jmrothberg/JMR-JS-CSS-FPGA-COMPUTER/traces/README.md

# traces/

Session logs written by the GUI, one per run: `session_<time>_<machine>.log`.
`LATEST_<machine>.log` is the newest for each machine. Read from the end.
Safe to delete.
