jmrothberg/JMR-JS-CSS-FPGA-COMPUTER/releases/current/evidence/README.md

# Build-time record

`build_manifest.json` is the unchanged qualification record made when run73o was generated. The bit's SHA-256 is `cd53d807d1e4346f6ed59dae1a2a48dcc0df80ad64f5e18d02466648a60adecb`.
Its "not programmed" and "standard unchanged" fields refer to that earlier moment. The owner subsequently flashed it to QSPI and reported it running fine. The current selection and board report are in [../../standard.json](../../standard.json).
Original artifact locations remain available through compatibility links. The optional portable ZIP is now in [../../extras/](../../extras/README.md).
