jmrothberg/JMR-JS-CSS-FPGA-COMPUTER/clockInfo.txt

-------------------------------------
| Tool Version : Vivado v.2026.1
| Date         : Tue Nov  3 11:13:20 2026
| Host         : LittleBoy
| Design       : checkpoint_post_opt
| Device       : xc7a200t-sbg484-1--
-------------------------------------

For more information on clockInfo.txt clock routing debug file see https://support.xilinx.com/s/article/000035660?language=en_US
