jmrothberg/JMR-JS-CSS-FPGA-COMPUTER/docs/SESSION_HANDOFF.md

# Session handoff

This is the placeholder for the current session. Write the next status here.
Do not paste an old run log into this page.

Live numbers: [FPGA_FIT.md](FPGA_FIT.md).
Synth rules: [FPGA_FIT.md](FPGA_FIT.md) NEVER table.
Glass: newest file under `traces/` (`*_FPGA-SIM.log`), read from the end.

The November 4 diary that used to fill this page is
`to_delete/notes/SESSION_HANDOFF_2026-11-04.md`.
