jmrothberg/JMR-JS-CSS-FPGA-COMPUTER/docs/README.md

# docs/

Getting started, the main commands and the main limits are in the
[top-level README](../README.md).

| To do this | Read |
|---|---|
| Run the GUI | [GUI_RUNTIME.md](GUI_RUNTIME.md) |
| Plug in keyboard, mice, joystick | [USB_KEYBOARD_PMOD_MICE.md](USB_KEYBOARD_PMOD_MICE.md) |
| Bring up the board, load a bitstream | [FPGA_BRINGUP.md](FPGA_BRINGUP.md) |
| Know which bitstream is current, or build one | [FPGA_FIT.md](FPGA_FIT.md) |
| See what the next bitstream needs | [NEXT_BUILD.md](NEXT_BUILD.md) |
| See the main limits and the common JavaScript that does not work | [../README.md](../README.md#limits-build-99) |
| See every program-facing Toolbox call in one example | `storage/TBDEMO.HTML` (Toolbox Tour) |
| Write a program or game | [GAME_DESIGN.md](GAME_DESIGN.md) |
| Know what JavaScript is supported, and every limit | [JS_COMMANDS.md](JS_COMMANDS.md), [JMR_JS_COMPATIBILITY.md](JMR_JS_COMPATIBILITY.md) |
| Draw, and restore what you drew over | [TOOLBOX_USAGE.md](TOOLBOX_USAGE.md) |
| Use menus, windows, dialogs and files | [SYSTEM_APPLICATIONS.md](SYSTEM_APPLICATIONS.md) |
| Look up a Toolbox call | [TOOLBOX_API.md](TOOLBOX_API.md) |
| Rebuild the resident Toolbox | [RESIDENT_TOOLBOX.md](RESIDENT_TOOLBOX.md) |
| Change fonts and captions | [SYSTEM_RESOURCES.md](SYSTEM_RESOURCES.md) |
| Give a program an icon | [DESKTOP_ICONS.md](DESKTOP_ICONS.md) |
| Understand the machine and its memory map | [ARCHITECTURE.md](ARCHITECTURE.md), [diagrams/](diagrams/README.md) |
| Find a module in the RTL | [RTL_REORG.md](RTL_REORG.md) |
| Write RTL that builds | [RTL_DESIGN_PRINCIPLES.md](RTL_DESIGN_PRINCIPLES.md) |
| Watch the machine run | [ARCH_MONITOR.md](ARCH_MONITOR.md) |
| Look up a term | [WORDS.md](WORDS.md) |
