jmrothberg/JMR-JS-CSS-FPGA-COMPUTER/docs/BIGGER_PART.md

# Bigger FPGA — ruled out

> **RULED OUT 2026-08-23.** We fit the Nexys Video T200 (XC7A200T). A
> larger part would have postponed the ASIC diet. Live numbers:
> [FPGA_FIT.md](FPGA_FIT.md). ASIC hierarchy:
> [CONSTITUTION.md](../CONSTITUTION.md) § ASIC target.

Do not port this netlist to Kintex / UltraScale as a product path.
The old part table and pin checklist are in git
(`git log -- docs/BIGGER_PART.md`).
