jmrothberg/JMR-JS-CSS-FPGA-COMPUTER/archive/builtin-finder-2026-11-03/simulator_roms/README.md

# Previous simulator text ROMs

These match the saved pre-program-Finder executable. Copy these classic_*.hex
files alongside that binary for rollback; the new binary uses the current
vectors/classic_*.hex instead.
