jmrothberg/JMR-JS-CSS-FPGA-COMPUTER/assets/desktop/enterprise.webp

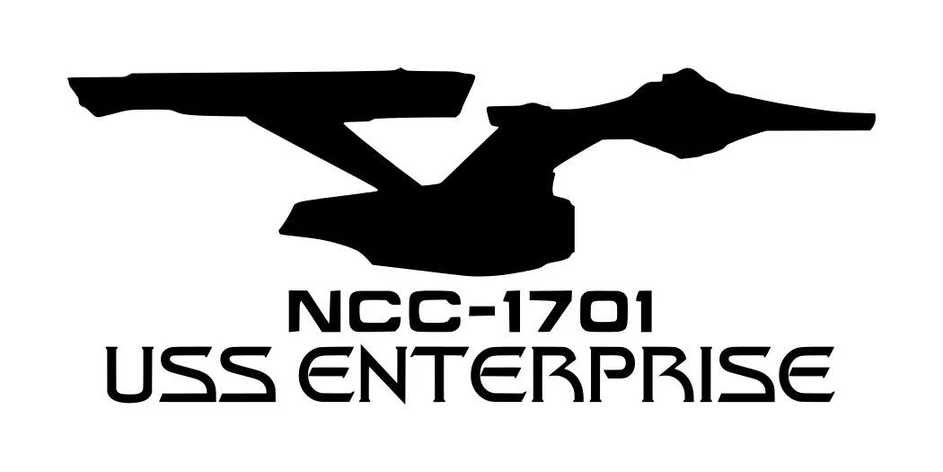
assets/desktop/enterprise.webp
