jmrothberg/JMR-JS-CSS-FPGA-COMPUTER/docs/diagrams/listener_table.png

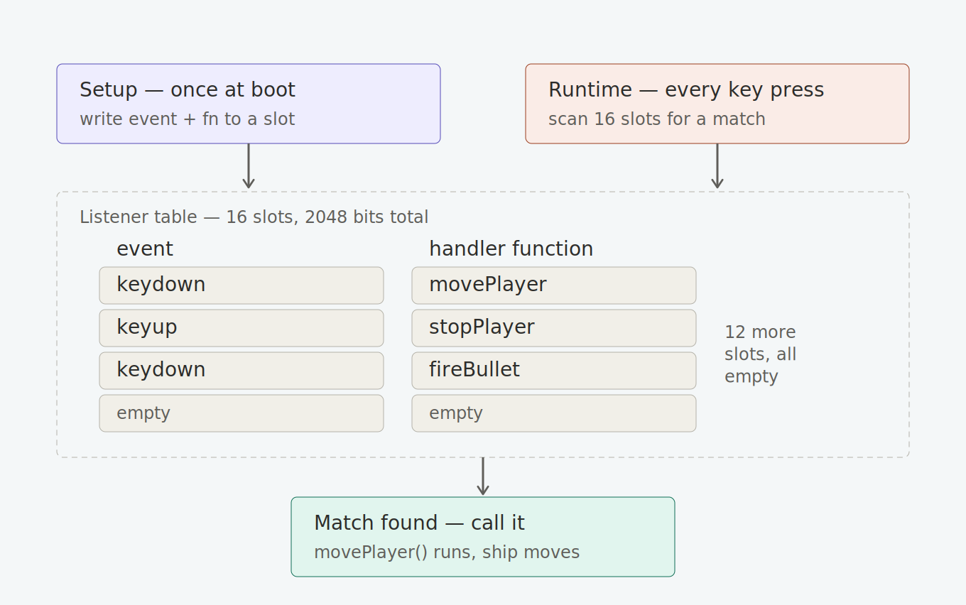
docs/diagrams/listener_table.png
