jmrothberg/JMR-JS-CSS-FPGA-COMPUTER/docs/diagrams/memory-map.png

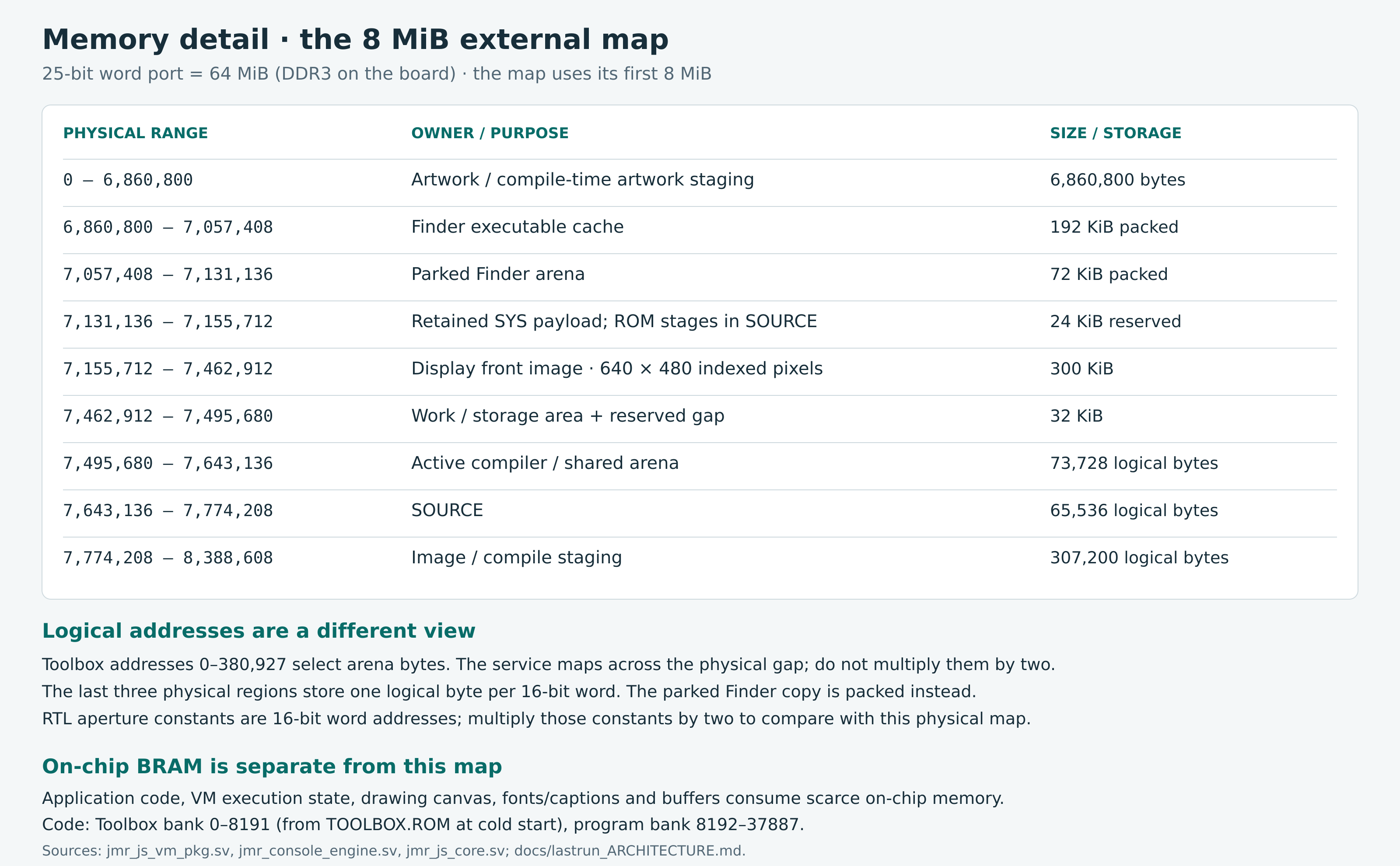
docs/diagrams/memory-map.png
