jmrothberg/JMR-JS-CSS-FPGA-COMPUTER/docs/diagrams/system-sys.png

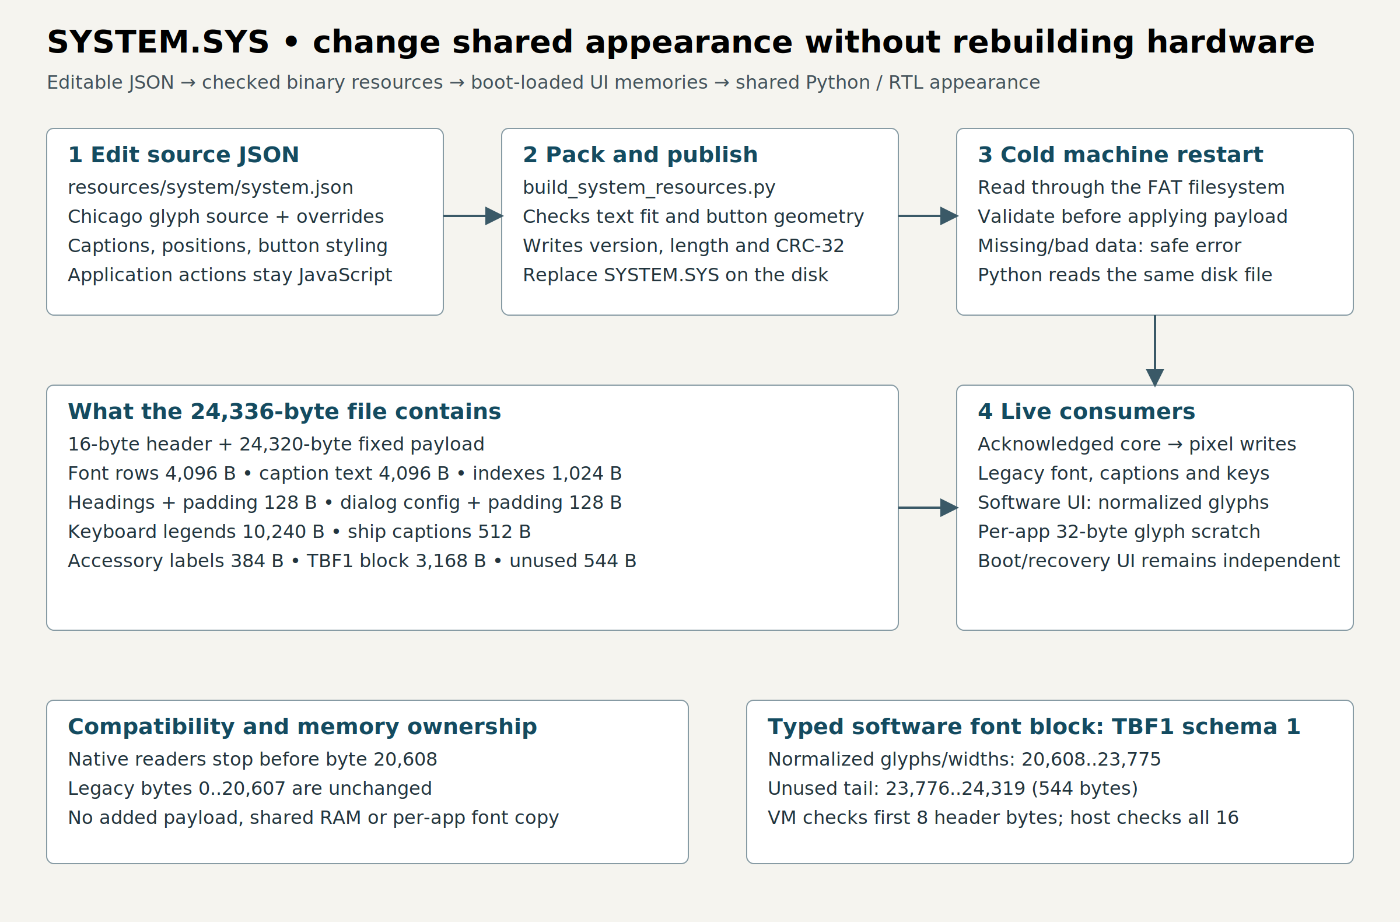
docs/diagrams/system-sys.png
