jmrothberg/JMR-JS-CSS-FPGA-COMPUTER/docs/jmr_js_architecture_v1.png

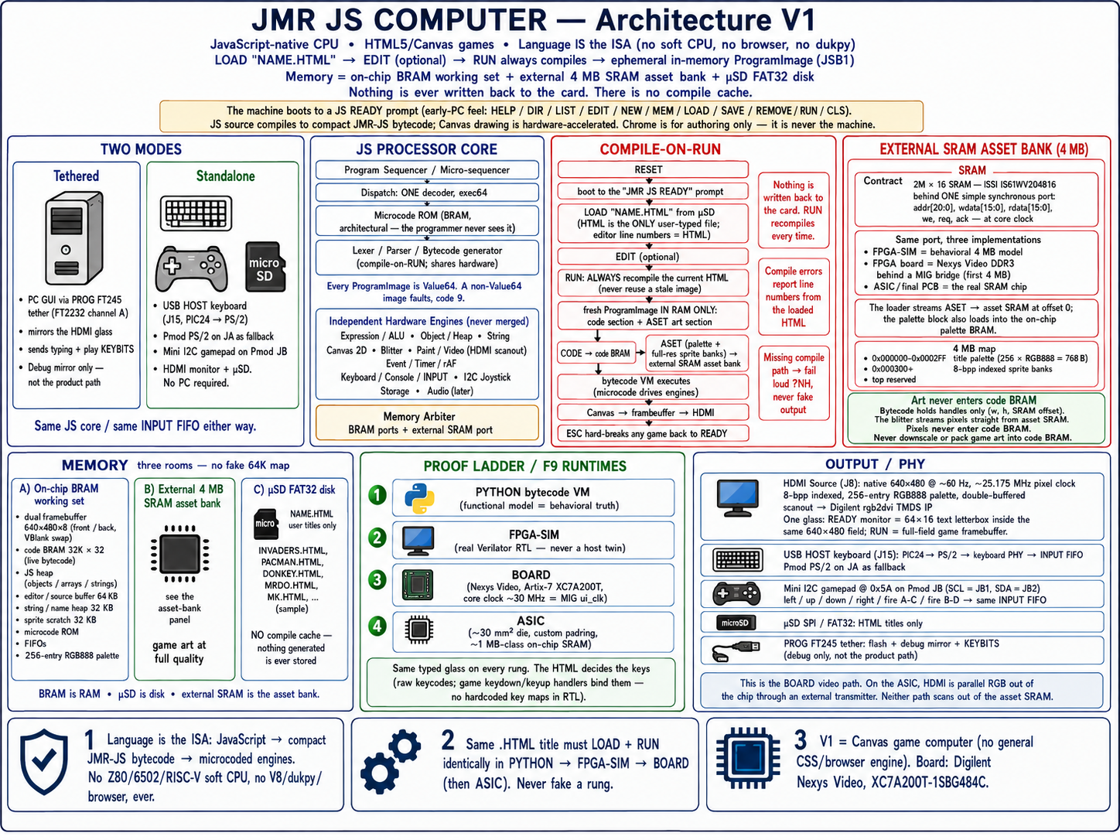
docs/jmr_js_architecture_v1.png
