jmrothberg/JMR-JS-CSS-FPGA-COMPUTER/docs/jmr_js_asic_board_rev_a.png

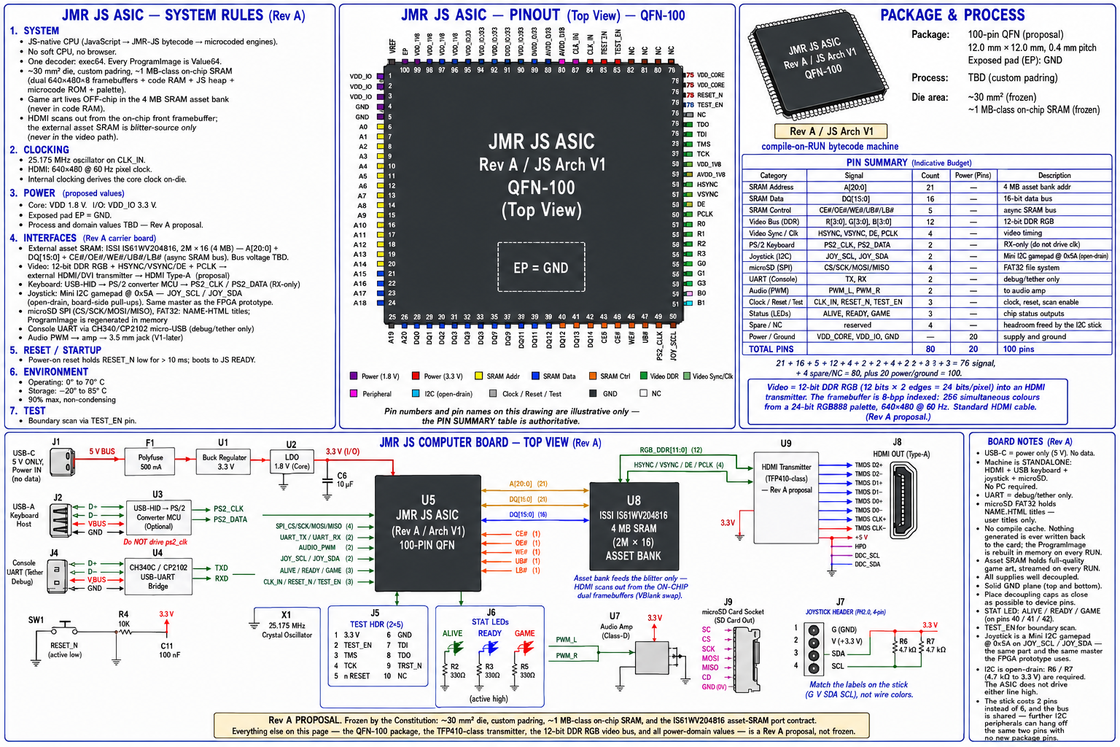
docs/jmr_js_asic_board_rev_a.png
