jmrothberg/JMR-JS-CSS-FPGA-COMPUTER/docs/jmr_js_core_zoom_in.png

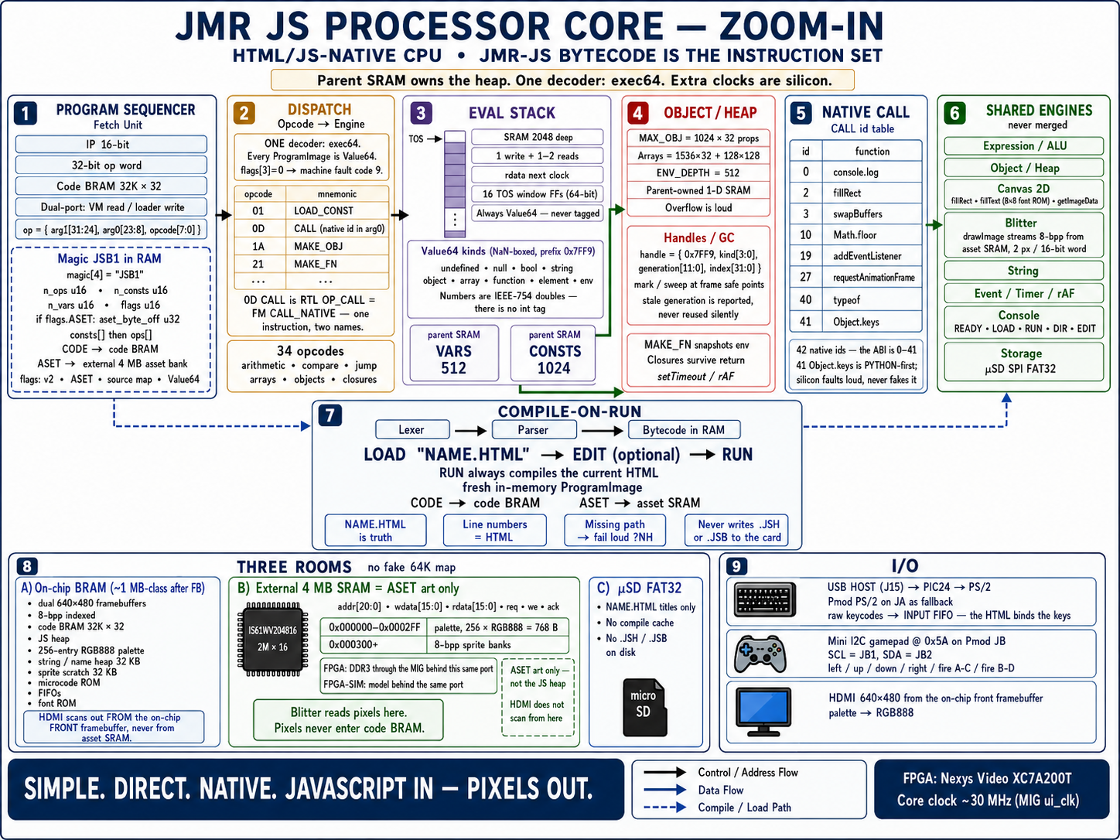
docs/jmr_js_core_zoom_in.png
