jmrothberg/JMR-JS-CSS-FPGA-COMPUTER/Prince/artwork/demo/LC/Persia demo(LC)/150 Torch/150 Torch sheet.png

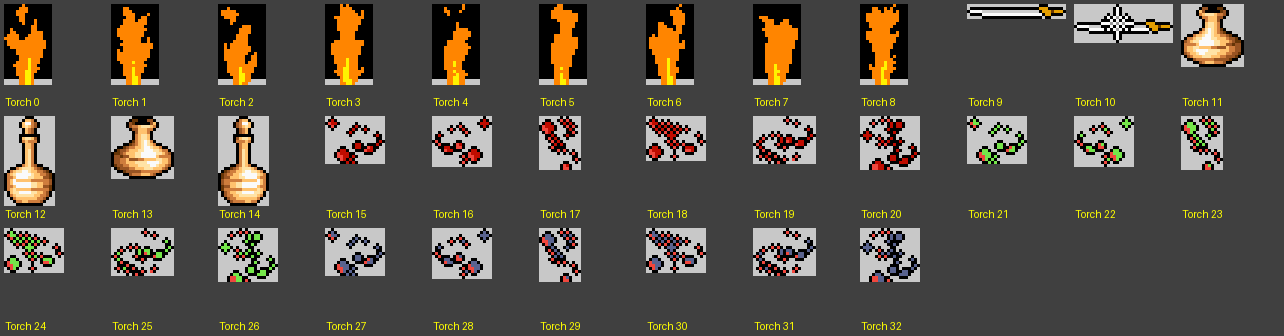
Prince/artwork/demo/LC/Persia demo(LC)/150 Torch/150 Torch sheet.png
