jmrothberg/JMR-JS-CSS-FPGA-COMPUTER/Prince/artwork/full-game/BW/Persia(BW)/40 Title 1/frames/002.png

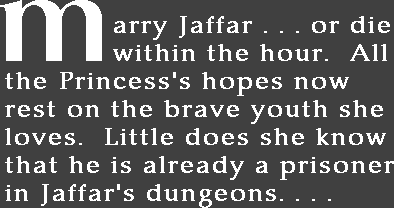
Prince/artwork/full-game/BW/Persia(BW)/40 Title 1/frames/002.png
