jmrothberg/JMR-JS-CSS-FPGA-COMPUTER/Prince/artwork/full-game/BW/Persia(BW)/700 Swords/700 Swords sheet.png

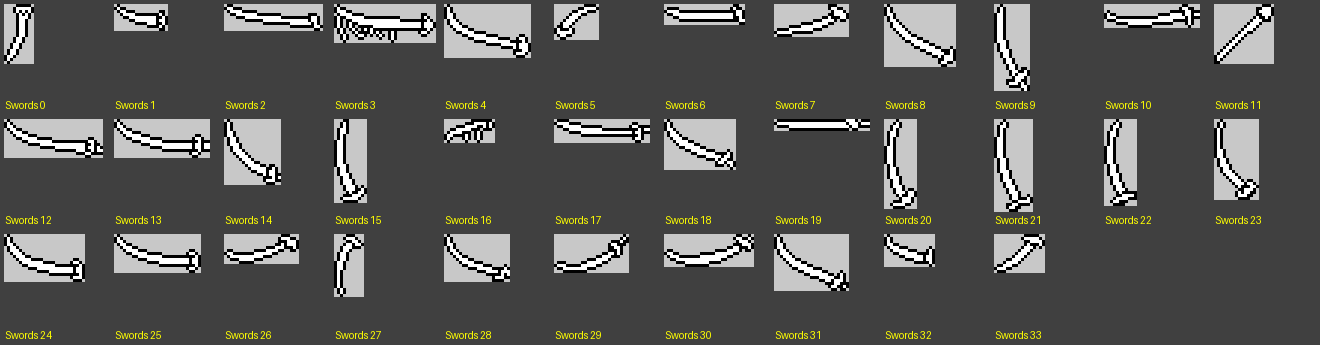
Prince/artwork/full-game/BW/Persia(BW)/700 Swords/700 Swords sheet.png
