jmrothberg/JMR-JS-CSS-FPGA-COMPUTER/Prince/artwork/full-game/BW/Persia(BW)/800 Princess/800 Princess sheet.png

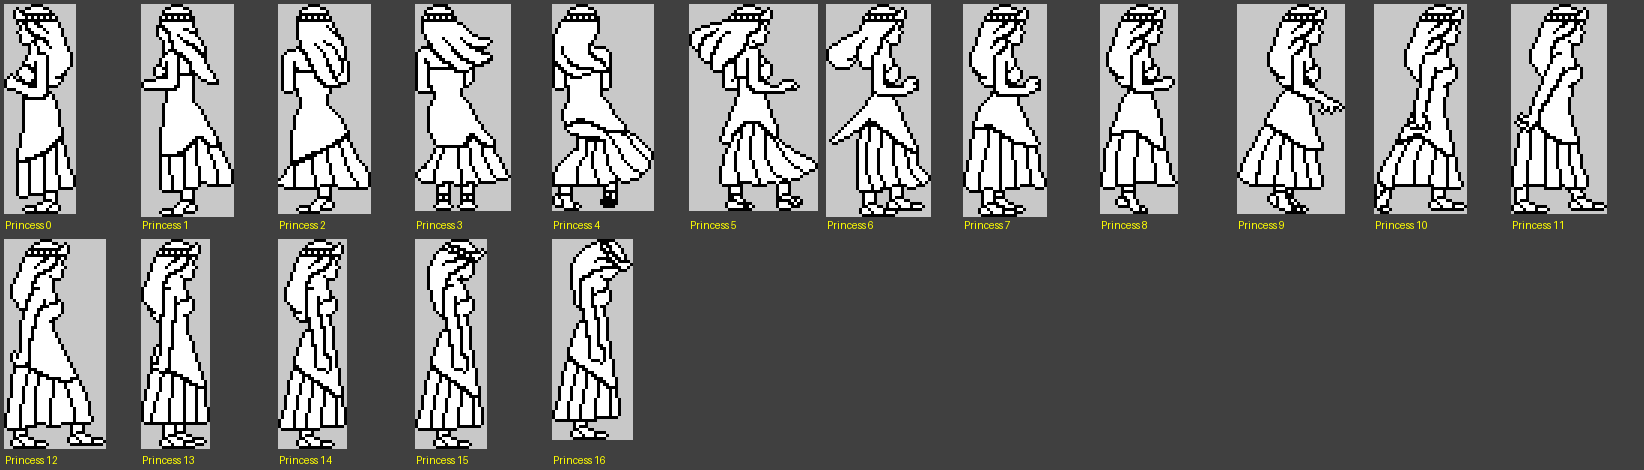
Prince/artwork/full-game/BW/Persia(BW)/800 Princess/800 Princess sheet.png
