jmrothberg/JMR-JS-CSS-FPGA-COMPUTER/Prince/artwork/full-game/BW/Persia(BW)/950 Chamber 1/frames/000.png

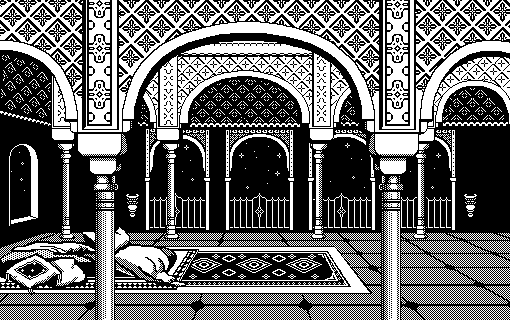
Prince/artwork/full-game/BW/Persia(BW)/950 Chamber 1/frames/000.png
