jmrothberg/JMR-JS-CSS-FPGA-COMPUTER/Prince/artwork/full-game/COLOR/Persia(COLOR)/40 Title 1/frames/001.png

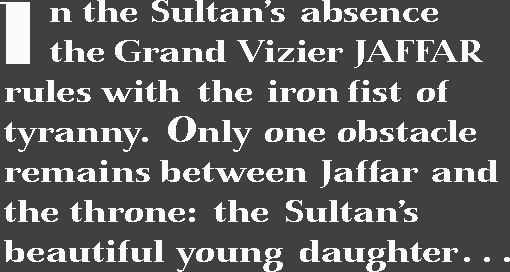
Prince/artwork/full-game/COLOR/Persia(COLOR)/40 Title 1/frames/001.png
