jmrothberg/JMR-JS-CSS-FPGA-COMPUTER/Prince/artwork/full-game/COLOR/Persia(COLOR)/50 Title 2/frames/000.png

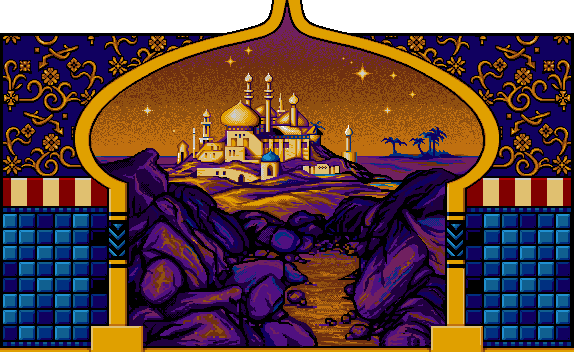
Prince/artwork/full-game/COLOR/Persia(COLOR)/50 Title 2/frames/000.png
