jmrothberg/JMR-JS-CSS-FPGA-COMPUTER/Prince/artwork/full-game/COLOR/Persia(COLOR)/900 Princess 2/900 Princess 2 sheet.png

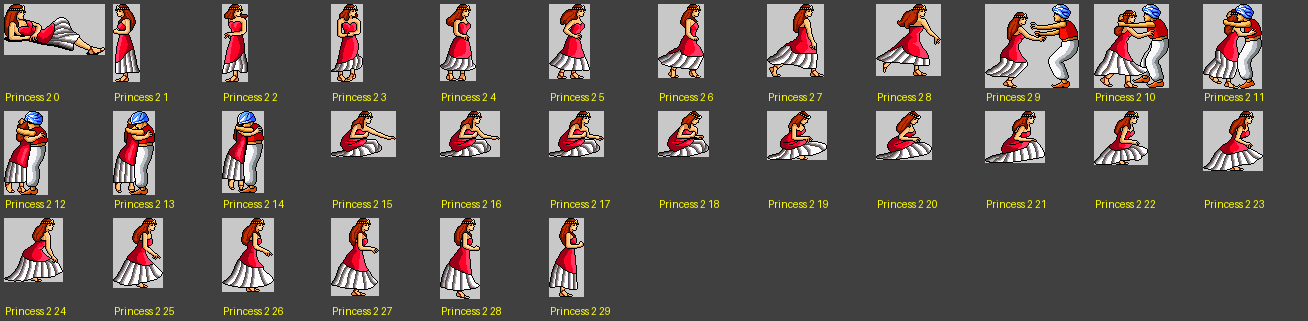
Prince/artwork/full-game/COLOR/Persia(COLOR)/900 Princess 2/900 Princess 2 sheet.png
