jmrothberg/JMR-JS-CSS-FPGA-COMPUTER/Prince/artwork/full-game/COLOR/Persia(COLOR)/2360 Palace blocks/2360 Palace blocks sheet.png

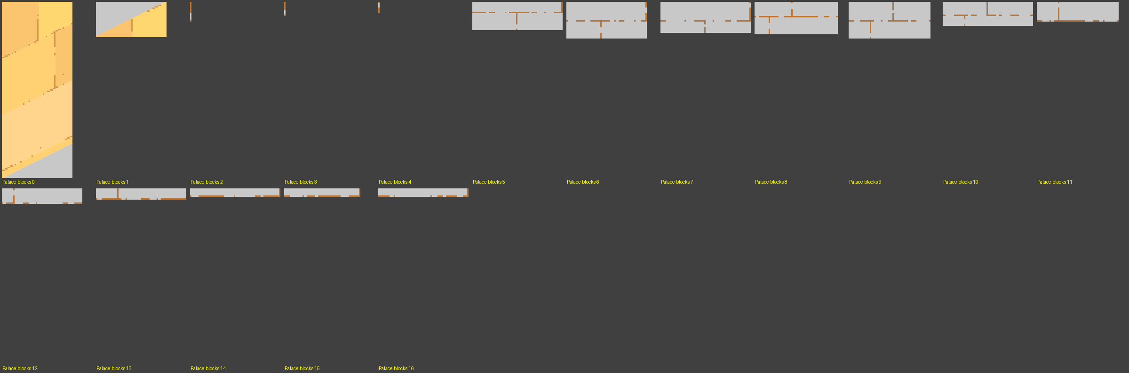
Prince/artwork/full-game/COLOR/Persia(COLOR)/2360 Palace blocks/2360 Palace blocks sheet.png
