jmrothberg/JMR-JS-CSS-FPGA-COMPUTER/Prince/artwork/full-game/LC/Persia(LC)/4750 Shadow/4750 Shadow sheet.png

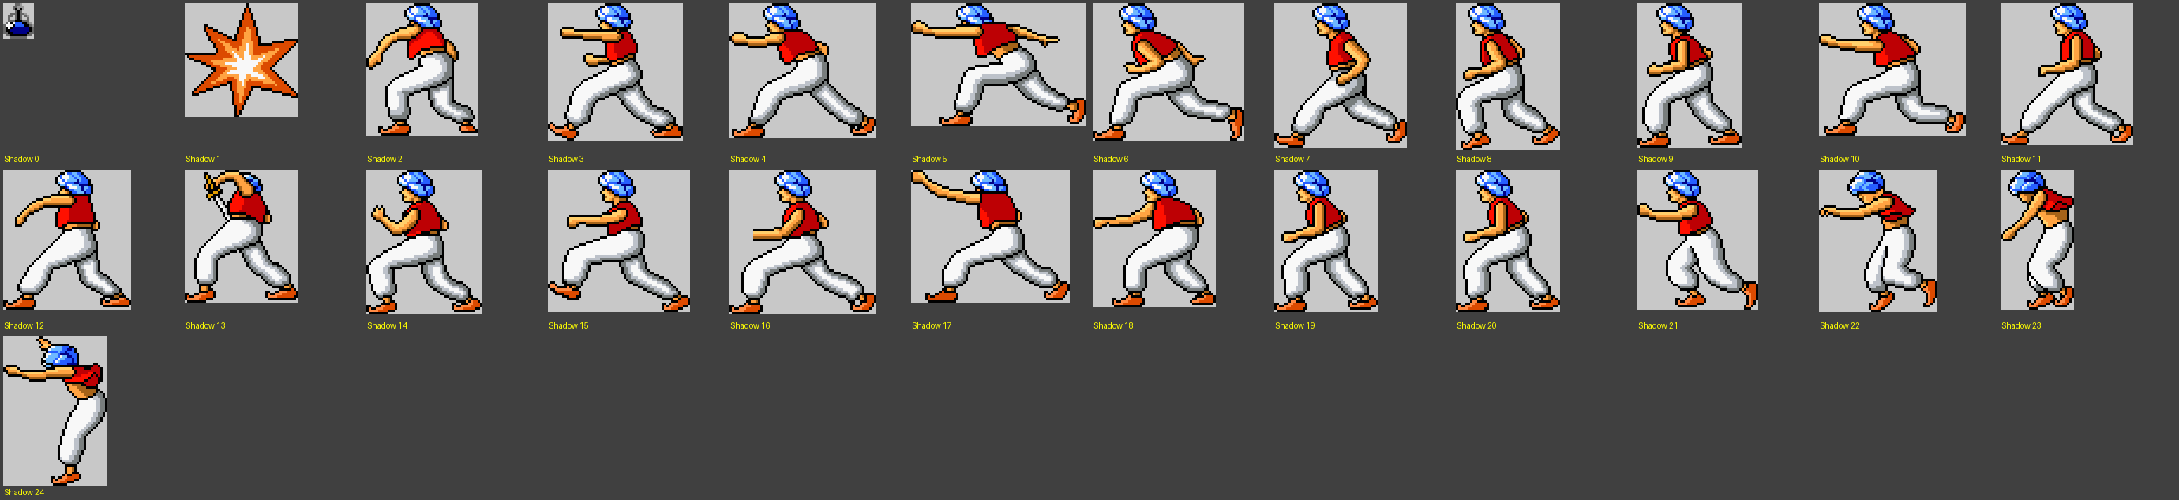
Prince/artwork/full-game/LC/Persia(LC)/4750 Shadow/4750 Shadow sheet.png
