jmrothberg/JMR-JS-CSS-FPGA-COMPUTER/storage/PRINCE-0.png

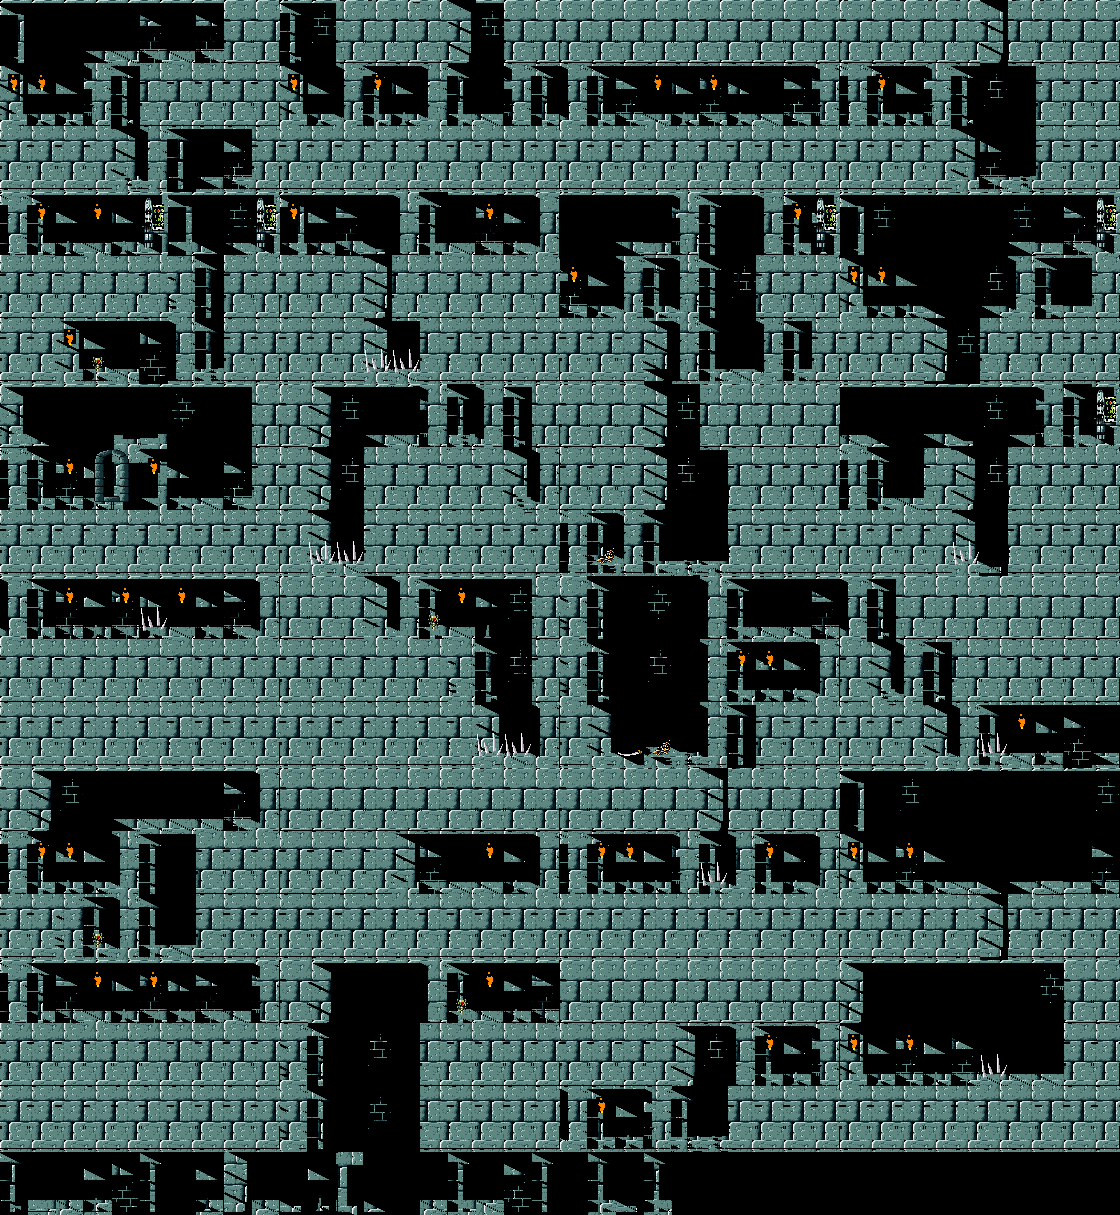
storage/PRINCE-0.png
