jmrothberg/JMR-JS-CSS-FPGA-COMPUTER/tight_setup_hold_pins.txt

+====================+===================+=======================================================================================================================================================================================================================================+
| Launch Setup Clock | Launch Hold Clock | Pin                                                                                                                                                                                                                                   |
+====================+===================+=======================================================================================================================================================================================================================================+
| clk_pll_i          | clk_pll_i         | u_core/u_classic/record_col_reg[2]/D                                                                                                                                                                                                  |
| clk_pll_i          | clk_pll_i         | u_core/u_classic/bar_x_reg[6]/D                                                                                                                                                                                                       |
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
| clk_pll_i          | clk_pll_i         | u_core/u_mouse_events/dy_reg[2]/D                                                                                                                                                                                                     |
| oserdes_clk_2      | oserdes_clk_2     | u_mig/u_mig_7series_0_mig/u_memc_ui_top_std/mem_intfc0/ddr_phy_top0/u_ddr_mc_phy_wrapper/u_ddr_mc_phy/ddr_phy_4lanes_0.u_ddr_phy_4lanes/ddr_byte_lane_C.ddr_byte_lane_C/ddr_byte_group_io/output_[9].oserdes_dq_.ddr.oserdes_dq_i/RST |
+--------------------+-------------------+---------------------------------------------------------------------------------------------------------------------------------------------------------------------------------------------------------------------------------------+
