jmrothberg/JMR-JS-CSS-FPGA-COMPUTER/runtime/vm_state_names.py

"""Generated from the selected jmr_js_vm.sv st_t declaration."""
RTL_SHA256 = 'a6dd29b7cb72a605179c41958641c8cdaa212bd709210a5e17e291a15350f078'
VM_STATE_NAMES = (
    'S_IDLE',
    'S_RD',
    'S_GOT_MAGIC',
    'S_GOT_HDR1',
    'S_GOT_HDR2',
    'S_LD_CONST',
    'S_TRAIL',
    'S_FETCH_WAIT',
    'S_CLEAR',
    'S_RECT',
    'S_CIRCLE',
    'S_LINE',
    'S_BLIT',
    'S_SPR',
    'S_WAIT_FRAME',
    'S_DONE',
    'S_XF_MUL',
    'S_XF_APPLY',
    'S_PWALK',
    'S_PDO',
    'S_QSEG',
    'S_QPX',
    'S_QPY',
    'S_JOIN',
    'S_JOIN_FIND',
    'S_CONCAT',
    'S_SQRT',
    'S_JSON_PARSE',
    'S_REPL',
    'S_IDXSTR',
    'S_FONTPX',
    'S_TXT_LD',
    'S_TXT_DRAW',
    'S_STR_WR',
    'S_IMGD_GET',
    'S_IMGD_PUT',
    'S_NAMCPY',
    'S_V64_CONST_HI',
    'S_V64_EXEC',
    'S_V64_DIV',
    'S_V64_DIV_FIN',
    'S_V64_MOD',
    'S_V64_ALLOC',
    'S_V64_GC_CLEAR',
    'S_V64_GC_ROOT',
    'S_V64_GC_POP',
    'S_V64_GC_OBJ',
    'S_V64_GC_ARR',
    'S_V64_GC_SWEEP_OBJ',
    'S_V64_GC_SWEEP_ARR',
    'S_V64_GC_FN',
    'S_V64_GC_ENV',
    'S_V64_GC_SWEEP_ENV',
    'S_V64_CLEAR',
    'S_V64_RECT',
    'S_V64_FRAME_RAF',
    'S_V64_FRAME_TIMER',
    'S_V64_FOREACH',
    'S_V64_FRAME_KEY',
    'S_V64_STRIDX',
    'S_V64_STRIDX_WR',
    'S_V64_JSON',
    'S_V64_JSON_PARSE',
    'S_V64_CTOR_PAD',
    'S_HEAP_WAIT',
    'S_HEAP_CMP',
    'S_HEAP_WR',
    'S_HEAP_AWR',
    'S_HEAP_FILL',
    'S_V64_METH',
    'S_V64_FE_ELEM',
    'S_V64_FE_FILTER',
    'S_V64_OGETI_NAT',
    'S_V64_IDXSCAN',
    'S_V64_CTOR_ENV',
    'S_V64_CTOR_VARS',
    'S_FREE_OBJ',
    'S_FREE_ARR',
    'S_V64_BIND',
    'S_V64_MINMAX',
    'S_V64_WIN_FILL',
    'S_ARR_PROMOTE',
    'S_V64_RECT_LD',
    'S_HEAP_CLR',
    'S_V64_SLICE',
    'S_V64_SORT',
    'S_FB_SYNC',
    'S_V64_DISPATCH',
    'S_CSRAM',
    'S_V64_MOUSE_PROP',
    'S_UI_PROP',
    'S_FS',
    'S_V64_KEYS',
    'S_V64_BYTESTRING',
    'S_V64_CALLREF',
)
