jmrothberg/JMR-JS-CSS-FPGA-COMPUTER/rtl/engines/jmr_js_vm_exec64.sv

// Hierarchical opcode/native decoder. Same clk as jmr_js_vm.
// Enable when state==S_V64_EXEC. Case text from the parent always_ff.
import jmr_js_vm_pkg::*;
import jmr_value_pkg::*;
module jmr_js_vm_exec64 (
    input  logic clk,
    input logic image_callref,
    input  logic rst_n,
    input  logic enable,
    output logic arg_stack_read,
    output logic [11:0] arg_stack_addr,
    input logic [63:0] arg_stack_data,
    output logic leave_hold,
    input  logic hs_m_ip,
    input  logic hs_m_code,
    input  logic p_pf_block, // parent ctor-scan/redirect machinery armed
    input  logic hs_m_state,
    input  logic hs_m_vsp,
    input  logic hs_m_hp_cmd,
    input  logic hs_m_hp_oid,
    input  logic hs_m_hp_aid,
    input  logic hs_m_hp_env,
    input  logic hs_m_hp_eid,
    input  logic hs_m_hp_slot,
    input  logic hs_m_hp_aslot,
    input  logic hs_m_hp_len,
    input  logic hs_m_hp_alen,
    input  logic hs_m_hp_lim,
    input  logic hs_m_hp_key,
    input  logic hs_m_hp_wval,
    input  logic hs_m_hp_rval,
    input  logic hs_m_hp_hit,
    input  logic hs_m_hp_ret,
    input  logic hs_m_hp_phase,
    input  logic hs_m_hp_qn,
    input  logic hs_m_hp_qi,
    input  logic hs_m_hp_si,
    input  logic hs_m_hp_ss,
    input  logic hs_m_hp_tn,
    input  logic hs_m_hp_from_stack,
    input  logic hs_m_hp_make_arr,
    input  logic hs_m_hp_vbase,
    input  logic hs_m_hp_spr_w,
    input  logic hs_m_hp_spr_h,
    input  logic hs_m_hp_nat,
    input  logic hs_m_hp_qk,
    input  logic hs_m_hp_qv,
    input  logic hs_m_hp_qt,
    input  logic hs_m_valloc_kind,
    input  logic hs_m_valloc_i,
    input  logic hs_m_valloc_arr_n,
    input  logic hs_m_valloc_retried,
    input  logic hs_m_vnat_dom,
    input  logic hs_m_vnat_base,
    input  logic hs_m_valloc_now_fn,
    input  logic hs_m_valloc_bind,
    input  logic hs_m_valloc_bind_src,
    input  logic hs_m_valloc_bind_this,
    input  logic hs_m_valloc_fn_entry,
    input  logic hs_m_valloc_fn_a1,
    input  logic hs_m_valloc_proto,
    input  logic hs_m_valloc_proto_fn,
    input  logic hs_m_valloc_metrics,
    input  logic hs_m_valloc_regex,
    input  logic hs_m_valloc_regex_pack,
    input  logic hs_m_vcall_value,
    input  logic hs_m_vcall_argc,
    input  logic hs_m_vcall_entry,
    input  logic hs_m_vcall_set_this,
    input  logic hs_m_vcall_this,
    input  logic hs_m_vcall_ctor_val,
    input  logic hs_m_vcsp,
    input  logic hs_m_vthis,
    input  logic hs_m_venv,
    input  logic hs_m_vraf_n,
    input  logic hs_m_vlistener_n,
    input  logic hs_m_vgc_halt_after,
    input  logic hs_m_vgc_wait_after,
    input  logic hs_m_vgc_clear_i,
    input  logic hs_m_vgc_qr,
    input  logic hs_m_vgc_qw,
    input  logic hs_m_vdraw_i,
    input  logic hs_m_vdraw_x,
    input  logic hs_m_vdraw_y,
    input  logic hs_m_vdraw_w,
    input  logic hs_m_vdraw_h,
    input  logic hs_m_vdraw_color,
    // Parent FOREACH walks vfe_i / pops nest; exec owns the FFs (CALL_METHOD
    // plants them). Without these pokes, parent vfe_* stay UNDEF and the
    // done path jumps to ip=0 until vfe_sp>=8 (INVADERS fault 3).
    input  logic hs_m_vfe_i,
    input  logic hs_m_vfe_pop,
    output logic [7:0] bind_argc_q,
    output logic [11:0] bind_base_q,
    output logic [15:0] bind_ip_q,
    output logic [7:0] bind_k_q,
    output logic [1:0] bind_mode_q,
    output logic [7:0] bind_n_q,
    output logic bind_rd_arm_q,
    output logic [6:0] bind_ret_q,
    output logic [11:0] bind_src_q,
    output logic [11:0] bind_vsp_next_q,
    output logic [15:0] blit_sh_q,
    output logic [7:0] blit_si_q,
    output logic flip_x_q, // neg-xform: mirror dest x (negative dWidth/scale)
    output logic flip_y_q, // neg-xform: mirror dest y (negative dHeight/scale)
    output logic [15:0] blit_sw_q,
    output logic [15:0] blit_sx_q,
    output logic [15:0] blit_sy_q,
    output logic [2:0] cc_at_q,
    output logic signed [31:0] cc_av_q,
    output logic cc_bok_q,
    output logic [2:0] cc_bt_q,
    output logic signed [31:0] cc_bv_q,
    output logic [3:0] cc_d_q,
    output logic [15:0] cc_h_q,
    output logic [7:0] cc_len_q,
    output logic cc_second_q,
    output logic [1:0] cc_st_q,
    output logic [15:0] code_raddr_q,
    output logic [31:0] opw_out, // op word as EXEC sees it (captured)
    output logic [7:0] color_q,
    output logic [1:0] ctx_align_q,
    output logic signed [31:0] ctx_sx_q,
    output logic signed [31:0] ctx_sy_q,
    output logic signed [31:0] ctx_tx_q,
    output logic signed [31:0] ctx_ty_q,
    output logic [15:0] dbg_di_hit_q,
    output logic [15:0] dbg_di_miss_q,
    output logic [7:0] fault_code_q,
    output logic [15:0] fault_site_q,
    output logic [31:0] fault_arg_q,   // G-line: the value that faulted (index/nid)
    output logic [18:0] fb_dump_addr_q,
    output logic fb_swap_q,
    output logic [11:0] hp_aid_q,
    output logic [7:0] hp_alen_q,
    output logic [6:0] hp_aslot_q,
    output logic [3:0] hp_cmd_q,
    output logic [9:0] hp_eid_q,
    output logic hp_env_q,
    output logic hp_from_stack_q,
    output logic hp_hit_q,
    output logic [15:0] hp_key_q,
    output logic [5:0] hp_len_q,
    output logic [7:0] hp_lim_q,
    output logic hp_make_arr_q,
    output logic [3:0] hp_nat_q,
    output logic [12:0] hp_oid_q,
    output logic [2:0] hp_phase_q,
    output logic [63:0] hp_proto_q,
    output logic [2:0] hp_qi_q,
    output logic [63:0] hp_qk_pack_q,
    output logic [2:0] hp_qn_q,
    output logic [11:0] hp_qt_pack_q,
    output logic [255:0] hp_qv_pack_q,
    output logic [6:0] hp_ret_q,
    output logic [63:0] hp_rval_q,
    output logic [12:0] hp_si_q,
    output logic [4:0] hp_slot_q,
    output logic [15:0] hp_spr_h_q,
    output logic [15:0] hp_spr_w_q,
    output logic [4:0] hp_ss_q,
    output logic [5:0] hp_tn_q,
    output logic [11:0] hp_vbase_q,
    output logic [63:0] hp_wval_q,
    output logic [9:0] imgd_h_q,
    output logic [18:0] imgd_i_q,
    output logic [18:0] imgd_n_q,
    output logic imgd_v64_q,
    output logic [9:0] imgd_w_q,
    output logic [9:0] imgd_x_q,
    output logic [9:0] imgd_x0_q,
    output logic [9:0] imgd_y_q,
    output logic [9:0] imgd_y0_q,
    output logic [15:0] ip_q,
    output logic [11:0] jn_arr_q,
    output logic [15:0] jn_h_q,
    output logic [15:0] jn_i_q,
    output logic [10:0] jn_res_q,
    output logic [5:0] js_sp_q,
    output logic [2:0] json_pph_q,
    output logic [13:0] json_rp_q,
    output logic [13:0] json_src_q,
    output logic [13:0] json_srclen_q,
    output logic [13:0] json_wp_q,
    output logic machine_fault_q,
    output logic [63:0] minmax_acc_q,
    // Bytes of HTML the console made available at SRC_SRAM_BASE. A wire,
    // not a state: exporting a console register is ~18 flops, where poking
    // the value through memory would cost two encodings we do not have.
    input  logic [17:0] src_len_i,
    // cdone() handshake — the compiler's only exit report.
    output logic        cmp_done_q,
    output logic [7:0]  cmp_status_q,
    output logic [20:0] cmp_len_q,
    output logic [6:0]  cmp_msglen_q,
    // V1.5 standalone compile: the scalars S_CSRAM needs. mode selects
    // 0 srcByte, 1 stgRead, 2 stgWrite, 3 artWrite2.
    output logic [2:0]  csr_mode_q,
    output logic [21:0] csr_addr_q,
    output logic [15:0] csr_wdata_q,
    // srcSetLen (nid 50): SOURCE length published to the console so an
    // edit made by a PROGRAM is visible to LIST / SAVE / COMPILE.
    output logic [17:0] src_setlen_q,
    output logic        src_setlen_stb_q,
    output logic        csr_oob_q,
    input logic [175:0] id_sys_window,
    input logic [1:0] fs_arg_index,
    output logic [63:0] fs_arg_value,
    output logic sysw_toggle_q,
    output logic [3:0] sysw_field_q,
    output logic [31:0] sysw_value_q,
    output logic [11:0] minmax_base_q,
    output logic minmax_is_min_q,
    output logic [7:0] minmax_k_q,
    output logic [7:0] minmax_n_q,
    output logic namcpy_repl_q,
    output logic namcpy_v64_q,
    output logic [15:0] name_rdaddr_q,
    // The parent owns the pc_* arrays that S_PWALK /
    // S_PDO / S_LINE / S_CIRCLE / S_QSEG raster from, but nothing ever wrote
    // them (pc_n stuck at 0 => S_PWALK aborted on its first beat and every
    // path primitive painted nothing). Mirror this exec's writes out.
    // JSON.stringify seeds vjs_val[0] via js_we into
    // exec's OWN copy; the parent S_V64_JSON arm walks the PARENT copy.
    // Mirror the write out (same shape as the #49 pc_we mirror).
    output logic js_we_q,
    output logic [4:0] js_waddr_q,
    output logic [7:0] js_i_wdata_q,
    output logic [2:0] js_ph_wdata_q,
    output logic [63:0] vjs_val_wdata_q,
    output logic pc_we_q,
    output logic [3:0] pc_waddr_q,
    output logic [1:0] pc_op_wdata_q,
    output logic signed [31:0] pc_a1_wdata_q,
    output logic signed [31:0] pc_a2_wdata_q,
    output logic signed [31:0] pc_a3_wdata_q,
    output logic signed [31:0] pc_a4_wdata_q,
    output logic signed [31:0] pc_a5_wdata_q,
    output logic pc_ccw_wdata_q,
    output logic path_stroke_q,
    output logic [4:0] pc_n_q,
    output logic repl_g_q,
    output logic [7:0] repl_pat0_q,
    output logic [7:0] repl_rch_q,
    output logic [9:0] rh_q,
    output logic [9:0] rw_q,
    output logic signed [11:0] rx_q,
    output logic signed [11:0] ry_q,
    output logic [4:0] sq_i_q,
    output logic [63:0] sq_rad_q,
    output logic [25:0] sq_rem_q,
    output logic [23:0] sq_root_q,
    output logic [6:0] state_q,
    output logic [6:0] txt_bn_q,
    output logic [3:0] txt_ph_q,
    output logic signed [15:0] txt_px_q,
    output logic signed [15:0] txt_py_q,
    output logic [31:0] txt_val_q,
    output logic [2:0] txt_vt_q,
    output logic v64_concat_q,
    output logic v64_join_q,
    output logic v64_sqrt_q,
    output logic [7:0] valloc_arr_n_q,
    output logic valloc_bind_q,
    output logic [12:0] valloc_bind_src_q,
    output logic [63:0] valloc_bind_this_q,
    output logic [7:0] valloc_fn_a1_q,
    output logic [15:0] valloc_fn_entry_q,
    output logic [13:0] valloc_i_q,
    output logic [1:0] valloc_kind_q,
    output logic valloc_metrics_q,
    output logic valloc_now_fn_q,
    output logic valloc_proto_q,
    output logic [12:0] valloc_proto_fn_q,
    output logic valloc_regex_q,
    output logic [31:0] valloc_regex_pack_q,
    output logic valloc_retried_q,
    output logic [11:0] vcall_argc_q,
    output logic [63:0] vcall_ctor_val_q,
    output logic [15:0] vcall_entry_q,
    output logic vcall_set_this_q,
    output logic [63:0] vcall_this_q,
    output logic vcall_value_q,
    output logic [7:0] vcsp_q,
    output logic [7:0] vdiv_count_q,
    output logic [52:0] vdiv_den_q,
    output logic signed [12:0] vdiv_exp_q,
    output logic [106:0] vdiv_num_q,
    output logic [106:0] vdiv_quot_q,
    output logic [53:0] vdiv_rem_q,
    output logic vdiv_sign_q,
    output logic [7:0] vdraw_color_q,
    output logic [9:0] vdraw_h_q,
    output logic [18:0] vdraw_i_q,
    output logic [9:0] vdraw_w_q,
    output logic [9:0] vdraw_x_q,
    output logic [9:0] vdraw_y_q,
    output logic [63:0] venv_q,
    output logic [63:0] vfe_arr_q,
    output logic [11:0] vfe_base_q,
    output logic [63:0] vfe_fn_q,
    output logic [7:0] vfe_i_q,
    output logic [7:0] vfe_len_q,
    output logic [63:0] vfe_map_q,
    output logic [1:0] vfe_mode_q,
    output logic [15:0] vfe_ret_q,
    output logic [3:0] vfe_sp_q,
    output logic [13:0] vgc_clear_i_q,
    output logic vgc_halt_after_q,
    output logic [13:0] vgc_qr_q,
    output logic [13:0] vgc_qw_q,
    output logic vgc_wait_after_q,
    output logic [4:0] vlistener_n_q,
    output logic [31:0] vmetrics_w_q,
    output logic [11:0] vmod_count_q,
    output logic [52:0] vmod_den_q,
    output logic signed [12:0] vmod_exp_q,
    output logic [52:0] vmod_rem_q,
    output logic vmod_sign_q,
    output logic [11:0] vnat_base_q,
    output logic [2:0] vnat_dom_q,
    output logic vprom_copy_q,
    output logic [6:0] vprom_ret_q,
    output logic [3:0] vraf_n_q,
    output logic [11:0] vsp_q,
    output logic vst_hold_win_q,
    output logic vst_refill_arm_q,
    output logic [3:0] vst_refill_i_q,
    output logic [6:0] vst_refill_ret_q,
    output logic [11:0] vst_waddr_q,
    output logic [63:0] vst_wdata_q,
    output logic vst_we_q,
    output logic [63:0] vthis_q,
    output logic [9:0] x_q,
    output logic [9:0] y_q,
    output logic p_clr_busy_q,
    input  logic [15:0] p_code_raddr,
    input  logic [31:0] code_rdata,
    input  logic [11:0] p_hp_aid,
    input  logic [7:0] p_hp_alen,
    input  logic [6:0] p_hp_aslot,
    input  logic [3:0] p_hp_cmd,
    input  logic [9:0] p_hp_eid,
    input  logic p_hp_env,
    input  logic p_hp_from_stack,
    input  logic p_hp_hit,
    input  logic [15:0] p_hp_key,
    input  logic [5:0] p_hp_len,
    input  logic [7:0] p_hp_lim,
    input  logic p_hp_make_arr,
    input  logic [3:0] p_hp_nat,
    input  logic [12:0] p_hp_oid,
    input  logic [2:0] p_hp_phase,
    input  logic [2:0] p_hp_qi,
    input  logic [63:0] p_hp_qk_pack,
    input  logic [2:0] p_hp_qn,
    input  logic [11:0] p_hp_qt_pack,
    input  logic [255:0] p_hp_qv_pack,
    input  logic [6:0] p_hp_ret,
    input  logic [63:0] p_hp_rval,
    input  logic [12:0] p_hp_si,
    input  logic [4:0] p_hp_slot,
    input  logic [15:0] p_hp_spr_h,
    input  logic [15:0] p_hp_spr_w,
    input  logic [4:0] p_hp_ss,
    input  logic [5:0] p_hp_tn,
    input  logic [11:0] p_hp_vbase,
    input  logic [63:0] p_hp_wval,
    input  logic [15:0] id_ael,
    input  logic [15:0] id_arc,
    input  logic [15:0] id_assign,
    input  logic [15:0] id_beginpath,
    input  logic [15:0] id_bind,
    input  logic [15:0] id_black,
    input  logic [15:0] id_center,
    input  logic [15:0] id_clearrect,
    input  logic [15:0] id_closepath,
    input  logic [15:0] id_drawimage,
    input  logic [15:0] id_fill,
    input  logic [15:0] id_fillrect,
    input  logic [15:0] id_fillstyle,
    input  logic [15:0] id_font,
    input  logic [15:0] id_disp,
    input  logic [15:0] id_filltext,
    input  logic [15:0] id_filter,
    input  logic [15:0] id_slice, // #40 Array.slice
    input  logic [15:0] id_sort, // #41 Array.sort
    input  logic [15:0] id_reduce, // Array.reduce
    output logic vfe_reduce_q,
    output logic vfe_findidx_q,
    input  logic [15:0] id_find,
    input  logic [15:0] id_findindex,
    input  logic [15:0] id_foreach,
    input  logic [15:0] id_getctx,
    input  logic [15:0] id_getimgdata,
    input  logic [15:0] id_gettime,
    input  logic [15:0] id_height,
    input  logic [15:0] id_hex_000,
    input  logic [15:0] id_hex_fff,
    input  logic [15:0] id_imgsmooth,
    input  logic [15:0] id_indexof,
    input  logic [15:0] id_join,
    input  logic [15:0] id_length,
    input  logic [15:0] id_lineto,
    input  logic [15:0] id_quadcurve,   // #38, needs #49 to be visible
    input  logic [15:0] id_map,
    input  logic [15:0] id_measuretext,
    input  logic [15:0] id_moveto,
    input  logic [15:0] id_now,
    input  logic [15:0] id_onload,
    input  logic [15:0] id_pop,
    input  logic [15:0] id_proto,
    input  logic [15:0] id_push,
    input  logic [15:0] id_putimgdata,
    input  logic [15:0] id_replace,
    input  logic [15:0] id_restore,
    input  logic [15:0] id_right,
    input  logic [15:0] id_save,
    input  logic [15:0] id_settransform,
    input  logic [15:0] id_splice,
    input  logic [15:0] id_src,
    input  logic [15:0] id_str_function,
    input  logic [15:0] id_str_boolean,
    input  logic [15:0] id_str_number,
    input  logic [15:0] id_str_object,
    input  logic [15:0] id_str_string,
    input  logic [15:0] id_str_undef,
    input  logic [15:0] id_stroke,
    input  logic [15:0] id_strokestyle,
    input  logic [15:0] id_textalign,
    input  logic [15:0] id_textbaseline, // #37
    input  logic [15:0] id_top,
    input  logic [15:0] id_middle,
    input  logic [15:0] id_bottom,
    output logic [1:0] ctx_baseline_q,
    input  logic [15:0] id_translate,
    input  logic [15:0] id_unshift,
    input  logic [15:0] id_white,
    input  logic [15:0] id_width,
    input  logic [15:0] p_ip,
    input  logic [5:0] joy_in,
    input  logic [7:0] analog_x,
    input  logic [7:0] analog_y,
    input  logic [4:0] joy_btn,
    output logic cm_req_q,
    output logic [15:0] cm_key_q,
    output logic [15:0] cm_cls_q,
    input  logic cm_res_we,
    input  logic [15:0] cm_res_mip,
    output logic lsv_req_q,
    output logic [1:0] lsv_op_q,
    output logic [63:0] lsv_ev_q,
    output logic [63:0] lsv_fn_q,
    input  logic lsv_res_we,
    input  logic [2:0] lsv_res,
    input  logic [4:0] lsv_res_n, // new listener count (mask-apply cannot land while held)
    input  logic [15:0] n_consts,
    input  logic [15:0] n_ops,
    input  logic [4:0] n_spr,
    input  logic [15:0] name_blen_rdata,
    input  logic [15:0] name_hash_rdata,
    // Parent-owned JS heap: rdata next clock. Do not combo-index mem[i].
    input  logic [15:0] name_off_rdata,
    input  logic [63:0] vvars_rdata,
    input  logic vvar_valid_rdata,
    input  logic [4:0] venv_len_rdata,
    // Build 99: current env's hinted slot {key[73:64], value}, read on
    // exec's fetch beat for a local LOAD_VAR (parent venv_raddr).
    input  logic [73:0] venv_slot_rdata,
    input  logic [11:0] venv_gen_rdata,
    input  logic venv_valid_rdata,
    input  logic [7:0] varr_len_rdata,
    input  logic varr_valid_rdata,
    input  logic [11:0] varr_gen_rdata,
    input  logic varr_long_rdata,
    input  logic [1:0] vobj_alloc_rdata,
    input  logic [11:0] vobj_gen_rdata,
    input  logic [63:0] vobj_proto_rdata,
    input  logic [15:0] vobj_cls_rdata,
    input  logic [5:0] vobj_len_rdata,
    input  logic [3:0] vobj_builtin_rdata,
    input  logic vfn_valid_rdata,
    input  logic [11:0] vfn_gen_rdata,
    input  logic [63:0] vfn_proto_rdata,
    input  logic [63:0] vfn_env_rdata,
    input  logic [5:0] vfn_nparam_rdata,
    input  logic [15:0] vfn_entry_rdata,
    input  logic [2:0] vfn_flags_rdata,
    input  logic [63:0] vconsts_rdata,
    input  logic [15:0] vframe_rip_rdata,
    input  logic [11:0] vframe_bsp_rdata,
    input  logic vframe_esc_rdata,
    input  logic [63:0] vframe_this_rdata,
    input  logic [63:0] vframe_env_rdata,
    input  logic [63:0] vframe_fn_rdata,
    input  logic [63:0] vframe_ctor_rdata,
    input  logic vframe_setter_rdata,
    input  logic [7:0] fill_lut_rdata,
    input  logic vtimer_valid_rdata,
    input  logic signed [31:0] vtimer_id_rdata,
    input logic names_ready,
    input  logic [15:0] names_n,
    input  logic [15:0] ops_base,
    input  logic [255:0] spr_hh_pack,
    input  logic [255:0] spr_nid_pack,
    input  logic [255:0] spr_ww_pack,
    input  logic [6:0] p_state,
    input  logic this_ok,
    input  logic [7:0] p_valloc_arr_n,
    input  logic p_valloc_bind,
    input  logic [12:0] p_valloc_bind_src,
    input  logic [63:0] p_valloc_bind_this,
    input  logic [7:0] p_valloc_fn_a1,
    input  logic [15:0] p_valloc_fn_entry,
    input  logic [13:0] p_valloc_i,
    input  logic [1:0] p_valloc_kind,
    input  logic p_valloc_metrics,
    input  logic p_valloc_now_fn,
    input  logic p_valloc_proto,
    input  logic [12:0] p_valloc_proto_fn,
    input  logic p_valloc_regex,
    input  logic [31:0] p_valloc_regex_pack,
    input  logic p_valloc_retried,
    input  logic [9:0] var_this,
    input  logic [11:0] p_vcall_argc,
    input  logic [63:0] p_vcall_ctor_val,
    input  logic [15:0] p_vcall_entry,
    input  logic p_vcall_set_this,
    input  logic [63:0] p_vcall_this,
    input  logic p_vcall_value,
    input  logic [7:0] p_vcsp,
    input  logic [7:0] p_vdraw_color,
    input  logic [9:0] p_vdraw_h,
    input  logic [18:0] p_vdraw_i,
    input  logic [9:0] p_vdraw_w,
    input  logic [9:0] p_vdraw_x,
    input  logic [9:0] p_vdraw_y,
    input  logic [63:0] p_venv,
    input  logic [7:0] p_vfe_i,
    input  logic [13:0] vfn_next,
    input  logic [31:0] vframe_no,
    input  logic vfree_ok,
    input  logic [13:0] p_vgc_clear_i,
    input  logic p_vgc_halt_after,
    input  logic [13:0] p_vgc_qr,
    input  logic [13:0] p_vgc_qw,
    input  logic p_vgc_wait_after,
    input  logic [4:0] p_vlistener_n,
    input  logic [63:0] vmetrics,
    input  logic [3:0] text_font_scale,
    input  logic [11:0] p_vnat_base,
    input  logic [2:0] p_vnat_dom,
    input  logic [13:0] vobj_next,
    input  logic p_vprom_done,
    input  logic [3:0] p_vraf_n,
    input  logic [11:0] p_vsp,
    input  logic [1023:0] vst_win_pack,
    input  logic [63:0] p_vthis,
    input  logic [6:0] p_vtimer_n,
    input  logic [31:0] p_vtimer_seq,
    output logic json_mem_we_q,
    output logic [12:0] json_mem_waddr_q,
    output logic [7:0] json_mem_wdata_q,
    // Parent-owned name SRAM: local raddr, registered *_q (never combo raddr ports).
    output logic [9:0] vvars_raddr_q,
    output logic [11:0] varr_raddr_q,
    output logic [12:0] vobj_raddr_q,
    output logic [12:0] vfn_raddr_q,
    output logic [9:0] name_off_raddr_q,
    output logic [9:0] fill_lut_raddr_q,
    output logic [6:0] vframe_raddr_q,
    output logic [5:0] vtimer_raddr_q,
    output logic [9:0] vconsts_raddr_q,
    output logic [9:0] name_blen_raddr_q,
    output logic name_blen_we_q,
    output logic [9:0] name_blen_waddr_q,
    output logic [15:0] name_blen_wdata_q,
    output logic [9:0] name_hash_raddr_q,
    output logic name_hash_we_q,
    output logic [9:0] name_hash_waddr_q,
    output logic [15:0] name_hash_wdata_q,
    output logic name_has_we_q,
    output logic [9:0] name_has_waddr_q,
    output logic name_has_wdata_q,
    output logic varr_len_we_q,
    output logic [11:0] varr_len_waddr_q,
    output logic [7:0] varr_len_wdata_q,
    output logic varr_lidx_we_q,
    output logic [11:0] varr_lidx_waddr_q,
    output logic [7:0] varr_lidx_wdata_q,
    output logic varr_long_we_q,
    output logic [11:0] varr_long_waddr_q,
    output logic [31:0] varr_long_wdata_q,
    output logic varr_valid_we_q,
    output logic [11:0] varr_valid_waddr_q,
    output logic [31:0] varr_valid_wdata_q,
    output logic venv_gen_we_q,
    output logic [11:0] venv_gen_waddr_q,
    output logic [11:0] venv_gen_wdata_q,
    output logic venv_len_we_q,
    output logic [11:0] venv_len_waddr_q,
    output logic [4:0] venv_len_wdata_q,
    output logic venv_valid_we_q,
    output logic [11:0] venv_valid_waddr_q,
    output logic [31:0] venv_valid_wdata_q,
    output logic vobj_cls_we_q,
    output logic [11:0] vobj_cls_waddr_q,
    output logic [15:0] vobj_cls_wdata_q,
    output logic vvar_valid_we_q,
    output logic [11:0] vvar_valid_waddr_q,
    output logic [31:0] vvar_valid_wdata_q,
    output logic vvars_we_q,
    // Build 99: a local STORE_VAR/LET_VAR that hit its hinted env slot
    // writes the slot from exec (parent applies it on the leave beat).
    output logic venvs_we_q,
    output logic [12:0] venvs_waddr_q,
    output logic [79:0] venvs_wdata_q,
    // sound(ch,freq,vol,frames,slide) nid 42 — registered poke to the PSG
    // snd_tgl flips only when the previous packet has been acknowledged;
    // all payload fields stay stable through destination capture.
    input  logic        snd_ack, // destination captured the held sound packet
    output logic        snd_tgl,
    output logic [1:0]  snd_ch,
    output logic [15:0] snd_freq,
    output logic [3:0]  snd_vol,
    output logic [7:0]  snd_frames,
    output logic [7:0]  snd_slide,
    output logic [11:0] vvars_waddr_q,
    output logic [63:0] vvars_wdata_q,
    output logic vframe_we_q,
    output logic [6:0] vframe_waddr_q,
    output logic [15:0] vframe_rip_wdata_q,
    output logic [11:0] vframe_bsp_wdata_q,
    output logic vframe_esc_wdata_q,
    output logic [63:0] vframe_this_wdata_q,
    output logic [63:0] vframe_env_wdata_q,
    output logic [63:0] vframe_fn_wdata_q,
    output logic [63:0] vframe_ctor_wdata_q,
    // Scalar we into parent 1-D banks (no unpacked *_n mux).
    output logic vraf_we_q,
    output logic [2:0] vraf_waddr_q,
    output logic [63:0] vraf_wdata_q,
    output logic vtimer_we_q,
    output logic [5:0] vtimer_waddr_q,
    output logic vtimer_valid_wdata_q,
    output logic signed [31:0] vtimer_due_wdata_q,
    output logic [63:0] vtimer_fn_wdata_q,
    output logic signed [31:0] vtimer_id_wdata_q,
    output logic signed [63:0] vtimer_period_wdata_q,
    // Compact-remove rewrites all 16 FF slots via *_n. Add uses scalar we.
    output logic vst_win0_we_q,
    output logic [63:0] vst_win0_wdata_q,
    input  logic p_clr,
    input  logic p_we,
    input  logic [5:0] p_sel,
    input  logic p_frame_we,
    input  logic [6:0] p_frame_idx,
    input  logic [63:0] p_frame_ctor
);

    /* opw_q: EXEC and every non-fetch state read the op
       word from a register captured during S_FETCH_WAIT, not the live code
       BRAM output. Bit-identical today (nothing refetches mid-op); it
       frees the code port so piece 1 can prefetch op N+1 during EXEC
       without the immediates under op N shifting. */
    logic [31:0] opw_q /*verilator public_flat_rd*/;
    logic        opw_cap_n; // piece 1: central-skip capture pulse (comb)
    logic [31:0] dbg_pf_n /*verilator public_flat_rd*/; // skips taken
    logic [15:0] dbg_pf_last_ip /*verilator public_flat_rd*/; // ip of last skip (the op skipped INTO)
`ifdef JMR_PF_SKIP
    logic        dbg_pfa_c, dbg_pfb_c, dbg_pfc_c; // cascade probes (comb)
    logic [15:0] pf_addr_s; // probe copy
    logic [31:0] dbg_pfa /*verilator public_flat_rd*/;
    logic [31:0] dbg_pfb /*verilator public_flat_rd*/;
    logic [31:0] dbg_pfc /*verilator public_flat_rd*/;
    logic [15:0] dbg_pf_addr /*verilator public_flat_rd*/;
    logic [15:0] dbg_pf_want /*verilator public_flat_rd*/;
    logic [15:0] dbg_pf_mask /*verilator public_flat_rd*/;
`endif
    logic        pf_ok; // port-streams-ip+1 provenance (see mirror + skip)
    logic        post_parent_q; // one-shot: first op after a PARENT-flow
                                // return must take the real fetch-wait (its
                                // beat carries ctor/heap return bookkeeping
                                // — pflip=10 forensics: the skip right after
                                // NEW_OBJ's return underflowed the stack 2
                                // ops later).
    // Hold one coherent command until the audio clock acknowledges capture.
    // Native42 waits only when the preceding command is still outstanding.
    (* ASYNC_REG = "TRUE" *) logic [1:0] snd_ack_sync;
    always_ff @(posedge clk)
        if (!rst_n) snd_ack_sync <= 2'b00;
        else snd_ack_sync <= {snd_ack_sync[0], snd_ack};
    always_ff @(posedge clk) begin
        if (!rst_n) begin
            snd_tgl <= 1'b0; snd_ch <= '0; snd_freq <= '0;
            snd_vol <= '0; snd_frames <= '0; snd_slide <= '0;
        end else if (enable && snd_stb_c) begin
            snd_tgl    <= ~snd_tgl;
            snd_ch     <= snd_ch_c;
            snd_freq   <= snd_freq_c;
            snd_vol    <= snd_vol_c;
            snd_frames <= snd_frames_c;
            snd_slide  <= snd_slide_c;
        end
    end
    always_ff @(posedge clk) begin
        if (enable && opw_cap_n) begin
            dbg_pf_n <= dbg_pf_n + 32'd1;
            dbg_pf_last_ip <= ip_n;
        end
`ifdef JMR_PF_SKIP
        if (enable && dbg_pfa_c) dbg_pfa <= dbg_pfa + 32'd1;
        if (enable && dbg_pfb_c) dbg_pfb <= dbg_pfb + 32'd1;
        if (enable && dbg_pfb_c && dbg_pf_want == 16'd0) begin
            dbg_pf_addr <= pf_addr_s;
            dbg_pf_want <= 16'(ops_base + ip_n);
            dbg_pf_mask <= {15'd0, hs_m_code};
        end
        if (enable && dbg_pfc_c) dbg_pfc <= dbg_pfc + 32'd1;
`endif
    end
    always_ff @(posedge clk)
        // BEAT-gated (caught by the PF checker on first run: ungated, the
        // capture fired on every CORE clk and overwrote the current op's
        // word mid-beat). All beat registers gate on enable; so does this.
        // fetch-wait: ungated (code_rdata stable all beat; exec64's enable
        // is not asserted under parent-owned states — gating it starved the
        // FIRST op's capture entirely). Skip-capture: beat-edge only.
        if ((state == S_FETCH_WAIT) || (enable && opw_cap_n))
            opw_q <= code_rdata;
    wire [31:0] opw_raw = (state == S_FETCH_WAIT) ? code_rdata : opw_q;
    // JSB2 prepared method retains its original name and argument width.
    wire [31:0] opw = (opw_raw[7:0] == OP_CALL_METH) ?
        (opw_raw & 32'hff7fffff) : opw_raw;
    logic callref_done;
    always_ff @(posedge clk) begin
        if (!rst_n || p_clr || state == S_FETCH_WAIT || (enable && opw_cap_n) || opw_raw[7:0]!=OP_CALL_METH || !opw_raw[23]) callref_done <= 0;
        else if (enable && state_n == S_V64_CALLREF) callref_done <= 1;
    end
    assign opw_out = opw;
    // piece 1 fast-path class: the prefetched op's operand pre-latch needs
    // only code bits (or nothing) — no vsp-relative addressing, no heap or
    // parent flow at ENTRY. Everything else falls through to the real
    // S_FETCH_WAIT via the central override's address equality.
    // Ops whose execute arm reads only vst_s (the stack window), the op word
    // and exec registers - no parent memory rdata - so they need no settle
    // beat between beat 1 and execute (OP_ADD's string path enters S_CONCAT,
    // which reads its own memories in later beats).
    function automatic logic beat2_free(input logic [7:0] op);
        beat2_free = (op == OP_ADD) || (op == OP_SUB) || (op == OP_MUL) ||
                     (op == OP_DIV) || (op == OP_MOD) ||
                     (op == OP_LT)  || (op == OP_GT)  || (op == OP_EQ)  ||
                     (op == OP_NEG) || (op == OP_NOT) ||
                     (op == OP_BIT_OR) || (op == OP_BIT_AND) ||
                     (op == OP_POP) || (op == OP_DUP) ||
                     (op == OP_JUMP) || (op == OP_JIF);
    endfunction
    function automatic logic pf_safe(input logic [7:0] op);
        pf_safe = (op == OP_LOAD_CONST) || (op == OP_LOAD_VAR) ||
                  (op == OP_STORE_VAR)  || (op == OP_LET_VAR)  ||
                  (op == OP_ADD) || (op == OP_SUB) || (op == OP_MUL) ||
                  (op == OP_DIV) || (op == OP_LT)  || (op == OP_GT)  ||
                  (op == OP_EQ)  || (op == OP_MOD) || (op == OP_NEG) ||
                  (op == OP_NOT) || (op == OP_BIT_OR) || (op == OP_BIT_AND) ||
                  (op == OP_POP) || (op == OP_DUP) ||
                  (op == OP_JUMP) || (op == OP_JIF);
    endfunction



    // Combo D-pins are local. Parent sees *_q only (never-fake-fpga-sim).
    // SRAM we/waddr/wdata are local; parent sees *_q (opcode comb assigns no ports).
    // Dedicated raddr comb writes these locals; always_ff *_q to parent.
    logic [9:0] vvars_raddr;
    logic [11:0] varr_raddr;
    logic [12:0] vobj_raddr;
    logic [12:0] vfn_raddr;
    logic [9:0] name_off_raddr;
    logic [9:0] fill_lut_raddr;
    logic [6:0] vframe_raddr;
    logic [5:0] vtimer_raddr;
    logic [9:0] vconsts_raddr;
    logic [9:0] name_blen_raddr;
    logic [9:0] name_hash_raddr;
    logic json_mem_we;
    logic [12:0] json_mem_waddr;
    logic [7:0] json_mem_wdata;
    logic name_blen_we;
    logic [9:0] name_blen_waddr;
    logic [15:0] name_blen_wdata;
    logic name_hash_we;
    logic [9:0] name_hash_waddr;
    logic [15:0] name_hash_wdata;
    logic name_has_we;
    logic [9:0] name_has_waddr;
    logic name_has_wdata;
    logic varr_len_we;
    logic [11:0] varr_len_waddr;
    logic [7:0] varr_len_wdata;
    logic varr_lidx_we;
    logic [11:0] varr_lidx_waddr;
    logic [7:0] varr_lidx_wdata;
    logic varr_long_we;
    logic [11:0] varr_long_waddr;
    logic [31:0] varr_long_wdata;
    logic varr_valid_we;
    logic [11:0] varr_valid_waddr;
    logic [31:0] varr_valid_wdata;
    logic venv_gen_we;
    logic [11:0] venv_gen_waddr;
    logic [11:0] venv_gen_wdata;
    logic venv_len_we;
    logic [11:0] venv_len_waddr;
    logic [4:0] venv_len_wdata;
    logic venv_valid_we;
    logic [11:0] venv_valid_waddr;
    logic [31:0] venv_valid_wdata;
    logic vobj_cls_we;
    logic [11:0] vobj_cls_waddr;
    logic [15:0] vobj_cls_wdata;
    logic vvar_valid_we;
    logic [11:0] vvar_valid_waddr;
    logic [31:0] vvar_valid_wdata;
    logic vvars_we;
    logic venvs_we;
    logic [12:0] venvs_waddr;
    logic [79:0] venvs_wdata;
    logic snd_stb_c; // comb: nid-42 executes this beat (registered below)
    logic [1:0]  snd_ch_c;
    logic [15:0] snd_freq_c;
    logic [3:0]  snd_vol_c;
    logic [7:0]  snd_frames_c;
    logic [7:0]  snd_slide_c;
    logic [11:0] vvars_waddr;
    logic [63:0] vvars_wdata;
    logic vframe_we;
    logic [6:0] vframe_waddr;
    logic [15:0] vframe_rip_wdata;
    logic [11:0] vframe_bsp_wdata;
    logic vframe_esc_wdata;
    logic [63:0] vframe_this_wdata;
    logic [63:0] vframe_env_wdata;
    logic [63:0] vframe_fn_wdata;
    logic [63:0] vframe_ctor_wdata;
    logic vraf_we;
    logic [2:0] vraf_waddr;
    logic [63:0] vraf_wdata;
    logic vtimer_we;
    logic [5:0] vtimer_waddr;
    logic vtimer_valid_wdata;
    logic signed [31:0] vtimer_due_wdata;
    logic [63:0] vtimer_fn_wdata;
    logic signed [31:0] vtimer_id_wdata;
    logic signed [63:0] vtimer_period_wdata;
    logic vst_win0_we;
    logic [63:0] vst_win0_wdata;
    logic cm_win_n;
    logic aset_win_retried_n;
    logic [7:0] bind_argc_n;
    logic [11:0] bind_base_n;
    logic [15:0] bind_ip_n;
    logic [7:0] bind_k_n;
    logic [1:0] bind_mode_n;
    logic [7:0] bind_n_n;
    logic bind_rd_arm_n;
    logic [6:0] bind_ret_n;
    logic [11:0] bind_src_n;
    logic [11:0] bind_vsp_next_n;
    logic [15:0] blit_sh_n;
    logic [7:0] blit_si_n;
    logic flip_x_n;
    logic flip_y_n;
    logic [15:0] blit_sw_n;
    logic [15:0] blit_sx_n;
    logic [15:0] blit_sy_n;
    logic [2:0] cc_at_n;
    logic signed [31:0] cc_av_n;
    logic cc_bok_n;
    logic [2:0] cc_bt_n;
    logic signed [31:0] cc_bv_n;
    logic [3:0] cc_d_n;
    logic [15:0] cc_h_n;
    logic [7:0] cc_len_n;
    logic cc_second_n;
    logic [1:0] cc_st_n;
    logic [15:0] code_raddr_n;
    logic [7:0] color_n;
    logic [1:0] ctx_align_n;
    logic ctx_smooth_n;
    logic signed [31:0] ctx_sx_n;
    logic signed [31:0] ctx_sy_n;
    logic signed [31:0] ctx_tx_n;
    logic signed [31:0] ctx_ty_n;
    logic [15:0] dbg_di_hit_n;
    logic [15:0] dbg_di_miss_n;
    logic [15:0] dbg_div_n_n;
    logic [15:0] dbg_json_ovf_n;
    logic [15:0] dbg_path_ovf_n;
    logic [7:0] fault_code_n;
    logic [18:0] fb_dump_addr_n;
    logic fb_dump_sel_n;
    logic fb_swap_n;
    logic [7:0] fill_style_i_n;
    logic [7:0] stroke_style_i_n;
    logic [11:0] hp_aid_n;
    logic [7:0] hp_alen_n;
    logic [6:0] hp_aslot_n;
    logic [3:0] hp_cmd_n;
    logic [9:0] hp_eid_n;
    logic hp_env_n;
    logic hp_from_stack_n;
    logic hp_hit_n;
    logic [15:0] hp_key_n;
    logic [5:0] hp_len_n;
    logic [7:0] hp_lim_n;
    logic hp_make_arr_n;
    logic [3:0] hp_nat_n;
    logic [12:0] hp_oid_n;
    logic [2:0] hp_phase_n;
    logic [63:0] hp_proto_n;
    logic [2:0] hp_qi_n;
    logic [2:0] hp_qn_n;
    logic [6:0] hp_ret_n;
    logic [63:0] hp_rval_n;
    logic [12:0] hp_si_n;
    logic [4:0] hp_slot_n;
    logic [15:0] hp_spr_h_n;
    logic [15:0] hp_spr_w_n;
    logic [4:0] hp_ss_n;
    logic [5:0] hp_tn_n;
    logic [11:0] hp_vbase_n;
    logic [63:0] hp_wval_n;
    logic imgd_armed_n;
    logic [9:0] imgd_h_n;
    logic [18:0] imgd_i_n;
    logic [18:0] imgd_n_n;
    logic imgd_v64_n;
    logic [9:0] imgd_w_n;
    logic [9:0] imgd_x_n;
    logic [9:0] imgd_x0_n;
    logic [9:0] imgd_y_n;
    logic [9:0] imgd_y0_n;
    logic [15:0] ip_n;
    logic [11:0] jn_arr_n;
    logic [15:0] jn_h_n;
    logic [15:0] jn_i_n;
    logic [10:0] jn_res_n;
    logic [5:0] js_sp_n;
    logic [2:0] json_pph_n;
    logic [13:0] json_rp_n;
    logic [13:0] json_src_n;
    logic [13:0] json_srclen_n;
    logic [13:0] json_wp_n;
    logic looping_n;
    logic machine_fault_n;
    logic [63:0] minmax_acc_n;
    logic        cmp_done_n;
    logic [7:0]  cmp_status_n;
    logic [20:0] cmp_len_n;
    logic [6:0]  cmp_msglen_n;
    logic [2:0]  csr_mode_n;
    logic [21:0] csr_addr_n;
    logic [15:0] csr_wdata_n;
    logic [17:0] src_setlen_n;
    logic src_setlen_stb_n;
    logic        csr_oob_n;
    logic [11:0] minmax_base_n;
    logic minmax_is_min_n;
    logic [7:0] minmax_k_n;
    logic [7:0] minmax_n_n;
    logic namcpy_armed_n;
    logic namcpy_repl_n;
    logic namcpy_v64_n;
    logic [15:0] name_rdaddr_n;
    logic path_active_n;
    logic [1:0] path_kind_n;
    logic path_stroke_n;
    logic [4:0] pc_n_n;
    logic [4:0] pi_n;
    logic repl_did_n;
    logic repl_g_n;
    logic [7:0] repl_nlen_n;
    logic [7:0] repl_pat0_n;
    logic [7:0] repl_pat1_n;
    logic [7:0] repl_rch_n;
    logic [9:0] rh_n;
    logic running_n;
    logic [9:0] rw_n;
    logic signed [11:0] rx_n;
    logic signed [11:0] ry_n;
    logic signed [31:0] saved_sx_n;
    logic signed [31:0] saved_sy_n;
    logic signed [31:0] saved_tx_n;
    logic signed [31:0] saved_ty_n;
    logic [4:0] sq_i_n;
    logic [63:0] sq_rad_n;
    logic [25:0] sq_rem_n;
    logic [23:0] sq_root_n;
    logic [6:0] state_n;
    logic [6:0] txt_bn_n;
    logic [3:0] txt_ph_n;
    logic signed [15:0] txt_px_n;
    logic signed [15:0] txt_py_n;
    logic [31:0] txt_val_n;
    logic [2:0] txt_vt_n;
    logic v64_concat_n;
    logic v64_join_n;
    logic v64_sqrt_n;
    logic [7:0] valloc_arr_n_n;
    logic valloc_bind_n;
    logic [12:0] valloc_bind_src_n;
    logic [63:0] valloc_bind_this_n;
    logic [7:0] valloc_fn_a1_n;
    logic [15:0] valloc_fn_entry_n;
    logic [13:0] valloc_i_n;
    logic [1:0] valloc_kind_n;
    logic valloc_metrics_n;
    logic valloc_now_fn_n;
    logic valloc_proto_n;
    logic [12:0] valloc_proto_fn_n;
    logic valloc_regex_n;
    logic [31:0] valloc_regex_pack_n;
    logic valloc_retried_n;
    logic [13:0] varr_next_n;
    logic [11:0] vcall_argc_n;
    logic [63:0] vcall_ctor_val_n;
    // ALLOC p_frame_we plants the instance here (SRAM rdata lags RET combo).
    logic [63:0] ctor_cur_n;
    logic [7:0] ctor_csp_n;
    logic [15:0] vcall_entry_n;
    logic vcall_set_this_n;
    logic [63:0] vcall_this_n;
    logic vcall_value_n;
    logic [8:0] vconsole_n_n;
    logic [7:0] vcsp_n;
    logic [7:0] vdiv_count_n;
    logic [52:0] vdiv_den_n;
    logic signed [12:0] vdiv_exp_n;
    logic [106:0] vdiv_num_n;
    logic [106:0] vdiv_quot_n;
    logic [53:0] vdiv_rem_n;
    logic vdiv_sign_n;
    logic [7:0] vdraw_color_n;
    logic [9:0] vdraw_h_n;
    logic [18:0] vdraw_i_n;
    logic [9:0] vdraw_w_n;
    logic [9:0] vdraw_x_n;
    logic [9:0] vdraw_y_n;
    logic [63:0] venv_n;
    logic [9:0] venv_next_n;
    logic [63:0] vfe_arr_n;
    logic [11:0] vfe_base_n;
    logic [63:0] vfe_fn_n;
    logic [7:0] vfe_i_n;
    logic [7:0] vfe_len_n;
    logic [63:0] vfe_map_n;
    logic [1:0] vfe_mode_n;
    logic [15:0] vfe_ret_n;
    logic [3:0] vfe_sp_n;
    logic vfree_armed_n;
    logic vfree_arr_long_n;
    logic [13:0] vgc_clear_i_n;
    logic vgc_halt_after_n;
    logic [13:0] vgc_qr_n;
    logic [13:0] vgc_qw_n;
    logic [1:0] vgc_resume_n;
    logic vgc_wait_after_n;
    logic vjs_rd_arm_n;
    logic [4:0] vlistener_n_n;
    logic [31:0] vmetrics_w_n;
    logic [11:0] vmod_count_n;
    logic [52:0] vmod_den_n;
    logic signed [12:0] vmod_exp_n;
    logic [52:0] vmod_rem_n;
    logic vmod_sign_n;
    logic [11:0] vnat_base_n;
    logic [2:0] vnat_dom_n;
    logic vprom_copy_n;
    logic vprom_done_n;
    logic [6:0] vprom_ret_n;
    logic [3:0] vraf_n_n;
    logic [31:0] vrng_n;
    logic [11:0] vsp_n;
    logic vst_hold_win_n;
    logic vst_refill_arm_n;
    logic [3:0] vst_refill_i_n;
    logic [6:0] vst_refill_ret_n;
    logic vst_we_n;
    logic [63:0] vthis_n;
    logic [6:0] vtimer_n_n;
    logic [31:0] vtimer_seq_n;
    logic [9:0] x_n;
    logic [9:0] y_n;

    // The class tables left this exec. Method lookup is a
    // request to the parent's sequential scanner: cm_scan/cm_key/cm_cls
    // are exported as a level request; the parent walks its own tables
    // and answers on cm_res_we/cm_res_mip (comb inputs — a poke would be
    // overwritten by the *_n register updates in the same beat).
    // json_mem lives in parent (we_q). Combo next-state stays inside exec.
    logic hp_q_we;
    logic [1:0] hp_q_waddr;
    logic [15:0] hp_qk_wdata;
    logic [2:0] hp_qt_wdata;
    logic [63:0] hp_qv_wdata;
    logic js_we;
    logic [4:0] js_waddr;
    logic [7:0] js_i_wdata;
    logic [2:0] js_ph_wdata;
    logic [63:0] vjs_val_wdata;
    logic pc_we;
    logic [3:0] pc_waddr;
    // #49 mirror taps (combinational, same values the local arrays take).
    assign js_we_q        = js_we;
    assign js_waddr_q     = js_waddr;
    assign js_i_wdata_q   = js_i_wdata;
    assign js_ph_wdata_q  = js_ph_wdata;
    assign vjs_val_wdata_q = vjs_val_wdata;
    assign pc_we_q        = pc_we;
    assign pc_waddr_q     = pc_waddr;
    assign pc_op_wdata_q  = pc_op_wdata;
    assign pc_a1_wdata_q  = pc_a1_wdata;
    assign pc_a2_wdata_q  = pc_a2_wdata;
    assign pc_a3_wdata_q  = pc_a3_wdata;
    assign pc_a4_wdata_q  = pc_a4_wdata;
    assign pc_a5_wdata_q  = pc_a5_wdata;
    assign pc_ccw_wdata_q = pc_ccw_wdata;
    logic signed [31:0] pc_a1_wdata, pc_a2_wdata, pc_a3_wdata, pc_a4_wdata, pc_a5_wdata;
    logic pc_ccw_wdata;
    logic [1:0] pc_op_wdata;
    logic vfe_s_we;
    logic [2:0] vfe_s_waddr;
    logic [63:0] vfe_arr_s_wdata, vfe_fn_s_wdata, vfe_map_s_wdata;
    logic [11:0] vfe_base_s_wdata;
    logic [7:0] vfe_i_s_wdata;
    logic [7:0] vfe_len_s_wdata;
    logic [1:0] vfe_mode_s_wdata;
    logic [15:0] vfe_ret_s_wdata;
    // Parent SRAM raddr/rdata are module ports. Operand arm (opnd_q) waits
    // the registered rdata beat. Do not declare a second copy here.
    // leftover 3 clocks raddr_q on EXEC; parent rdata is the next clock after
    // that. One opnd beat presented the new raddr but LOAD_CONST still saw
    // the previous const (fillRect 8x8 → 10x8, n=f() not 7). Second beat
    // lets rdata settle. Extra clocks are silicon (never-fake-fpga-sim).
    logic opnd_q /*verilator public_flat_rd*/, opnd_n;
    logic opnd2_q /*verilator public_flat_rd*/, opnd2_n;
    // ALLOC (getElementById / FRAME_RAF env) freezes raddr_q. Parent
    // vfn_valid_rdata is the clock after raddr_q, and exec samples that
    // rdata one more clock after that (rAF fault 4 / 45 with vf0=1).
    logic opnd3_q /*verilator public_flat_rd*/, opnd3_n;
    // Build 99: this execute beat follows a beat 1 that was exec's own
    // fetch beat of a local LOAD_VAR, so venv_slot_rdata is its hinted slot.
    logic lvfast_q, lvfast_n;
    // Class method lookup: one (c,m) per clock. Opcode comb must not
    // index cls_mip[][] (exec32 cm_scan twin).
    logic cm_scan /*verilator public_flat_rd*/, cm_scan_n, cm_armed, cm_armed_n, cm_done, cm_done_n;
    assign cm_req_q = cm_scan;
    assign cm_key_q = cm_key;
    assign cm_cls_q = cm_cls;
    // Listener ops (add/remove) are served by the PARENT's sequential
    // walk over its single table — the four exec-side table copies and
    // their one-beat 16-way scans are gone (census: ~26.9k LUTs).
    logic lsv_scan /*verilator public_flat_rd*/, lsv_scan_n;
    logic [1:0] lsv_op, lsv_op_n;
    logic [63:0] lsv_ev, lsv_ev_n, lsv_fn, lsv_fn_n, lsv_push, lsv_push_n;
    logic [11:0] lsv_base, lsv_base_n;
    assign lsv_req_q = lsv_scan;
    assign lsv_op_q = lsv_op;
    assign lsv_ev_q = lsv_ev;
    assign lsv_fn_q = lsv_fn;
    // Exact shift/add Number multiply. Fixed 32/16/4-bit zero skips preserve
    // acc + mcand*mplier while consuming sparse mantissas in fewer beats.
    // Fixed wiring avoids variable 106-bit and 53-bit barrel shifters. The
    // complete 106-bit product and existing rounding remain unchanged.
    // Date.now (nwm_*) retains its independent, background 53-beat engine.
    logic         fpm_busy, fpm_req, fpm_req_n;
    logic [5:0]   fpm_cnt;
    logic [105:0] fpm_acc, fpm_mcand;
    logic [52:0]  fpm_mplier;
    wire [1:0] fpm_zstep = (fpm_mplier[31:0] == 32'd0) ? 2'd3 :
                           (fpm_mplier[15:0] == 16'd0) ? 2'd2 :
                           (fpm_mplier[3:0] == 4'd0) ? 2'd1 : 2'd0;
    logic         fpm_sign, fpm_sign_n;
    logic [10:0]  fpm_ea, fpm_eb, fpm_ea_n, fpm_eb_n;
    logic         fpm_start_n;
    logic fadd_req, fadd_req_n, fadd_start_n, fadd_busy;
    logic [63:0] fadd_a_n, fadd_b_n, fadd_a, fadd_b, fadd_result;
    logic [2:0] fadd_phase;
    logic [55:0] fadd_xa, fadd_xb, fadd_sig;
    logic [11:0] fadd_er;
    logic fadd_same_sign, fadd_sign, fadd_special;
    logic [63:0] fadd_special_value;
    // Native arguments are pipeline operands, not a second VM stack. The
    // original stack remains authoritative for calls, returns and GC.
    logic [63:0] call_arg_q [0:9];
    logic arg_spill_busy;
    logic arg_native_uses_capture;
    always_comb begin
        arg_native_uses_capture = 1'b1;
        // These services consume no captured argument (min/max already
        // walk the stack). Preserve their existing wide-call cycles too.
        case(opw_q[15:8])
          8'd0,8'd3,8'd4,8'd5,8'd6,8'd7,8'd8,8'd9,
          8'd12,8'd13,8'd14,8'd21,8'd22,8'd25,8'd26,
          8'd32,8'd33,8'd35,8'd43,8'd51,8'd52,8'd53,8'd70:
            arg_native_uses_capture = 1'b0;
          default: ;
        endcase
    end
    logic [3:0] arg_spill_k;
    logic [1:0] arg_spill_phase;
    assign arg_stack_read = arg_spill_busy && enable && !leave_hold;
    assign arg_stack_addr = vsp_hs - {4'd0,opw_q[31:24]}
        - (opw_q[7:0] == OP_CALL_METH ? 12'd1 : 12'd0)
        + {8'd0,arg_spill_k};
    assign fs_arg_value=call_arg_q[fs_arg_index];
    always_ff @(posedge clk) begin
        if (!rst_n || p_clr || !enable || leave_hold) begin
            arg_spill_busy <= 1'b0; arg_spill_k <= 4'd0; arg_spill_phase <= 2'd0;
        end else if (arg_spill_busy) begin
            if (arg_spill_phase != 2'd2) arg_spill_phase <= arg_spill_phase + 2'd1;
            else begin
                logic signed [12:0] rel;
                rel = $signed({5'd0,opw_q[31:24]}) - 13'(arg_spill_k)
                    - (opw_q[7:0] == OP_CALL ? 13'd1 : 13'd0);
                call_arg_q[arg_spill_k] <= rel >= 0 && rel < 16
                    ? vst_s[rel[3:0]] : arg_stack_data;
                arg_spill_phase <= 2'd0;
                if (arg_spill_k == 4'd9) arg_spill_busy <= 1'b0;
                else arg_spill_k <= arg_spill_k + 4'd1;
            end
        end else if (opnd_q && !opnd2_q &&
            (opw_q[7:0] == OP_CALL || opw_q[7:0] == OP_CALL_METH)) begin
            arg_spill_busy <= (opw_q[7:0] == OP_CALL_METH || arg_native_uses_capture) &&
                opw_q[31:24] > (opw_q[7:0] == OP_CALL ? 8'd16 : 8'd15);
            arg_spill_k <= 4'd0; arg_spill_phase <= 2'd0;
            for (int k = 0; k < 10; k++) begin : capture_call_arg
                logic signed [12:0] rel;
                rel = $signed({5'd0, opw_q[31:24]}) - 13'(k)
                    - ((opw_q[7:0] == OP_CALL) ? 13'd1 : 13'd0);
                call_arg_q[k] <= (rel >= 0 && rel < 16)
                    ? vst_s[rel[3:0]] : vst_s[0];
            end
        end
    end

    always_ff @(posedge clk) begin
        if (!rst_n || p_clr) fadd_req <= 1'b0;
        else if (enable && !leave_hold) fadd_req <= fadd_req_n;
    end

    // Registered IEEE addition/subtraction. Sorting/alignment, significand
    // arithmetic, cancellation normalization and rounding occupy separate
    // cycles rather than one path from the stack mux back to its write port.
    always_ff @(posedge clk) begin
        if (!rst_n || p_clr) begin
            fadd_busy <= 1'b0;
            fadd_phase <= 3'd0;
        end else if (enable && !leave_hold && fadd_start_n) begin
            fadd_a <= fadd_a_n;
            fadd_b <= fadd_b_n;
            fadd_busy <= 1'b1;
            fadd_phase <= 3'd0;
        end else if (fadd_busy) begin
            case (fadd_phase)
                3'd0: begin : add_align
                    logic [11:0] ea, eb, er, diff;
                    logic [55:0] xa, xb;
                    logic swap_ab;
                    ea = fadd_a[62:52] == 0 ? 12'd1 : {1'b0, fadd_a[62:52]};
                    eb = fadd_b[62:52] == 0 ? 12'd1 : {1'b0, fadd_b[62:52]};
                    xa = {fadd_a[62:52] != 0, fadd_a[51:0], 3'd0};
                    xb = {fadd_b[62:52] != 0, fadd_b[51:0], 3'd0};
                    swap_ab = ea < eb || (ea == eb && xa < xb);
                    er = swap_ab ? eb : ea;
                    diff = swap_ab ? eb - ea : ea - eb;
                    fadd_xa <= swap_ab ? xb : xa;
                    fadd_xb <= v64_shr_sticky(swap_ab ? xa : xb, int'(diff));
                    fadd_er <= er;
                    fadd_sign <= swap_ab ? fadd_b[63] : fadd_a[63];
                    fadd_same_sign <= fadd_a[63] == fadd_b[63];
                    fadd_special <= 1'b1;
                    if ((fadd_a[62:52] == 11'h7ff && fadd_a[51:0] != 0) ||
                        (fadd_b[62:52] == 11'h7ff && fadd_b[51:0] != 0) ||
                        (fadd_a[62:52] == 11'h7ff && fadd_b[62:52] == 11'h7ff &&
                         fadd_a[63] != fadd_b[63]))
                        fadd_special_value <= V64_CANON_NAN;
                    else if (fadd_a[62:52] == 11'h7ff)
                        fadd_special_value <= {fadd_a[63], 11'h7ff, 52'd0};
                    else if (fadd_b[62:52] == 11'h7ff)
                        fadd_special_value <= {fadd_b[63], 11'h7ff, 52'd0};
                    else if (fadd_a[62:0] == 0 && fadd_b[62:0] == 0)
                        fadd_special_value <= {fadd_a[63] & fadd_b[63], 63'd0};
                    else if (fadd_a[62:0] == 0) fadd_special_value <= fadd_b;
                    else if (fadd_b[62:0] == 0) fadd_special_value <= fadd_a;
                    else fadd_special <= 1'b0;
                    fadd_phase <= 3'd1;
                end
                3'd1: begin : add_significands
                    logic [56:0] sum;
                    if (fadd_same_sign) begin
                        sum = {1'b0, fadd_xa} + {1'b0, fadd_xb};
                        if (sum[56]) begin
                            fadd_sig <= {sum[56:2], sum[1] | sum[0]};
                            fadd_er <= fadd_er + 12'd1;
                        end else fadd_sig <= sum[55:0];
                    end else begin
                        fadd_sig <= fadd_xa - fadd_xb;
                        if (fadd_xa == fadd_xb) fadd_sign <= 1'b0;
                    end
                    // Build 99: only a cancelling subtraction needs the
                    // normalize beat (it is a no-op for equal signs).
                    fadd_phase <= fadd_same_sign ? 3'd3 : 3'd2;
                end
                3'd2: begin : add_normalize
                    logic [5:0] lz, shn;
                    lz = 6'd0;
                    for (int k = 0; k <= 55; k++)
                        if (fadd_sig[k]) lz = 6'(55 - k);
                    shn = (fadd_er - 12'd1 < {6'd0, lz})
                        ? 6'(fadd_er - 12'd1) : lz;
                    if (!fadd_same_sign && fadd_sig != 0) begin
                        fadd_sig <= fadd_sig << shn;
                        fadd_er <= fadd_er - {6'd0, shn};
                    end
                    fadd_phase <= 3'd3;
                end
                default: begin : add_round
                    logic [53:0] rounded;
                    logic [52:0] mant;
                    logic [11:0] er;
                    rounded = {1'b0, fadd_sig[55:3]} +
                        54'(fadd_sig[2] && (fadd_sig[1] || fadd_sig[0] || fadd_sig[3]));
                    er = fadd_er;
                    if (rounded[53]) begin
                        mant = rounded[53:1];
                        er = er + 12'd1;
                    end else mant = rounded[52:0];
                    if (fadd_special) fadd_result <= fadd_special_value;
                    else if (er >= 12'd2047) fadd_result <= {fadd_sign, 11'h7ff, 52'd0};
                    else if (mant == 0) fadd_result <= {fadd_sign, 63'd0};
                    else fadd_result <= {fadd_sign,
                        (er == 12'd1 && !mant[52]) ? 11'd0 : er[10:0], mant[51:0]};
                    fadd_busy <= 1'b0;
                end
            endcase
        end
    end
    logic [52:0]  fpm_ma_n, fpm_mb_n;
    logic         nwm_busy, nwm_pack;
    logic [5:0]   nwm_cnt;
    logic [105:0] nwm_acc, nwm_mcand;
    logic [52:0]  nwm_mplier;
    logic [10:0]  nwm_ea, nwm_eb;
    logic         nwm_sign;
    logic [63:0]  now_v64_q;
    logic [31:0]  nwm_vf_q;
    // Method-lookup cache: 8 entries of (cls,key)->mip, misses (FFFF)
    // included — builtin calls (ctx.fillRect, arr.push) repeat the same
    // miss every frame. Hit answers in the same beat the CALL op runs, so
    // repeated calls cost exactly what the one-clock CAM did. Insert on
    // parent result; invalidate on p_clr and on class-table pokes.
    logic [15:0] cmc_cls [0:7];
    logic [15:0] cmc_key [0:7];
    logic [15:0] cmc_mip [0:7];
    logic [7:0]  cmc_valid;
    logic [2:0]  cmc_wp;
    logic        cmc_hit;
    logic [15:0] cmc_hit_mip;
    always_comb begin
        cmc_hit = 1'b0;
        cmc_hit_mip = 16'hFFFF;
        for (int k = 0; k < 8; k++)
            if (cmc_valid[k] && cmc_cls[k] == vobj_cls_rdata &&
                cmc_key[k] == opw[23:8]) begin
                cmc_hit = 1'b1;
                cmc_hit_mip = cmc_mip[k];
            end
    end
    logic [3:0] cm_c, cm_c_n, cm_m, cm_m_n;
    logic [15:0] cm_mip, cm_mip_n, cm_key, cm_key_n, cm_cls, cm_cls_n;
    // String.replace needs two name_hash_tbl keys; one SRAM port → extra beat.
    logic hash2_q /*verilator public_flat_rd*/, hash2_n;
    // venv_valid_rdata settle counter (parent Port A lag after a ctor
    // return pokes venv). Counts beats, then trusts the bit.
    logic [2:0] venvw_q /*verilator public_flat_rd*/, venvw_n;
    // Bring-up: which fault arm fired (source line of the assignment).
    logic [15:0] fault_site /*verilator public_flat_rd*/, fault_site_n;
    logic [31:0] fault_arg, fault_arg_n;
    logic [6:0] tmr_i_q, tmr_i_n;
    logic [1:0] tmr_arm_q, tmr_arm_n; // #66b: 2-beat settle per slot
    logic tmr_found_q, tmr_found_n;
    logic [6:0] tmr_slot_q, tmr_slot_n;
    // The existing timer-slot walk gives the millisecond conversion many
    // beats to settle. Register it there, before the due-frame addition.
    logic signed [31:0] timer_ms_q, timer_ms_n, timer_frames_q, timer_frames_n;
    always_ff @(posedge clk)begin
        if(!rst_n)begin timer_ms_q<=0;timer_frames_q<=32'sd1;end
        else if(enable && !leave_hold)begin timer_ms_q<=timer_ms_n;timer_frames_q<=timer_frames_n;end
    end
    logic [11:0] clr_i;
    logic clr_busy;
    localparam int CLR_LIM = MAX_ARR;

    // Parent clr/poke + exec we into local copies. No opcode rewrite.
    // p_clr walks one index per clock (SRAM has no parallel clear).
    logic p_clr_busy;
    assign p_clr_busy = clr_busy | p_clr;

    // Working regs clock here. Parent sees *_q / leave_hold, not combo *_n.
    logic aset_win_retried;
    // CALL_METH fillRect: one SRAM window refill when obj_ok is false.
    logic cm_win /*verilator public_flat_rd*/;
    logic [7:0] bind_argc;
    assign bind_argc_q = bind_argc;
    logic [11:0] bind_base;
    assign bind_base_q = bind_base;
    logic [15:0] bind_ip;
    assign bind_ip_q = bind_ip;
    logic [7:0] bind_k;
    assign bind_k_q = bind_k;
    logic [1:0] bind_mode;
    assign bind_mode_q = bind_mode;
    logic [7:0] bind_n;
    assign bind_n_q = bind_n;
    logic bind_rd_arm;
    assign bind_rd_arm_q = bind_rd_arm;
    logic [6:0] bind_ret;
    assign bind_ret_q = bind_ret;
    logic [11:0] bind_src;
    assign bind_src_q = bind_src;
    logic [11:0] bind_vsp_next;
    assign bind_vsp_next_q = bind_vsp_next;
    logic [15:0] blit_sh;
    assign blit_sh_q = blit_sh;
    logic [7:0] blit_si;
    assign blit_si_q = blit_si;
    logic flip_x;
    assign flip_x_q = flip_x;
    logic flip_y;
    assign flip_y_q = flip_y;
    logic [15:0] blit_sw;
    assign blit_sw_q = blit_sw;
    logic [15:0] blit_sx;
    assign blit_sx_q = blit_sx;
    logic [15:0] blit_sy;
    assign blit_sy_q = blit_sy;
    logic [2:0] cc_at;
    assign cc_at_q = cc_at;
    logic signed [31:0] cc_av;
    assign cc_av_q = cc_av;
    logic cc_bok;
    assign cc_bok_q = cc_bok;
    logic [2:0] cc_bt;
    assign cc_bt_q = cc_bt;
    logic signed [31:0] cc_bv;
    assign cc_bv_q = cc_bv;
    logic [3:0] cc_d;
    assign cc_d_q = cc_d;
    logic [15:0] cc_h;
    assign cc_h_q = cc_h;
    logic [7:0] cc_len;
    assign cc_len_q = cc_len;
    logic cc_second;
    assign cc_second_q = cc_second;
    logic [1:0] cc_st;
    assign cc_st_q = cc_st;
    logic [15:0] code_raddr /*verilator public_flat_rd*/;
    assign code_raddr_q = code_raddr;
    logic [7:0] color;
    assign color_q = color;
    logic [1:0] ctx_align;
    assign ctx_align_q = ctx_align;
    // #37 textBaseline: 0=alphabetic 1=top 2=middle 3=bottom
    logic [1:0] ctx_baseline, ctx_baseline_n;
    assign ctx_baseline_q = ctx_baseline;
    logic ctx_smooth;
    logic signed [31:0] ctx_sx;
    assign ctx_sx_q = ctx_sx;
    logic signed [31:0] ctx_sy;
    assign ctx_sy_q = ctx_sy;
    logic signed [31:0] ctx_tx;
    assign ctx_tx_q = ctx_tx;
    logic signed [31:0] ctx_ty;
    assign ctx_ty_q = ctx_ty;
    logic [15:0] dbg_di_hit;
    assign dbg_di_hit_q = dbg_di_hit;
    logic [15:0] dbg_di_miss;
    assign dbg_di_miss_q = dbg_di_miss;
    logic [15:0] dbg_div_n;
    logic [15:0] dbg_json_ovf;
    logic [15:0] dbg_path_ovf;
    logic [7:0] fault_code /*verilator public_flat_rd*/;
    assign fault_code_q = fault_code;
    assign fault_site_q = fault_site;
    assign fault_arg_q  = fault_arg;
    logic [18:0] fb_dump_addr;
    assign fb_dump_addr_q = fb_dump_addr;
    logic fb_dump_sel;
    logic fb_swap;
    assign fb_swap_q = fb_swap;
    logic [7:0] fill_style_i;
    logic [7:0] stroke_style_i;
    logic [11:0] hp_aid;
    assign hp_aid_q = hp_aid;
    logic [7:0] hp_alen;
    assign hp_alen_q = hp_alen;
    logic [6:0] hp_aslot;
    assign hp_aslot_q = hp_aslot;
    logic [3:0] hp_cmd;
    assign hp_cmd_q = hp_cmd;
    logic [9:0] hp_eid /*verilator public_flat_rd*/;
    assign hp_eid_q = hp_eid;
    logic hp_env;
    assign hp_env_q = hp_env;
    logic hp_from_stack;
    assign hp_from_stack_q = hp_from_stack;
    logic hp_hit;
    assign hp_hit_q = hp_hit;
    logic [15:0] hp_key /*verilator public_flat_rd*/;
    assign hp_key_q = hp_key;
    logic [5:0] hp_len;
    assign hp_len_q = hp_len;
    logic [7:0] hp_lim;
    assign hp_lim_q = hp_lim;
    logic hp_make_arr;
    assign hp_make_arr_q = hp_make_arr;
    logic [3:0] hp_nat;
    assign hp_nat_q = hp_nat;
    logic [12:0] hp_oid;
    assign hp_oid_q = hp_oid;
    logic [2:0] hp_phase;
    assign hp_phase_q = hp_phase;
    logic [63:0] hp_proto;
    assign hp_proto_q = hp_proto;
    logic [2:0] hp_qi;
    assign hp_qi_q = hp_qi;
    logic [15:0] hp_qk [0:3];
    logic [2:0] hp_qn;
    assign hp_qn_q = hp_qn;
    logic [2:0] hp_qt [0:3];
    logic [63:0] hp_qv [0:3];
    genvar gi_hpq;
    generate
        for (gi_hpq = 0; gi_hpq < 4; gi_hpq++) begin : g_hp_pack
            assign hp_qk_pack_q[16*gi_hpq +: 16] = hp_qk[gi_hpq];
            assign hp_qt_pack_q[3*gi_hpq +: 3] = hp_qt[gi_hpq];
            assign hp_qv_pack_q[64*gi_hpq +: 64] = hp_qv[gi_hpq];
        end
    endgenerate
    logic [6:0] hp_ret;
    assign hp_ret_q = hp_ret;
    logic [63:0] hp_rval;
    assign hp_rval_q = hp_rval;
    logic [12:0] hp_si;
    assign hp_si_q = hp_si;
    logic [4:0] hp_slot;
    assign hp_slot_q = hp_slot;
    logic [15:0] hp_spr_h;
    assign hp_spr_h_q = hp_spr_h;
    logic [15:0] hp_spr_w;
    assign hp_spr_w_q = hp_spr_w;
    logic [4:0] hp_ss;
    assign hp_ss_q = hp_ss;
    logic [5:0] hp_tn;
    assign hp_tn_q = hp_tn;
    logic [11:0] hp_vbase;
    assign hp_vbase_q = hp_vbase;
    logic [63:0] hp_wval;
    assign hp_wval_q = hp_wval;
    logic imgd_armed;
    logic [9:0] imgd_h;
    assign imgd_h_q = imgd_h;
    logic [18:0] imgd_i;
    assign imgd_i_q = imgd_i;
    logic [18:0] imgd_n;
    assign imgd_n_q = imgd_n;
    logic imgd_v64;
    assign imgd_v64_q = imgd_v64;
    logic [9:0] imgd_w;
    assign imgd_w_q = imgd_w;
    logic [9:0] imgd_x;
    assign imgd_x_q = imgd_x;
    logic [9:0] imgd_x0;
    assign imgd_x0_q = imgd_x0;
    logic [9:0] imgd_y;
    assign imgd_y_q = imgd_y;
    logic [9:0] imgd_y0;
    assign imgd_y0_q = imgd_y0;
    logic [15:0] ip /*verilator public_flat_rd*/;
    assign ip_q = ip;
    logic [11:0] jn_arr;
    assign jn_arr_q = jn_arr;
    logic [15:0] jn_h;
    assign jn_h_q = jn_h;
    logic [15:0] jn_i;
    assign jn_i_q = jn_i;
    logic [10:0] jn_res;
    assign jn_res_q = jn_res;
    logic [7:0] js_i [0:JSON_STK-1];
    logic [2:0] js_ph [0:JSON_STK-1];
    logic [5:0] js_sp;
    assign js_sp_q = js_sp;
    logic [2:0] json_pph;
    assign json_pph_q = json_pph;
    logic [13:0] json_rp;
    assign json_rp_q = json_rp;
    logic [13:0] json_src;
    assign json_src_q = json_src;
    logic [13:0] json_srclen;
    assign json_srclen_q = json_srclen;
    logic [13:0] json_wp;
    assign json_wp_q = json_wp;
    logic looping;
    logic machine_fault /*verilator public_flat_rd*/;
    assign machine_fault_q = machine_fault;
    logic [63:0] minmax_acc;
    assign minmax_acc_q = minmax_acc;
    logic        cmp_done;
    logic [7:0]  cmp_status;
    logic [20:0] cmp_len;
    logic [6:0]  cmp_msglen;
    assign cmp_done_q   = cmp_done;
    assign cmp_status_q = cmp_status;
    assign cmp_len_q    = cmp_len;
    assign cmp_msglen_q = cmp_msglen;
    logic [2:0]  csr_mode;
    logic [21:0] csr_addr;
    logic [15:0] csr_wdata;
    logic        csr_oob;
    assign csr_mode_q  = csr_mode;
    assign csr_addr_q  = csr_addr;
    assign csr_wdata_q = csr_wdata;
    logic [17:0] src_setlen; logic src_setlen_stb;
    logic sysw_we;
    logic [3:0] sysw_field;
    logic [31:0] sysw_value;
    function automatic logic [3:0] system_field(input logic [15:0] key);
        begin
            system_field=15;
            for(integer f=0;f<11;f=f+1)
                if(key==id_sys_window[f*16+:16])system_field=4'(f);
        end
    endfunction
    // Scalars only. Toggle transfers an accepted context-property write to
    // the fast system/display domain without holding a multi-cycle pulse.
    always_ff @(posedge clk)begin
        if(!rst_n || p_clr)begin sysw_toggle_q<=0;sysw_field_q<=0;sysw_value_q<=0;end
        else if(enable && sysw_we)begin
            sysw_toggle_q<=!sysw_toggle_q;sysw_field_q<=sysw_field;sysw_value_q<=sysw_value;
        end
    end
    assign src_setlen_q = src_setlen;
    assign src_setlen_stb_q = src_setlen_stb;
    assign csr_oob_q   = csr_oob;
    logic [11:0] minmax_base;
    assign minmax_base_q = minmax_base;
    logic minmax_is_min;
    assign minmax_is_min_q = minmax_is_min;
    logic [7:0] minmax_k;
    assign minmax_k_q = minmax_k;
    logic [7:0] minmax_n;
    assign minmax_n_q = minmax_n;
    logic namcpy_armed;
    logic namcpy_repl;
    assign namcpy_repl_q = namcpy_repl;
    logic namcpy_v64;
    assign namcpy_v64_q = namcpy_v64;
    logic [15:0] name_rdaddr;
    assign name_rdaddr_q = name_rdaddr;
    logic path_active;
    logic [1:0] path_kind;
    logic path_stroke;
    assign path_stroke_q = path_stroke;
    logic signed [31:0] pc_a1 [0:PATH_MAX-1];
    logic signed [31:0] pc_a2 [0:PATH_MAX-1];
    logic signed [31:0] pc_a3 [0:PATH_MAX-1];
    logic signed [31:0] pc_a4 [0:PATH_MAX-1];
    logic signed [31:0] pc_a5 [0:PATH_MAX-1];
    logic pc_ccw [0:PATH_MAX-1];
    logic [4:0] pc_n;
    assign pc_n_q = pc_n;
    logic [1:0] pc_op [0:PATH_MAX-1];
    logic [4:0] pi;
    logic repl_did;
    logic repl_g;
    assign repl_g_q = repl_g;
    logic [7:0] repl_nlen;
    logic [7:0] repl_pat0;
    assign repl_pat0_q = repl_pat0;
    logic [7:0] repl_pat1;
    logic [7:0] repl_rch;
    assign repl_rch_q = repl_rch;
    logic [9:0] rh;
    assign rh_q = rh;
    logic running;
    logic [9:0] rw;
    assign rw_q = rw;
    logic signed [11:0] rx;
    assign rx_q = rx;
    logic signed [11:0] ry;
    assign ry_q = ry;
    logic signed [31:0] saved_sx;
    logic signed [31:0] saved_sy;
    logic signed [31:0] saved_tx;
    logic signed [31:0] saved_ty;
    logic [4:0] sq_i;
    assign sq_i_q = sq_i;
    logic [63:0] sq_rad;
    assign sq_rad_q = sq_rad;
    logic [25:0] sq_rem;
    assign sq_rem_q = sq_rem;
    logic [23:0] sq_root;
    assign sq_root_q = sq_root;
    logic [6:0] state;
    assign state_q = state;
    logic [6:0] txt_bn;
    assign txt_bn_q = txt_bn;
    logic [3:0] txt_ph;
    assign txt_ph_q = txt_ph;
    logic signed [15:0] txt_px;
    assign txt_px_q = txt_px;
    logic signed [15:0] txt_py;
    assign txt_py_q = txt_py;
    logic [31:0] txt_val;
    assign txt_val_q = txt_val;
    logic [2:0] txt_vt;
    assign txt_vt_q = txt_vt;
    logic v64_concat;
    assign v64_concat_q = v64_concat;
    logic v64_join;
    assign v64_join_q = v64_join;
    logic v64_sqrt;
    assign v64_sqrt_q = v64_sqrt;
    logic [7:0] valloc_arr_n;
    assign valloc_arr_n_q = valloc_arr_n;
    logic valloc_bind;
    assign valloc_bind_q = valloc_bind;
    logic [12:0] valloc_bind_src;
    assign valloc_bind_src_q = valloc_bind_src;
    logic [63:0] valloc_bind_this;
    assign valloc_bind_this_q = valloc_bind_this;
    logic [7:0] valloc_fn_a1;
    assign valloc_fn_a1_q = valloc_fn_a1;
    logic [15:0] valloc_fn_entry;
    assign valloc_fn_entry_q = valloc_fn_entry;
    logic [13:0] valloc_i;
    assign valloc_i_q = valloc_i;
    logic [1:0] valloc_kind;
    assign valloc_kind_q = valloc_kind;
    logic valloc_metrics;
    assign valloc_metrics_q = valloc_metrics;
    logic valloc_now_fn;
    assign valloc_now_fn_q = valloc_now_fn;
    logic valloc_proto;
    assign valloc_proto_q = valloc_proto;
    logic [12:0] valloc_proto_fn;
    assign valloc_proto_fn_q = valloc_proto_fn;
    logic valloc_regex;
    assign valloc_regex_q = valloc_regex;
    logic [31:0] valloc_regex_pack;
    assign valloc_regex_pack_q = valloc_regex_pack;
    logic valloc_retried;
    assign valloc_retried_q = valloc_retried;
    logic [13:0] varr_next;
    logic [11:0] vcall_argc;
    assign vcall_argc_q = vcall_argc;
    logic [63:0] vcall_ctor_val;
    assign vcall_ctor_val_q = vcall_ctor_val;
    logic [63:0] ctor_cur;
    logic [7:0] ctor_csp;
    logic [15:0] vcall_entry;
    assign vcall_entry_q = vcall_entry;
    logic vcall_set_this;
    assign vcall_set_this_q = vcall_set_this;
    logic [63:0] vcall_this;
    assign vcall_this_q = vcall_this;
    logic vcall_value;
    assign vcall_value_q = vcall_value;
    logic [8:0] vconsole_n;
    logic [7:0] vcsp /*verilator public_flat_rd*/;
    assign vcsp_q = vcsp;
    logic [7:0] vdiv_count;
    assign vdiv_count_q = vdiv_count;
    logic [52:0] vdiv_den;
    assign vdiv_den_q = vdiv_den;
    logic signed [12:0] vdiv_exp;
    assign vdiv_exp_q = vdiv_exp;
    logic [106:0] vdiv_num;
    assign vdiv_num_q = vdiv_num;
    logic [106:0] vdiv_quot;
    assign vdiv_quot_q = vdiv_quot;
    logic [53:0] vdiv_rem;
    assign vdiv_rem_q = vdiv_rem;
    logic vdiv_sign;
    assign vdiv_sign_q = vdiv_sign;
    logic [7:0] vdraw_color;
    assign vdraw_color_q = vdraw_color;
    logic [9:0] vdraw_h;
    assign vdraw_h_q = vdraw_h;
    logic [18:0] vdraw_i;
    assign vdraw_i_q = vdraw_i;
    logic [9:0] vdraw_w;
    assign vdraw_w_q = vdraw_w;
    logic [9:0] vdraw_x;
    assign vdraw_x_q = vdraw_x;
    logic [9:0] vdraw_y;
    assign vdraw_y_q = vdraw_y;
    logic [63:0] venv;
    assign venv_q = venv;
    logic [9:0] venv_next;
    logic [63:0] vfe_arr;
    assign vfe_arr_q = vfe_arr;
    logic [63:0] vfe_arr_s [0:7];
    logic [11:0] vfe_base;
    assign vfe_base_q = vfe_base;
    logic [11:0] vfe_base_s [0:7];
    logic [63:0] vfe_fn;
    assign vfe_fn_q = vfe_fn;
    logic [63:0] vfe_fn_s [0:7];
    logic [7:0] vfe_i;
    assign vfe_i_q = vfe_i;
    logic [7:0] vfe_i_s [0:7];
    logic [7:0] vfe_len;
    assign vfe_len_q = vfe_len;
    logic [7:0] vfe_len_s [0:7];
    logic [63:0] vfe_map;
    assign vfe_map_q = vfe_map;
    logic [63:0] vfe_map_s [0:7];
    logic [1:0] vfe_mode;
    assign vfe_mode_q = vfe_mode;
    logic [1:0] vfe_mode_s [0:7];
    // #39 Array.reduce: 1-bit walk flavor; the accumulator rides vfe_map.
    logic vfe_reduce, vfe_reduce_n;
    assign vfe_reduce_q = vfe_reduce;
    logic vfe_reduce_s [0:7];
    logic vfe_reduce_s_wdata;
    // findIndex: find-mode walk whose result is the INDEX (or -1), not the
    // element. Same save/restore discipline as vfe_reduce.
    logic vfe_findidx, vfe_findidx_n;
    assign vfe_findidx_q = vfe_findidx;
    logic vfe_findidx_s [0:7];
    logic vfe_findidx_s_wdata;
    // #41 Array.sort: comparator walk; cmp result rides vfe_map.
    logic vfe_sort, vfe_sort_n;
    logic vfe_sort_s [0:7];
    logic vfe_sort_s_wdata;
    logic [15:0] vfe_ret;
    assign vfe_ret_q = vfe_ret;
    logic [15:0] vfe_ret_s [0:7];
    logic [3:0] vfe_sp;
    assign vfe_sp_q = vfe_sp;
    logic vfree_armed;
    logic vfree_arr_long;
    logic [13:0] vgc_clear_i;
    assign vgc_clear_i_q = vgc_clear_i;
    logic vgc_halt_after;
    assign vgc_halt_after_q = vgc_halt_after;
    logic [13:0] vgc_qr;
    assign vgc_qr_q = vgc_qr;
    logic [13:0] vgc_qw;
    assign vgc_qw_q = vgc_qw;
    logic [1:0] vgc_resume;
    logic vgc_wait_after;
    assign vgc_wait_after_q = vgc_wait_after;
    logic vjs_rd_arm;
    logic [63:0] vjs_val [0:JSON_STK-1];
    logic [4:0] vlistener_n;
    assign vlistener_n_q = vlistener_n;
    logic [31:0] vmetrics_w;
    assign vmetrics_w_q = vmetrics_w;
    logic [11:0] vmod_count;
    assign vmod_count_q = vmod_count;
    logic [52:0] vmod_den;
    assign vmod_den_q = vmod_den;
    logic signed [12:0] vmod_exp;
    assign vmod_exp_q = vmod_exp;
    logic [52:0] vmod_rem;
    assign vmod_rem_q = vmod_rem;
    logic vmod_sign;
    assign vmod_sign_q = vmod_sign;
    logic [11:0] vnat_base;
    assign vnat_base_q = vnat_base;
    logic [2:0] vnat_dom;
    assign vnat_dom_q = vnat_dom;
    logic vprom_copy;
    assign vprom_copy_q = vprom_copy;
    logic vprom_done;
    logic [6:0] vprom_ret;
    assign vprom_ret_q = vprom_ret;
    logic [3:0] vraf_n /*verilator public_flat_rd*/;
    assign vraf_n_q = vraf_n;
    logic [31:0] vrng;
    // One owner: every reset/program clear restarts the documented sequence.
    always_ff @(posedge clk)
        if (!rst_n || p_clr) vrng <= 32'h6d2b79f5;
        else if (enable && !leave_hold) vrng <= vrng_n;
    logic [11:0] vsp;
    assign vsp_q = vsp;
    logic vst_hold_win;
    assign vst_hold_win_q = vst_hold_win;
    logic vst_refill_arm;
    assign vst_refill_arm_q = vst_refill_arm;
    logic [3:0] vst_refill_i;
    assign vst_refill_i_q = vst_refill_i;
    logic [6:0] vst_refill_ret;
    assign vst_refill_ret_q = vst_refill_ret;
    logic [11:0] vst_waddr;
    assign vst_waddr_q = vst_waddr;
    logic [63:0] vst_wdata;
    assign vst_wdata_q = vst_wdata;
    logic vst_we;
    assign vst_we_q = vst_we;
    logic [63:0] vthis;
    assign vthis_q = vthis;
    logic [6:0] vtimer_n;
    logic [31:0] vtimer_seq;
    logic [9:0] x;
    assign x_q = x;
    logic [9:0] y;
    assign y_q = y;


    // One writer for the method cache. Duplicate reset writers previously
    // made synthesis tie its valid bits to zero while simulation used it.
    always_ff @(posedge clk) begin
        if (!rst_n || p_clr) begin
            cmc_valid <= 8'd0;
            cmc_wp <= 3'd0;
        end else if (p_we && (p_sel == 6'd31 || p_sel == 6'd37 ||
                             p_sel == 6'd38 || p_sel == 6'd39)) begin
            cmc_valid <= 8'd0;
        end else if (cm_res_we && cm_scan) begin
            cmc_cls[cmc_wp] <= cm_cls;
            cmc_key[cmc_wp] <= cm_key;
            cmc_mip[cmc_wp] <= cm_res_mip;
            cmc_valid[cmc_wp] <= 1'b1;
            cmc_wp <= cmc_wp + 3'd1;
        end
    end

    always_ff @(posedge clk) begin
        if (!rst_n) begin
            opnd_q <= 1'b0;
            opnd2_q <= 1'b0;
            opnd3_q <= 1'b0;
            lvfast_q <= 1'b0;
            hash2_q <= 1'b0;
            venvw_q <= 3'd0;
            tmr_i_q <= 7'd0;
            tmr_arm_q <= 2'd0;
            tmr_found_q <= 1'b0;
            tmr_slot_q <= 7'd0;
            clr_busy <= 1'b0;
            clr_i <= 12'd0;
            p_clr_busy_q <= 1'b0;
        end else if (p_clr) begin
            clr_busy <= 1'b1;
            clr_i <= 12'd0;
        end else if (clr_busy) begin
            // Parent HEAP_CLR owns the JS banks. This walk is only the
            // handshake delay (p_clr_busy) plus leftover class-table FFs.
            // class tables live in the parent now (no clr here)
            if (clr_i + 12'd1 >= 12'(CLR_LIM))
                clr_busy <= 1'b0;
            else
                clr_i <= clr_i + 12'd1;
        end
        if (enable && !leave_hold) begin
            opnd_q <= opnd_n;
            opnd2_q <= opnd2_n;
            opnd3_q <= opnd3_n;
            lvfast_q <= lvfast_n;
            hash2_q <= hash2_n;
            venvw_q <= venvw_n;
            tmr_i_q <= tmr_i_n;
            tmr_arm_q <= tmr_arm_n;
            tmr_found_q <= tmr_found_n;
            tmr_slot_q <= tmr_slot_n;
        end else begin
            opnd_q <= 1'b0;
            opnd2_q <= 1'b0;
            opnd3_q <= 1'b0;
            lvfast_q <= 1'b0;
            hash2_q <= 1'b0;
            venvw_q <= 3'd0;
            tmr_i_q <= 7'd0;
            tmr_arm_q <= 2'd0;
            tmr_found_q <= 1'b0;
            tmr_slot_q <= 7'd0;
        end
        p_clr_busy_q <= p_clr_busy;
        // Bring-up: sticky until the next fault (read by VMSTAT).
        if (!rst_n) fault_site <= 16'd0;
        else fault_site <= fault_site_n;
    end

    // Sequential cell so Vivado keep_hierarchy is not dissolved as combo-only.
    logic hier_keep;
    always_ff @(posedge clk) if (enable) hier_keep <= ~hier_keep;

    // EXEC working FFs. Combo *_n is the D pin. Parent must not mux *_n.
    always_ff @(posedge clk) begin
        if (!rst_n) begin
            leave_hold <= 1'b0;
            vtimer_seq <= 32'd1;
            // cdone() is sticky within one program; the console clears its
            // own copy before each chained launch.
            cmp_done <= 1'b0;
            cmp_status <= 8'd0;
            cmp_len <= 21'd0;
            cmp_msglen <= 7'd0;
            fault_arg <= 32'd0;
            ctor_cur <= V64_UNDEFINED;
            ctor_csp <= 8'd0;
            cm_scan <= 1'b0;
            cm_armed <= 1'b0;
            cm_done <= 1'b0;
            cm_c <= 4'd0;
            cm_m <= 4'd0;
            cm_mip <= 16'hFFFF;
            cm_key <= 16'd0;
            lsv_scan <= 1'b0; lsv_op <= 2'd0;
            fpm_busy <= 1'b0; fpm_req <= 1'b0; nwm_busy <= 1'b0; nwm_pack <= 1'b0;
            now_v64_q <= 64'd0; nwm_vf_q <= 32'hFFFFFFFF;
            lsv_ev <= 64'd0; lsv_fn <= 64'd0; lsv_push <= 64'd0; lsv_base <= 12'd0;
            cm_cls <= 16'd0;
            cm_win <= 1'b0;
            // Parent GOT_HDR sets identity scale; exec fillRect uses these
            // FFs (ctx_sx=0 after rst made every ctx.fillRect clip to 0 —
            // INVADERS splash 1893 swaps, FBRAW nz=0).
            ctx_sx <= FX_ONE;
            ctx_sy <= FX_ONE;
            saved_sx <= FX_ONE;
            saved_sy <= FX_ONE;
            ctx_tx <= 32'sd0;
            ctx_ty <= 32'sd0;
        // leave_hold beat: parent unique case (ALLOC/HEAP/BIND) pokes *_ff.
        // enable is still 1 (parent state=EXEC). Apply hs_m here or venv/hp_*
        // stay stale and STORE_VAR walks a self-parent env forever.
        end else if (enable && !leave_hold) begin
                aset_win_retried <= aset_win_retried_n;
                cm_win <= cm_win_n;
                bind_argc <= bind_argc_n;
                bind_base <= bind_base_n;
                bind_ip <= bind_ip_n;
                bind_k <= bind_k_n;
                bind_mode <= bind_mode_n;
                bind_n <= bind_n_n;
                bind_rd_arm <= bind_rd_arm_n;
                bind_ret <= bind_ret_n;
                bind_src <= bind_src_n;
                bind_vsp_next <= bind_vsp_next_n;
                cm_scan <= cm_scan_n;
                // FP mul engines: 106-bit accumulate, one add per beat (safe depth)
                if (fpm_start_n) begin
                    fpm_busy <= 1'b1;
                    fpm_cnt <= 6'd0;
                    fpm_acc <= 106'd0;
                    fpm_mcand <= 106'(fpm_ma_n);
                    fpm_mplier <= fpm_mb_n;
                    fpm_sign <= fpm_sign_n;
                    fpm_ea <= fpm_ea_n;
                    fpm_eb <= fpm_eb_n;
                end else if (fpm_busy) begin
                    // Preserve acc + mcand*mplier with fixed zero skips.
                    // Four fixed wiring choices avoid wide variable shifts.
                    if (fpm_mplier[0]) fpm_acc <= fpm_acc + fpm_mcand;
                    if (fpm_mplier[52:1] == 52'd0) begin
                        fpm_busy <= 1'b0;
                        fpm_cnt <= fpm_cnt + 6'd1;
                    end else begin
                        case (fpm_zstep)
                            2'd3: begin
                                fpm_mcand <= fpm_mcand << 32;
                                fpm_mplier <= fpm_mplier >> 32;
                                fpm_cnt <= fpm_cnt + 6'd32;
                            end
                            2'd2: begin
                                fpm_mcand <= fpm_mcand << 16;
                                fpm_mplier <= fpm_mplier >> 16;
                                fpm_cnt <= fpm_cnt + 6'd16;
                            end
                            2'd1: begin
                                fpm_mcand <= fpm_mcand << 4;
                                fpm_mplier <= fpm_mplier >> 4;
                                fpm_cnt <= fpm_cnt + 6'd4;
                            end
                            default: begin
                                fpm_mcand <= fpm_mcand << 1;
                                fpm_mplier <= fpm_mplier >> 1;
                                fpm_cnt <= fpm_cnt + 6'd1;
                            end
                        endcase
                    end
                end
                fpm_req <= fpm_req_n;
                if (nwm_busy) begin
                    if (nwm_pack) begin
                        // The final 106-bit addition is already in nwm_acc.
                        // Round/pack on the next beat; consumers still hold busy.
                        now_v64_q <= v64_mul_pack(nwm_sign, nwm_ea, nwm_eb, nwm_acc);
                        nwm_busy <= 1'b0;
                        nwm_pack <= 1'b0;
                    end else begin
                        if (nwm_mplier[0]) nwm_acc <= nwm_acc + nwm_mcand;
                        nwm_mcand <= nwm_mcand << 1;
                        nwm_mplier <= nwm_mplier >> 1;
                        nwm_cnt <= nwm_cnt + 6'd1;
                        if (nwm_cnt == 6'd52) nwm_pack <= 1'b1;
                    end
                end else if (vframe_no != nwm_vf_q) begin
                    // frame clock product: v64_int32_number(vframe_no) x 16.666...
                    logic [63:0] nva;
                    nva = v64_int32_number(vframe_no);
                    nwm_vf_q <= vframe_no;
                    if (nva[62:0] == 63'd0) begin
                        now_v64_q <= {nva[63] ^ 1'b0, 63'd0};
                    end else begin
                        nwm_busy <= 1'b1;
                        nwm_cnt <= 6'd0;
                        nwm_pack <= 1'b0;
                        nwm_acc <= 106'd0;
                        nwm_mcand <= 106'({(nva[62:52] != 0), nva[51:0]});
                        nwm_mplier <= {1'b1, 52'h0aaaaaaaaaab};
                        nwm_sign <= nva[63];
                        nwm_ea <= nva[62:52];
                        nwm_eb <= 11'h403;
                    end
                end
                lsv_scan <= lsv_scan_n;
                lsv_op <= lsv_op_n;
                lsv_ev <= lsv_ev_n;
                lsv_fn <= lsv_fn_n;
                lsv_push <= lsv_push_n;
                lsv_base <= lsv_base_n;
                cm_armed <= cm_armed_n;
                cm_done <= cm_done_n;
                cm_c <= cm_c_n;
                cm_m <= cm_m_n;
                cm_key <= cm_key_n;
                cm_cls <= cm_cls_n;
                cm_mip <= cm_mip_n;
                blit_sh <= blit_sh_n;
                blit_si <= blit_si_n;
                flip_x <= flip_x_n;
                flip_y <= flip_y_n;
                blit_sw <= blit_sw_n;
                blit_sx <= blit_sx_n;
                blit_sy <= blit_sy_n;
                cc_at <= cc_at_n;
                cc_av <= cc_av_n;
                cc_bok <= cc_bok_n;
                cc_bt <= cc_bt_n;
                cc_bv <= cc_bv_n;
                cc_d <= cc_d_n;
                cc_h <= cc_h_n;
                cc_len <= cc_len_n;
                cc_second <= cc_second_n;
                cc_st <= cc_st_n;
                code_raddr <= code_raddr_n;
                color <= color_n;
                ctx_align <= ctx_align_n;
                ctx_baseline <= ctx_baseline_n;
                ctx_smooth <= ctx_smooth_n;
                ctx_sx <= ctx_sx_n;
                ctx_sy <= ctx_sy_n;
                ctx_tx <= ctx_tx_n;
                ctx_ty <= ctx_ty_n;
                dbg_di_hit <= dbg_di_hit_n;
                dbg_di_miss <= dbg_di_miss_n;
                dbg_div_n <= dbg_div_n_n;
                dbg_json_ovf <= dbg_json_ovf_n;
                dbg_path_ovf <= dbg_path_ovf_n;
                fault_code <= fault_code_n;
                fb_dump_addr <= fb_dump_addr_n;
                fb_dump_sel <= fb_dump_sel_n;
                fb_swap <= fb_swap_n;
                fill_style_i <= fill_style_i_n;
                stroke_style_i <= stroke_style_i_n;
                hp_aid <= hp_aid_n;
                hp_alen <= hp_alen_n;
                hp_aslot <= hp_aslot_n;
                hp_cmd <= hp_cmd_n;
                hp_eid <= hp_eid_n;
                hp_env <= hp_env_n;
                hp_from_stack <= hp_from_stack_n;
                hp_hit <= hp_hit_n;
                hp_key <= hp_key_n;
                hp_len <= hp_len_n;
                hp_lim <= hp_lim_n;
                hp_make_arr <= hp_make_arr_n;
                hp_nat <= hp_nat_n;
                hp_oid <= hp_oid_n;
                hp_phase <= hp_phase_n;
                hp_proto <= hp_proto_n;
                hp_qi <= hp_qi_n;
                if (hp_q_we) begin
                    hp_qk[hp_q_waddr] <= hp_qk_wdata;
                    hp_qt[hp_q_waddr] <= hp_qt_wdata;
                    hp_qv[hp_q_waddr] <= hp_qv_wdata;
                end
                hp_qn <= hp_qn_n;
                hp_ret <= hp_ret_n;
                hp_rval <= hp_rval_n;
                hp_si <= hp_si_n;
                hp_slot <= hp_slot_n;
                hp_spr_h <= hp_spr_h_n;
                hp_spr_w <= hp_spr_w_n;
                hp_ss <= hp_ss_n;
                hp_tn <= hp_tn_n;
                hp_vbase <= hp_vbase_n;
                hp_wval <= hp_wval_n;
                imgd_armed <= imgd_armed_n;
                imgd_h <= imgd_h_n;
                imgd_i <= imgd_i_n;
                imgd_n <= imgd_n_n;
                imgd_v64 <= imgd_v64_n;
                imgd_w <= imgd_w_n;
                imgd_x <= imgd_x_n;
                imgd_x0 <= imgd_x0_n;
                imgd_y <= imgd_y_n;
                imgd_y0 <= imgd_y0_n;
                ip <= ip_n;
                jn_arr <= jn_arr_n;
                jn_h <= jn_h_n;
                jn_i <= jn_i_n;
                jn_res <= jn_res_n;
                if (js_we) begin
                    js_i[js_waddr] <= js_i_wdata;
                    js_ph[js_waddr] <= js_ph_wdata;
                    vjs_val[js_waddr] <= vjs_val_wdata;
                end
                js_sp <= js_sp_n;
                json_pph <= json_pph_n;
                json_rp <= json_rp_n;
                json_src <= json_src_n;
                json_srclen <= json_srclen_n;
                json_wp <= json_wp_n;
                looping <= looping_n;
                machine_fault <= machine_fault_n;
                fault_arg <= fault_arg_n;
                minmax_acc <= minmax_acc_n;
                cmp_done <= cmp_done_n;
                cmp_status <= cmp_status_n;
                cmp_len <= cmp_len_n;
                cmp_msglen <= cmp_msglen_n;
                csr_mode <= csr_mode_n;
                csr_addr <= csr_addr_n;
                csr_wdata <= csr_wdata_n;
                src_setlen <= src_setlen_n;
                src_setlen_stb <= src_setlen_stb_n;
                csr_oob <= csr_oob_n;
                minmax_base <= minmax_base_n;
                minmax_is_min <= minmax_is_min_n;
                minmax_k <= minmax_k_n;
                minmax_n <= minmax_n_n;
                namcpy_armed <= namcpy_armed_n;
                namcpy_repl <= namcpy_repl_n;
                namcpy_v64 <= namcpy_v64_n;
                name_rdaddr <= name_rdaddr_n;
                path_active <= path_active_n;
                path_kind <= path_kind_n;
                path_stroke <= path_stroke_n;
                if (pc_we) begin
                    pc_a1[pc_waddr] <= pc_a1_wdata;
                    pc_a2[pc_waddr] <= pc_a2_wdata;
                    pc_a3[pc_waddr] <= pc_a3_wdata;
                    pc_a4[pc_waddr] <= pc_a4_wdata;
                    pc_a5[pc_waddr] <= pc_a5_wdata;
                    pc_ccw[pc_waddr] <= pc_ccw_wdata;
                    pc_op[pc_waddr] <= pc_op_wdata;
                end
                pc_n <= pc_n_n;
                pi <= pi_n;
                repl_did <= repl_did_n;
                repl_g <= repl_g_n;
                repl_nlen <= repl_nlen_n;
                repl_pat0 <= repl_pat0_n;
                repl_pat1 <= repl_pat1_n;
                repl_rch <= repl_rch_n;
                rh <= rh_n;
                running <= running_n;
                rw <= rw_n;
                rx <= rx_n;
                ry <= ry_n;
                saved_sx <= saved_sx_n;
                saved_sy <= saved_sy_n;
                saved_tx <= saved_tx_n;
                saved_ty <= saved_ty_n;
                sq_i <= sq_i_n;
                sq_rad <= sq_rad_n;
                sq_rem <= sq_rem_n;
                sq_root <= sq_root_n;
                state <= state_n;
                txt_bn <= txt_bn_n;
                txt_ph <= txt_ph_n;
                txt_px <= txt_px_n;
                txt_py <= txt_py_n;
                txt_val <= txt_val_n;
                txt_vt <= txt_vt_n;
                v64_concat <= v64_concat_n;
                v64_join <= v64_join_n;
                v64_sqrt <= v64_sqrt_n;
                valloc_arr_n <= valloc_arr_n_n;
                valloc_bind <= valloc_bind_n;
                valloc_bind_src <= valloc_bind_src_n;
                valloc_bind_this <= valloc_bind_this_n;
                valloc_fn_a1 <= valloc_fn_a1_n;
                valloc_fn_entry <= valloc_fn_entry_n;
                valloc_i <= valloc_i_n;
                valloc_kind <= valloc_kind_n;
                valloc_metrics <= valloc_metrics_n;
                valloc_now_fn <= valloc_now_fn_n;
                valloc_proto <= valloc_proto_n;
                valloc_proto_fn <= valloc_proto_fn_n;
                valloc_regex <= valloc_regex_n;
                valloc_regex_pack <= valloc_regex_pack_n;
                valloc_retried <= valloc_retried_n;
                varr_next <= varr_next_n;
                vcall_argc <= vcall_argc_n;
                vcall_ctor_val <= vcall_ctor_val_n;
                ctor_cur <= ctor_cur_n;
                ctor_csp <= ctor_csp_n;
                vcall_entry <= vcall_entry_n;
                vcall_set_this <= vcall_set_this_n;
                vcall_this <= vcall_this_n;
                vcall_value <= vcall_value_n;
                vconsole_n <= vconsole_n_n;
                // Parent ALLOC hs_vcsp/hs_vsp must win on the opnd beat:
                // vsp_n/vcsp_n would re-clock the pre-ALLOC value and drop
                // the MAKE_FN push (DONKEY CALL_VAL TOS=undef) / CALL_USER
                // frame (RET_VAL fault 2).
                // Sticky hs_m_vcsp (outer BIND p=1) must not win over
                // NEW_OBJ vcsp_n=+1 or RET_VAL vcsp_n=-1 — that kept exec
                // at 1, nested `new` wrote frame[0], Game RET fault 2.
                // vcsp already 0 + overlay p=1 + vcsp_n==0 re-raised the
                // popped forEach frame on RET (one_fe idle vret=fffc).
                // Raise-only when depth is already live; 0→1 is enable=0
                // FOREACH/ALLOC, not this EXEC beat.
                if (hs_m_vcsp && (p_vcsp != 8'd0) &&
                    (vcsp_n == vcsp) && (p_vcsp > vcsp) &&
                    (vcsp != 8'd0))
                    vcsp <= p_vcsp;
                else vcsp <= vcsp_n;
                vdiv_count <= vdiv_count_n;
                vdiv_den <= vdiv_den_n;
                vdiv_exp <= vdiv_exp_n;
                vdiv_num <= vdiv_num_n;
                vdiv_quot <= vdiv_quot_n;
                vdiv_rem <= vdiv_rem_n;
                vdiv_sign <= vdiv_sign_n;
                if (hs_m_venv) venv <= p_venv;
                else venv <= venv_n;
                vdraw_color <= vdraw_color_n;
                vdraw_h <= vdraw_h_n;
                vdraw_i <= vdraw_i_n;
                vdraw_w <= vdraw_w_n;
                vdraw_x <= vdraw_x_n;
                vdraw_y <= vdraw_y_n;
                venv_next <= venv_next_n;
                vfe_arr <= vfe_arr_n;
                if (vfe_s_we) begin
                    vfe_arr_s[vfe_s_waddr] <= vfe_arr_s_wdata;
                    vfe_base_s[vfe_s_waddr] <= vfe_base_s_wdata;
                    vfe_fn_s[vfe_s_waddr] <= vfe_fn_s_wdata;
                    vfe_i_s[vfe_s_waddr] <= vfe_i_s_wdata;
                    vfe_len_s[vfe_s_waddr] <= vfe_len_s_wdata;
                    vfe_map_s[vfe_s_waddr] <= vfe_map_s_wdata;
                    vfe_mode_s[vfe_s_waddr] <= vfe_mode_s_wdata;
                    vfe_reduce_s[vfe_s_waddr] <= vfe_reduce_s_wdata;
                    vfe_findidx_s[vfe_s_waddr] <= vfe_findidx_s_wdata;
                    vfe_sort_s[vfe_s_waddr] <= vfe_sort_s_wdata;
                    vfe_ret_s[vfe_s_waddr] <= vfe_ret_s_wdata;
                end
                vfe_base <= vfe_base_n;
                vfe_fn <= vfe_fn_n;
                vfe_i <= vfe_i_n;
                vfe_len <= vfe_len_n;
                vfe_map <= vfe_map_n;
                vfe_mode <= vfe_mode_n;
                vfe_reduce <= vfe_reduce_n;
                vfe_findidx <= vfe_findidx_n;
                vfe_sort <= vfe_sort_n;
                vfe_ret <= vfe_ret_n;
                vfe_sp <= vfe_sp_n;
                vfree_armed <= vfree_armed_n;
                vfree_arr_long <= vfree_arr_long_n;
                vgc_clear_i <= vgc_clear_i_n;
                vgc_halt_after <= vgc_halt_after_n;
                vgc_qr <= vgc_qr_n;
                vgc_qw <= vgc_qw_n;
                vgc_resume <= vgc_resume_n;
                vgc_wait_after <= vgc_wait_after_n;
                vjs_rd_arm <= vjs_rd_arm_n;
                // listener tables live only in the parent now (lsv service)
                vlistener_n <= vlistener_n_n;
                vmetrics_w <= vmetrics_w_n;
                vmod_count <= vmod_count_n;
                vmod_den <= vmod_den_n;
                vmod_exp <= vmod_exp_n;
                vmod_rem <= vmod_rem_n;
                vmod_sign <= vmod_sign_n;
                vnat_base <= vnat_base_n;
                vnat_dom <= vnat_dom_n;
                vprom_copy <= vprom_copy_n;
                vprom_done <= vprom_done_n;
                vprom_ret <= vprom_ret_n;
                vraf_n <= vraf_n_n;
                if (hs_m_vsp) vsp <= p_vsp;
                else vsp <= vsp_n;
                vst_hold_win <= vst_hold_win_n;
                vst_refill_arm <= vst_refill_arm_n;
                vst_refill_i <= vst_refill_i_n;
                vst_refill_ret <= vst_refill_ret_n;
                if (|vst_result_valid) begin
                    vst_waddr <= vst_result_addr[0] | vst_result_addr[1] | vst_result_addr[2];
                    vst_wdata <= vst_result_data[0] | vst_result_data[1] | vst_result_data[2];
                end
                vst_we <= vst_we_n;
                if (hs_m_vthis) vthis <= p_vthis;
                else vthis <= vthis_n;
                vtimer_n <= vtimer_n_n;
                vtimer_seq <= vtimer_seq_n;
                x <= x_n;
                y <= y_n;
                // Registered SRAM we: parent applies *_q on the leave_hold EXEC beat.
                json_mem_we_q <= json_mem_we;
                json_mem_waddr_q <= json_mem_waddr;
                json_mem_wdata_q <= json_mem_wdata;
                name_blen_we_q <= name_blen_we;
                name_blen_waddr_q <= name_blen_waddr;
                name_blen_wdata_q <= name_blen_wdata;
                name_hash_we_q <= name_hash_we;
                name_hash_waddr_q <= name_hash_waddr;
                name_hash_wdata_q <= name_hash_wdata;
                name_has_we_q <= name_has_we;
                name_has_waddr_q <= name_has_waddr;
                name_has_wdata_q <= name_has_wdata;
                varr_len_we_q <= varr_len_we;
                varr_len_waddr_q <= varr_len_waddr;
                varr_len_wdata_q <= varr_len_wdata;
                varr_lidx_we_q <= varr_lidx_we;
                varr_lidx_waddr_q <= varr_lidx_waddr;
                varr_lidx_wdata_q <= varr_lidx_wdata;
                varr_long_we_q <= varr_long_we;
                varr_long_waddr_q <= varr_long_waddr;
                varr_long_wdata_q <= varr_long_wdata;
                varr_valid_we_q <= varr_valid_we;
                varr_valid_waddr_q <= varr_valid_waddr;
                varr_valid_wdata_q <= varr_valid_wdata;
                venv_gen_we_q <= venv_gen_we;
                venv_gen_waddr_q <= venv_gen_waddr;
                venv_gen_wdata_q <= venv_gen_wdata;
                venv_len_we_q <= venv_len_we;
                venv_len_waddr_q <= venv_len_waddr;
                venv_len_wdata_q <= venv_len_wdata;
                venv_valid_we_q <= venv_valid_we;
                venv_valid_waddr_q <= venv_valid_waddr;
                venv_valid_wdata_q <= venv_valid_wdata;
                vobj_cls_we_q <= vobj_cls_we;
                vobj_cls_waddr_q <= vobj_cls_waddr;
                vobj_cls_wdata_q <= vobj_cls_wdata;
                vvar_valid_we_q <= vvar_valid_we;
                vvar_valid_waddr_q <= vvar_valid_waddr;
                vvar_valid_wdata_q <= vvar_valid_wdata;
                vvars_we_q <= vvars_we;
                venvs_we_q <= venvs_we;
                venvs_waddr_q <= venvs_waddr;
                venvs_wdata_q <= venvs_wdata;
                vvars_waddr_q <= vvars_waddr;
                vvars_wdata_q <= vvars_wdata;
                vframe_we_q <= vframe_we;
                vframe_waddr_q <= vframe_waddr;
                vframe_rip_wdata_q <= vframe_rip_wdata;
                vframe_bsp_wdata_q <= vframe_bsp_wdata;
                vframe_esc_wdata_q <= vframe_esc_wdata;
                vframe_this_wdata_q <= vframe_this_wdata;
                vframe_env_wdata_q <= vframe_env_wdata;
                vframe_fn_wdata_q <= vframe_fn_wdata;
                vframe_ctor_wdata_q <= vframe_ctor_wdata;
                vraf_we_q <= vraf_we;
                vraf_waddr_q <= vraf_waddr;
                vraf_wdata_q <= vraf_wdata;
                vtimer_we_q <= vtimer_we;
                vtimer_waddr_q <= vtimer_waddr;
                vtimer_valid_wdata_q <= vtimer_valid_wdata;
                vtimer_due_wdata_q <= vtimer_due_wdata;
                vtimer_fn_wdata_q <= vtimer_fn_wdata;
                vtimer_id_wdata_q <= vtimer_id_wdata;
                vtimer_period_wdata_q <= vtimer_period_wdata;
                vst_win0_we_q <= vst_win0_we;
                vst_win0_wdata_q <= vst_win0_wdata;
                vvars_raddr_q <= vvars_raddr;
                varr_raddr_q <= varr_raddr;
                vobj_raddr_q <= vobj_raddr;
                vfn_raddr_q <= vfn_raddr;
                name_off_raddr_q <= name_off_raddr;
                fill_lut_raddr_q <= fill_lut_raddr;
                vframe_raddr_q <= vframe_raddr;
                vtimer_raddr_q <= vtimer_raddr;
                vconsts_raddr_q <= vconsts_raddr;
                name_blen_raddr_q <= name_blen_raddr;
                name_hash_raddr_q <= name_hash_raddr;
                leave_hold <= (state_n != S_V64_EXEC);
                if (state_n != S_V64_EXEC || leave_hold) pf_ok <= 1'b0;
                else if (opw_cap_n) pf_ok <= 1'b1;
                // consume the post-parent one-shot at the first op-end
                if (state == S_V64_EXEC && state_n == S_FETCH_WAIT)
                    post_parent_q <= 1'b0;
        end else begin
            leave_hold <= 1'b0;
                // Parent vtimer_n is truth (see the
                // parent mirror); absorb it while frozen so fire-time
                // frees are visible to the setTimeout full-check.
                vtimer_n <= p_vtimer_n;
                vtimer_seq <= p_vtimer_seq;
                json_mem_we_q <= 1'b0;
                name_blen_we_q <= 1'b0;
                name_hash_we_q <= 1'b0;
                name_has_we_q <= 1'b0;
                varr_len_we_q <= 1'b0;
                varr_lidx_we_q <= 1'b0;
                varr_long_we_q <= 1'b0;
                varr_valid_we_q <= 1'b0;
                venv_gen_we_q <= 1'b0;
                venv_len_we_q <= 1'b0;
                venv_valid_we_q <= 1'b0;
                vobj_cls_we_q <= 1'b0;
                vvar_valid_we_q <= 1'b0;
                vvars_we_q <= 1'b0;
                venvs_we_q <= 1'b0;
                vframe_we_q <= 1'b0;
                vraf_we_q <= 1'b0;
                vtimer_we_q <= 1'b0;
                vst_win0_we_q <= 1'b0;
                if (hs_m_ip) ip <= p_ip;
                if (hs_m_code) code_raddr <= p_code_raddr;
                if (hs_m_state) begin
                    state <= p_state;
                    if (p_state == S_V64_EXEC) post_parent_q <= 1'b1;
                    /* pf_ok: TRUE only for the EXEC entry that came from
                       the parent's S_FETCH_WAIT dispatch — the one path
                       whose handover makes the code port stream ip+1
                       through EXEC (the parent-side mux applies it with
                       the parent-registered mask; OUR mirror of the
                       address lags a beat, so no local address compare
                       can verify it — provenance can). Re-entries from
                       ALLOC/event/call flows leave it 0. */
                    pf_ok <= (state == S_FETCH_WAIT && p_state == S_V64_EXEC);
                end
                if (hs_m_vsp) vsp <= p_vsp;
                if (hs_m_hp_cmd) hp_cmd <= p_hp_cmd;
                if (hs_m_hp_oid) hp_oid <= p_hp_oid;
                if (hs_m_hp_aid) hp_aid <= p_hp_aid;
                if (hs_m_hp_env) hp_env <= p_hp_env;
                if (hs_m_hp_eid) hp_eid <= p_hp_eid;
                if (hs_m_hp_slot) hp_slot <= p_hp_slot;
                if (hs_m_hp_aslot) hp_aslot <= p_hp_aslot;
                if (hs_m_hp_len) hp_len <= p_hp_len;
                if (hs_m_hp_alen) hp_alen <= p_hp_alen;
                if (hs_m_hp_lim) hp_lim <= p_hp_lim;
                if (hs_m_hp_key) hp_key <= p_hp_key;
                if (hs_m_hp_wval) hp_wval <= p_hp_wval;
                if (hs_m_hp_rval) hp_rval <= p_hp_rval;
                if (hs_m_hp_hit) hp_hit <= p_hp_hit;
                if (hs_m_hp_ret) hp_ret <= p_hp_ret;
                if (hs_m_hp_phase) hp_phase <= p_hp_phase;
                if (hs_m_hp_qn) hp_qn <= p_hp_qn;
                if (hs_m_hp_qi) hp_qi <= p_hp_qi;
                if (hs_m_hp_si) hp_si <= p_hp_si;
                if (hs_m_hp_ss) hp_ss <= p_hp_ss;
                if (hs_m_hp_tn) hp_tn <= p_hp_tn;
                if (hs_m_hp_from_stack) hp_from_stack <= p_hp_from_stack;
                if (hs_m_hp_make_arr) hp_make_arr <= p_hp_make_arr;
                if (hs_m_hp_vbase) hp_vbase <= p_hp_vbase;
                if (hs_m_hp_spr_w) hp_spr_w <= p_hp_spr_w;
                if (hs_m_hp_spr_h) hp_spr_h <= p_hp_spr_h;
                if (hs_m_hp_nat) hp_nat <= p_hp_nat;
                if (hs_m_hp_qk) begin
                    hp_qk[0] <= p_hp_qk_pack[15:0];
                    hp_qk[1] <= p_hp_qk_pack[31:16];
                    hp_qk[2] <= p_hp_qk_pack[47:32];
                    hp_qk[3] <= p_hp_qk_pack[63:48];
                end
                if (hs_m_hp_qv) begin
                    hp_qv[0] <= p_hp_qv_pack[63:0];
                    hp_qv[1] <= p_hp_qv_pack[127:64];
                    hp_qv[2] <= p_hp_qv_pack[191:128];
                    hp_qv[3] <= p_hp_qv_pack[255:192];
                end
                if (hs_m_hp_qt) begin
                    hp_qt[0] <= p_hp_qt_pack[2:0];
                    hp_qt[1] <= p_hp_qt_pack[5:3];
                    hp_qt[2] <= p_hp_qt_pack[8:6];
                    hp_qt[3] <= p_hp_qt_pack[11:9];
                end
                if (hs_m_valloc_kind) valloc_kind <= p_valloc_kind;
                if (hs_m_valloc_i) valloc_i <= p_valloc_i;
                if (hs_m_valloc_arr_n) valloc_arr_n <= p_valloc_arr_n;
                if (hs_m_valloc_retried) valloc_retried <= p_valloc_retried;
                if (hs_m_vnat_dom) vnat_dom <= p_vnat_dom;
                if (hs_m_vnat_base) vnat_base <= p_vnat_base;
                if (hs_m_valloc_now_fn) valloc_now_fn <= p_valloc_now_fn;
                if (hs_m_valloc_bind) valloc_bind <= p_valloc_bind;
                if (hs_m_valloc_bind_src) valloc_bind_src <= p_valloc_bind_src;
                if (hs_m_valloc_bind_this) valloc_bind_this <= p_valloc_bind_this;
                if (hs_m_valloc_fn_entry) valloc_fn_entry <= p_valloc_fn_entry;
                if (hs_m_valloc_fn_a1) valloc_fn_a1 <= p_valloc_fn_a1;
                if (hs_m_valloc_proto) valloc_proto <= p_valloc_proto;
                if (hs_m_valloc_proto_fn) valloc_proto_fn <= p_valloc_proto_fn;
                if (hs_m_valloc_metrics) valloc_metrics <= p_valloc_metrics;
                if (hs_m_valloc_regex) valloc_regex <= p_valloc_regex;
                if (hs_m_valloc_regex_pack) valloc_regex_pack <= p_valloc_regex_pack;
                if (hs_m_vcall_value) vcall_value <= p_vcall_value;
                if (hs_m_vcall_argc) vcall_argc <= p_vcall_argc;
                if (hs_m_vcall_entry) vcall_entry <= p_vcall_entry;
                if (hs_m_vcall_set_this) vcall_set_this <= p_vcall_set_this;
                if (hs_m_vcall_this) vcall_this <= p_vcall_this;
                if (hs_m_vcall_ctor_val) vcall_ctor_val <= p_vcall_ctor_val;
                // GOT_HDR p_clr must drop leftover fault/vcsp. hs_vcsp(0)
                // is ignored by the !=0 guard, so PACMAN inherited INVADERS
                // fault=2 and bounced to READY in HEAP_CLR.
                if (p_clr) begin
                    machine_fault <= 1'b0;
                    fault_code <= 8'd0;
                    // cdone() is sticky; without this clear the NEXT chained
                    // program (COMPILE after the editor's F2) instantly
                    // consumes the stale status in C_CMP_WAIT — COMPILE
                    // printed SAVED. and never compiled.
                    cmp_done <= 1'b0;
                    cmp_status <= 8'd0;
                    cmp_len <= 21'd0;
                    cmp_msglen <= 7'd0;
                    vcsp <= 8'd0;
                    cm_scan <= 1'b0;
                    cm_armed <= 1'b0;
                    cm_done <= 1'b0;
                    cm_mip <= 16'hFFFF;
                    ctor_cur <= V64_UNDEFINED;
                    ctor_csp <= 8'd0;
                    ctx_sx <= FX_ONE;
                    ctx_sy <= FX_ONE;
                    saved_sx <= FX_ONE;
                    saved_sy <= FX_ONE;
                    ctx_tx <= 32'sd0;
                    ctx_ty <= 32'sd0;
                    // Canvas state must not survive a title load. The parent
                    // clears its own ctx_align on RUN, but exec keeps the
                    // live copy — so a title that set textAlign="center"
                    // (DONKEY) left every later title centred. ASTEROID and
                    // PACMAN never set textAlign at all yet reported
                    // align=1, and ASTEROID's self-centred text drew half a
                    // string left of where it belonged.
                    ctx_align <= 2'd0;
                    ctx_baseline <= 2'd0;
                    fill_style_i <= 8'd0;
                    stroke_style_i <= 8'd0;
                    vfe_arr <= V64_UNDEFINED;
                    vfe_fn <= V64_UNDEFINED;
                    vfe_i <= 8'd0;
                    vfe_ret <= 16'd0;
                    vfe_base <= '0;
                    vfe_mode <= 2'd0;
                    vfe_map <= V64_UNDEFINED;
                    vfe_reduce <= 1'b0;
                    vfe_findidx <= 1'b0;
                    vfe_sort <= 1'b0;
                    vfe_len <= 8'd0;
                    vfe_sp <= 4'd0;
                // leave_hold EXEC: parent is still EXEC (casestate FOREACH
                // after RET 0xfffc / ALLOC). Sticky ALLOC hs_vcsp re-raised
                // the popped callback frame (one_fe nops fault 1, nested
                // forEach wrote frame[0]). HEAP/BIND pokes still land —
                // those states have enable=0. Do not skip hs_m_venv here
                // (STORE_VAR self-parent walk).
                // FOREACH done hs_vcsp(0) must land: the !=0 guard left
                // parent/exec depth stuck at ALLOC (vret=fffc after nops).
                end else if (hs_m_vcsp &&
                             !(enable && leave_hold) &&
                             ((p_vcsp != 8'd0 && p_vcsp >= vcsp) ||
                              (p_vcsp == 8'd0 && p_state == S_V64_FOREACH)))
                    vcsp <= p_vcsp;
                // FOREACH: parent state is FOREACH so enable=0. i++ must
                // land here or RET 0xfffc / nested CALL_METHOD save stale i.
                // Pop restores the exec nest stack (parent vfe_arr_s is empty).
                if (!p_clr && hs_m_vfe_pop && (vfe_sp != 4'd0)) begin
                    vfe_arr <= vfe_arr_s[vfe_sp - 4'd1];
                    vfe_fn <= vfe_fn_s[vfe_sp - 4'd1];
                    vfe_i <= vfe_i_s[vfe_sp - 4'd1];
                    vfe_len <= vfe_len_s[vfe_sp - 4'd1];
                    vfe_ret <= vfe_ret_s[vfe_sp - 4'd1];
                    vfe_base <= vfe_base_s[vfe_sp - 4'd1];
                    vfe_mode <= vfe_mode_s[vfe_sp - 4'd1];
                    vfe_map <= vfe_map_s[vfe_sp - 4'd1];
                    vfe_reduce <= vfe_reduce_s[vfe_sp - 4'd1];
                    vfe_findidx <= vfe_findidx_s[vfe_sp - 4'd1];
                    vfe_sort <= vfe_sort_s[vfe_sp - 4'd1];
                    vfe_sp <= vfe_sp - 4'd1;
                end else if (!p_clr && hs_m_vfe_i)
                    vfe_i <= p_vfe_i;
                // ALLOC kind 3 pulses p_frame_we on the CTOR_PAD beat
                // (enable=0). Same-cycle hs_vcall_ctor_val(UNDEF) must not
                // wipe this — RET_VAL samples ctor_cur, not lagged SRAM.
                // Not else-if vs hs_vcsp: ALLOC writes both the same beat.
                // Only OBJECT: CALL_USER p_frame_ctor=UNDEF must not steal
                // the instance (constructor that calls f() then RET).
                if (!p_clr && p_frame_we &&
                    p_frame_ctor[63:48] == V64_TAG_PREFIX &&
                    p_frame_ctor[47:44] == V64_KIND_OBJECT) begin
                    ctor_cur <= p_frame_ctor;
                    ctor_csp <= {1'b0, p_frame_idx} + 8'd1;
                    // LOAD_VAR __this reads vthis. hs_m_vthis from kind 3
                    // is visible next cycle; plant now so nested `this.n=n`
                    // is not UNDEF / the outer instance.
                    vthis <= p_frame_ctor;
                end
                // Kind 3 also pulses hs_vthis(UNDEF) for CALL_USER. Do not
                // wipe the instance we just planted (nested this.n=n).
                if (hs_m_vthis &&
                    !(p_vthis[63:48] == V64_TAG_PREFIX &&
                      p_vthis[47:44] == V64_KIND_UNDEFINED &&
                      ctor_cur[63:48] == V64_TAG_PREFIX &&
                      ctor_cur[47:44] == V64_KIND_OBJECT))
                    vthis <= p_vthis;
                if (hs_m_venv) venv <= p_venv;
                if (hs_m_vraf_n) vraf_n <= p_vraf_n;
                if (hs_m_vlistener_n) vlistener_n <= p_vlistener_n;
                if (hs_m_vgc_halt_after) vgc_halt_after <= p_vgc_halt_after;
                if (hs_m_vgc_wait_after) vgc_wait_after <= p_vgc_wait_after;
                if (hs_m_vgc_clear_i) vgc_clear_i <= p_vgc_clear_i;
                if (hs_m_vgc_qr) vgc_qr <= p_vgc_qr;
                if (hs_m_vgc_qw) vgc_qw <= p_vgc_qw;
                if (hs_m_vdraw_i) vdraw_i <= p_vdraw_i;
                if (hs_m_vdraw_x) vdraw_x <= p_vdraw_x;
                if (hs_m_vdraw_y) vdraw_y <= p_vdraw_y;
                if (hs_m_vdraw_w) vdraw_w <= p_vdraw_w;
                if (hs_m_vdraw_h) vdraw_h <= p_vdraw_h;
                if (hs_m_vdraw_color) vdraw_color <= p_vdraw_color;
        end
    end

    // Packed sprite dims from parent (not unpacked array ports).
    logic [15:0] spr_hh [0:MAX_SPR-1];
    logic [15:0] spr_nid [0:15];
    logic [15:0] spr_ww [0:MAX_SPR-1];
    genvar gi_e64spr;
    generate
        for (gi_e64spr = 0; gi_e64spr < MAX_SPR; gi_e64spr++) begin : g_e64_spr
            assign spr_hh[gi_e64spr] = spr_hh_pack[16*gi_e64spr +: 16];
            assign spr_nid[gi_e64spr] = spr_nid_pack[16*gi_e64spr +: 16];
            assign spr_ww[gi_e64spr] = spr_ww_pack[16*gi_e64spr +: 16];
        end
    endgenerate

    logic [10:0] eb;
    logic [51:0] fb;
    logic [52:0] mb;
    logic [15:0] q;
    logic sb;
    logic [55:0] sig;
    logic sr;
    logic sticky;
    logic [55:0] xb;
    // Parent ALLOC hs_vsp/hs_vcsp is visible this cycle; the exec FF lags
    // one beat (MAKE_FN+CALL_VAL TOS, CALL_USER RET_VAL vcsp).
    logic [11:0] vsp_hs;
    logic [7:0] vcsp_hs;
    logic [63:0] venv_hs;
    logic [63:0] vthis_hs;
    assign vsp_hs = hs_m_vsp ? p_vsp : vsp;
    assign vcsp_hs = hs_m_vcsp ? p_vcsp : vcsp;
    assign venv_hs = hs_m_venv ? p_venv : venv;
    assign vthis_hs = hs_m_vthis ? p_vthis : vthis;
    // Packed vst_win_pack port stays (no unpacked vst_peek[] port). Nested
    // vst_win_pack[i +: 64][11:0] is illegal SV (Synth 8-2599). Unpack once.
    logic [63:0] vst_s [0:15];
    genvar gi_vsts;
    generate
        for (gi_vsts = 0; gi_vsts < 16; gi_vsts++) begin : g_vst_s
            assign vst_s[gi_vsts] = vst_win_pack[64 * gi_vsts +: 64];
        end
    endgenerate
    `define VST_REL(addr) (((((vsp_hs)>(addr)) && (((vsp_hs)-(addr)-12'd1)<12'd16))) ? 4'((vsp_hs)-(addr)-12'd1) : 4'd0)
    `define VST_AT(addr) vst_s[`VST_REL(addr)]

    // Frame clock (performance.now / Date.now / getTime): all three
    // opcode branches compute the SAME product, so one shared instance
    // serves them — this removes two full 53x53 comb multipliers.
    // now_v64 comes from the nwm engine (now_v64_q), recomputed over 54
    // beats whenever vframe_no changes; consumers hold on nwm_busy.

    // Comb pack/normalize/round on a REGISTERED 106-bit product — the
    // 53x53 comb multiply itself (477 series CARRY4s, the -250ns path)
    // moved to 53-beat shift-add engines.
    function automatic logic [63:0] v64_mul_pack(
        input logic sign,
        input logic [10:0] ea,
        input logic [10:0] eb,
        input logic [105:0] product
    );
        logic [10:0] ef;
        logic [52:0] q;
        logic [53:0] rounded;
        logic guard, sticky;
        // Product top is -1..105; the biased exponent is -1126..3073
        // and an underflow shift is at most 1074. Keep arithmetic at
        // those widths instead of cascading 32-bit exponent adders.
        logic signed [7:0] p;
        logic signed [12:0] er, shift, exponent_sum;
        begin
            // highest set bit: priority scan (log-depth encoder form)
            p = -8'sd1;
            for (int k = 0; k < 106; k++)
                if (product[k])
                    p = 8'(k);
            exponent_sum = ((ea == 0) ? 13'sd1 : $signed({2'b0, ea}))
                         + ((eb == 0) ? 13'sd1 : $signed({2'b0, eb}));
            er = exponent_sum - 13'sd1127 + 13'(p);
            shift = 13'(p) - 13'sd52;
            ef = 11'(er);
            if (er <= 13'sd0) begin
                // Cancel p algebraically: p-52+1-(exponent_sum-1127+p).
                // This shift depends only on operand exponents, avoiding
                // a second product-dependent carry chain.
                shift = 13'sd1076 - exponent_sum;
                ef = 11'd0;
            end
            q = (shift >= 13'sd106) ? 53'd0 : 53'(product >> shift);
            guard = 1'b0;
            sticky = 1'b0;
            if (shift > 13'sd0 && shift <= 13'sd106) begin
                logic [105:0] below_mask;
                logic [6:0] below_count;
                below_count = 7'(shift - 13'sd1);
                guard = product[below_count];
                // masked OR-reduce (tree form): sticky = any bit below guard
                below_mask = ~({106{1'b1}} << below_count);
                sticky = |(product & below_mask);
            end else if (shift > 13'sd106)
                sticky = |product;
            rounded = {1'b0, q} + (guard && (sticky || q[0]));
            if (ef != 0 && rounded[53]) begin
                q = rounded[53:1];
                er = er + 13'sd1;
                ef = 11'(er);
            end else
                q = rounded[52:0];
            if (er >= 13'sd2047)
                v64_mul_pack = {sign, 11'h7ff, 52'd0};
            else if (ef == 0 && q[52])
                v64_mul_pack = {sign, 11'd1, q[51:0]};
            else if (q == 0)
                v64_mul_pack = {sign, 63'd0};
            else
                v64_mul_pack = {sign, ef, q[51:0]};
        end
    endfunction
    // v64_mul_task deleted: the comb 53x53 multiply moved to
    // the fpm/nwm shift-add engines; packing lives in v64_mul_pack.
    // len<=65535 and scale<=15: exact width fits23bits. Balanced
    // shift/add avoids another multiplier beside the shared font product.
    // Intersect original signed geometry before narrowing to raster ports.
    function automatic logic [19:0] rect_clip_axis(
        input logic signed [47:0] origin,
        input logic signed [47:0] extent,
        input logic [9:0] limit);
        logic signed [48:0] finish, lo, hi, bound;
        begin
            bound = $signed({39'd0,limit});
            finish = {origin[47],origin} + {extent[47],extent};
            lo = origin < 0 ? 49'sd0 : {origin[47],origin};
            hi = finish > bound ? bound : finish;
            if (extent <= 0 || lo >= bound || hi <= lo)
                rect_clip_axis = 20'd0;
            else rect_clip_axis = {10'(lo),10'(hi-lo)};
        end
    endfunction

    function automatic logic [31:0] text_pixel_width(
        input logic [15:0] len, input logic [3:0] scale
    );
        logic [22:0] base, lo, hi;
        begin
            base = {4'd0, len, 3'd0};
            lo = (scale[0] ? base : 23'd0) +
                 (scale[1] ? base << 1 : 23'd0);
            hi = (scale[2] ? base << 2 : 23'd0) +
                 (scale[3] ? base << 3 : 23'd0);
            text_pixel_width = {9'd0, lo + hi};
        end
    endfunction
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
