jmrothberg/JMR-JS-CSS-FPGA-COMPUTER/rtl/jmr_js_core.sv

// Shared JS-native core — Verilator tops this; board top is PHY shell only.
// Pattern cite: BASIC jmr_core + standalone_mode.
// storage_engine + work/source BRAM for DIR/LOAD/SAVE/REMOVE.
module jmr_js_core #(
    parameter int unsigned SD_INIT_DIV = 127,
    parameter int unsigned SD_RUN_DIV  = 3,
    // Short default for simulator/debug; the board explicitly selects 60 Hz.
    parameter int unsigned FRAME_DIV   = 65535,
    // 1 = behavioral 8 MiB SRAM (FPGA-SIM). 0 = ports for board MIG / ASIC.
    // Not `ifdef SYNTHESIS` — same RTL, board instantiates #(.SRAM_INTERNAL(0)).
    parameter bit SRAM_INTERNAL = 1,
    parameter int unsigned BOOT_CLOCK_HZ = 100000000,
    // u_vm runs on clk/VM_CLK_DIV; 1 = passthrough. Everything else stays on
    // clk: jmr_fb_scanout needs one SRAM fetch per 100 ns to sustain 640x480.
    parameter int unsigned VM_CLK_DIV = 3
) (
    input  logic        clk,
    input  logic        pixel_clk,   // mini-FB read domain (board HDMI)
    input  logic        rst_n,
    input  logic        standalone_mode,
    input  logic        kbd_push,
    input  logic [7:0]  kbd_data,
    input  logic [5:0]  joy_in,
    output logic [5:0]  joy_out,
    // analog-joy: raw Pmod stick axes + 5 discrete buttons (A,B,C,D,click).
    // Board top wires these from jmr_i2c_joy; FPGA-SIM/PYTHON drive them
    // over a debug RPC. digital joy_in/joy_out above are unchanged — this
    // is extra axes a title can poll, not a mouse (analog-joy).
    input  logic [7:0]  analog_x,
    input  logic [7:0]  analog_y,
    input  logic [4:0]  joy_btn,
    output logic [6:0]  stor_dbg_state_o,
    output logic [15:0] stor_dbg_op_clk_o,
    output logic [6:0]  cons_dbg_state_o,
    output logic        game_view_o,
    output logic [31:0] vdbg_o,
    output logic        vdbg_fault_o,
    output logic [31:0] vm_hdbg,
    output logic [31:0] vm_fdbg,
    output logic        vm_fdbg_v,
    output logic [127:0] vm_ftrace,
    output logic [47:0]  vm_gdbg,
    // sound-native poke (core clock; PSG leaf + CDC live in the top)
    input  logic        snd_ack, // destination captured the held sound packet
    output logic        snd_tgl,
    output logic [1:0]  snd_ch,
    output logic [15:0] snd_freq,
    output logic [3:0]  snd_vol,
    output logic [7:0]  snd_frames,
    output logic [7:0]  snd_slide,
    // FPGA-SIM keyboard/joystick ARE these ports (GUI KEYEVT / KEYBITS).
    // No PS/2 or I2C in this module. Board PHY is top_nexys_video only.
    // LED proofs: tools/pmod_input_test + tools/hid_led_blink — not this file.
    // Raw keyboard events for games (sim KEYEVT / board PS/2 decode)
    input  logic        sd_card_present = 1'b1,
    input  logic        key_evt_stb = 1'b0,
    input  logic [7:0]  key_evt_code = 8'd0,
    input  logic        key_evt_down = 1'b0,
    input logic [7:0] key_evt_char = 8'd0,
    input  logic        mouse_stb = 1'b0,
    input  logic [9:0]  mouse_x = 10'd320,
    input  logic [8:0]  mouse_y = 9'd240,
    input  logic [2:0]  mouse_buttons = 3'd0,
    output logic        mouse_ready,
    input logic desktop_control_stb = 1'b0,
    input logic desktop_control_on = 1'b1,
    output logic desktop_visible_o,
    output logic desktop_busy_o,
    output logic [8:0] desktop_count_o,
    output logic [8:0] desktop_selected_o,
    output logic [4:0] desktop_page_o,
    output logic [2:0] desktop_menu_o,
    output logic desktop_keyboard_mode_o,
    output logic [9:0] pointer_x_o,
    output logic [8:0] pointer_y_o,
    output logic pointer_toggle_o,
    output logic overlay_opaque_o,
    output logic [23:0] overlay_rgb_o,
    output logic system_menu_o,system_keyboard_o,system_about_o,system_shift_o,system_caps_o,system_ctrl_o,system_alt_o,
    output logic [6:0] system_pressed_o,
    output logic system_hold_o,
    output logic [69:0] system_held_o,
    output logic [31:0] system_generation_o,
    output logic [31:0] system_window_o,
    output logic [15:0] system_status_o,
    output logic system_viewport_o,
    output logic [8:0] game_source_y_o,
    output logic system_overlay_opaque_o,
    output logic [23:0] system_overlay_rgb_o,
    input  logic [9:0]  dump_addr,
    output logic [7:0]  dump_data,
    output logic [9:0]  cursor,
    output logic        ready_lit,
    input  logic [9:0]  scan_addr,
    output logic [7:0]  scan_data,
    // Mini-canvas scanout (game mode) — native 640×480
    output logic        game_mode,
    input  logic [18:0] fb_raddr, // Session-1: unused (scanout is DDR3-side)
    input  logic [9:0]  fb_x,
    input  logic [9:0]  fb_y,
    output logic [7:0]  fb_rdata,
    // Title palette readout (ASET 256×RGB888) — HDMI top + sim PAL? dump
    input  logic [7:0]  pal_raddr = 8'd0,
    output logic [23:0] pal_rdata,
    // ΜSD SPI (storage_engine owns the master)
    output logic        sd_sck,
    output logic        sd_mosi,
    input  logic        sd_miso,
    output logic        sd_cs_n,
    // FPGA-SIM JSHLOAD pulse (tied 0 on the board)
    input  logic        sim_vm_start = 1'b0,
    input logic [31:0] sim_image_code_bytes = 32'd0,
    input logic sim_image_code_valid = 1'b0,
    // FPGA-SIM FRAME — pulse one frame_tick when already in S_WAIT_FRAME
    input  logic        sim_frame_pulse = 1'b0,
    // PROG FT245 .JSH stream (HTML RUN). Sim leaves these at default 0.
    input  logic        jsb_tether_stb = 1'b0,
    input  logic [7:0]  jsb_tether_data = 8'd0,
    input  logic        jsb_tether_eof = 1'b0,
    input  logic        jsb_tether_src = 1'b0,
    input  logic        jsb_tether_big = 1'b0,   // 0xFB CART big put
    input  logic        jsb_tether_crc_err = 1'b0, // Trailer CRC mismatch (with eof)
    output logic        jsb_tether_rdy,
    // FPGA-SIM RAM LOAD — SOURCE poked by the host, LOAD skips FAT open
    input  logic        sim_src_bypass = 1'b0,
    input  logic [15:0] sim_src_lines = 16'd0,
    // Asset SRAM port when SRAM_INTERNAL=0 (board MIG). Sim leaves defaults.
    output logic        sram_ext_req,
    output logic        sram_ext_we,
    output logic [24:0] sram_ext_addr,
    output logic [15:0] sram_ext_wdata,
    input  logic [15:0] sram_ext_rdata = 16'd0,
    input  logic        sram_ext_ack = 1'b0,
    input logic host_req_valid=1'b0,
    input logic [183:0] host_req_body=184'd0,
    input logic host_req_crc_ok=1'b0,
    output logic host_req_ready,
    output logic host_q_valid,
    output logic [95:0] host_q_payload,
    input logic host_q_ready=1'b0,
    output logic tether_abort
);
    // Register the absolute report before menu hit testing and guest delivery.
    // One report per clock is retained; the USB/PS2 devices and wiring stay in
    // the board top. This separates FIFO read/clamp from the 100MHz UI logic.
    logic input_mouse_stb;
    logic [9:0] input_mouse_x;
    logic [8:0] input_mouse_y;
    logic [8:0] input_game_mouse_y;
    logic [2:0] input_mouse_buttons;
    logic [3:0] input_mouse_row;
    logic [7:0] input_key_hit;
    logic mouse_inflight;
    logic report_mouse_stb;
    logic [9:0] report_mouse_x;
    logic [8:0] report_mouse_y;
    logic [2:0] report_mouse_buttons;
    always_ff @(posedge clk)begin
        if(!rst_n)begin
            report_mouse_stb<=0;report_mouse_x<=320;report_mouse_y<=240;report_mouse_buttons<=0;
            input_mouse_stb<=0;input_mouse_x<=320;input_mouse_y<=240;input_game_mouse_y<=240;input_mouse_buttons<=0;input_mouse_row<=15;input_key_hit<=0;
        end
        else begin
            report_mouse_stb<=mouse_stb && mouse_ready;
            if(mouse_stb && mouse_ready)begin report_mouse_x<=mouse_x;report_mouse_y<=mouse_y;report_mouse_buttons<=mouse_buttons;end
            input_mouse_stb<=report_mouse_stb;
            if(report_mouse_stb)begin
                input_mouse_x<=report_mouse_x;input_mouse_y<=report_mouse_y;input_mouse_buttons<=report_mouse_buttons;
                input_game_mouse_y<=jmr_classic_ui_pkg::classic_game_y({1'b0,report_mouse_y});
                input_mouse_row<=jmr_classic_ui_pkg::classic_click_row(report_mouse_y);
                input_key_hit<=jmr_system_menu_pkg::system_key_hit(report_mouse_x,report_mouse_y);
            end
        end
    end

    logic kbd_empty, kbd_pop, kbd_clear;
    logic [7:0] kbd_q;
    logic video_busy;
    logic cls, put_en, print_nl;
    logic [7:0] put_char;
    logic run_pulse;
    logic vm_start;
    logic halt_pulse;
    logic demo_busy, demo_done;
    logic vm_busy, vm_done;
    always_ff @(posedge clk) begin
        if(!rst_n) begin pointer_x_o<=320;pointer_y_o<=240;pointer_toggle_o<=0;end
        else if(input_mouse_stb) begin
            pointer_x_o<=input_mouse_x>639?10'd639:input_mouse_x;
            pointer_y_o<=input_mouse_y>479?9'd479:input_mouse_y;
            pointer_toggle_o<=~pointer_toggle_o;
        end
    end
    jmr_mouse_overlay u_mouse_overlay (
        .x(fb_x),.y(fb_y),.mouse_x(pointer_x_o),.mouse_y(pointer_y_o),
        .watch(ui_pixels.window_state[7:0]==3),
        .ibeam(ui_pixels.dialog==2 && $signed({2'b0,pointer_x_o})>=12'sd154+$signed(pixel_sys_config[47:32]) && $signed({2'b0,pointer_x_o})<12'sd364+$signed(pixel_sys_config[47:32]) && $signed({3'b0,pointer_y_o})>=12'sd150+$signed(pixel_sys_config[63:48]) && $signed({3'b0,pointer_y_o})<12'sd172+$signed(pixel_sys_config[63:48])),
        .show_pointer(ui_pixels.window_state[7:0]!=10),.opaque(overlay_opaque_o),.rgb(overlay_rgb_o)
    );
    logic mouse_queue_ready, mouse_event_valid, mouse_event_pop;
    logic vm_key_evt_ready,vm_key_evt_taken;
    logic [47:0] mouse_event_data;
    // The system menu remains responsive even if a program stops draining
    // input. Normal reports use the event FIFO; an overloaded VM gets the
    // latest pending absolute position/button state after it catches up.
    logic mouse_pending;
    logic [9:0] pending_mouse_x;
    logic [8:0] pending_mouse_y;
    logic [2:0] pending_mouse_buttons;
    logic ui_consume,ui_quit,ui_key_stb,ui_key_down,ui_ascii_stb;
    logic [7:0] ui_key_code,ui_key_char,ui_ascii_data;
    logic ship_consume,ship_quit,ship_guest;
    logic docs_consume,docs_keys,docs_keyboard_stb,docs_keyboard_on,docs_command_stb,docs_after_valid;
    logic [7:0] classic_relay,docs_relay;
    logic [3:0] docs_command,docs_chosen_len,docs_after_action,docs_after_len,docs_name_len;
    logic [95:0] docs_chosen_name,docs_after_name;
    logic [2:0] docs_dialog;
    logic [8:0] docs_file_count,docs_selected;
    logic [7:0] docs_file_top,docs_message;
    logic docs_name_selected;
    logic [31:0] docs_generation,last_docs_generation;
    logic docs_catalog_active,docs_catalog_all;
    logic docs_label_valid,docs_label_ready;
    logic [5:0] docs_label_row;
    logic [26:0] docs_label_data;
    logic [5:0] docs_label_col;logic docs_label_commit;logic signed [11:0] classic_label_pos;logic [11:0] classic_label_glyph;
    // Keyboard boundary register. The PS/2 / Pmod / tether keyboards are
    // decoded in the board shell; their ASCII used to reach the Esc abort,
    // the scissor reset and the framebuffer write enable combinationally
    // across the chip. Every keyboard input (typed bytes and key events)
    // is delayed by the same one clock, so their mutual order is unchanged;
    // the Esc test is precomputed beside the byte.
    logic kbd_push_r,kbd_esc_r,key_evt_stb_r,key_evt_down_r;
    logic [7:0] kbd_data_r,key_evt_code_r,key_evt_char_r;
    always_ff @(posedge clk)begin
        if(!rst_n)begin kbd_push_r<=0;key_evt_stb_r<=0;end
        else begin kbd_push_r<=kbd_push;key_evt_stb_r<=key_evt_stb;end
        kbd_data_r<=kbd_data;kbd_esc_r<=kbd_data==8'h1B;
        key_evt_code_r<=key_evt_code;key_evt_down_r<=key_evt_down;key_evt_char_r<=key_evt_char;
    end
    wire owned_keys=docs_keys || classic_menu!=0 || system_about_o || system_menu_o;
    wire dialog_key_stb=ui_key_stb || key_evt_stb_r || kbd_push_r;
    wire [7:0] dialog_key_code=ui_key_stb?ui_key_code:key_evt_stb_r?key_evt_code_r:kbd_data_r;
    wire [7:0] dialog_key_char=ui_key_stb?ui_key_char:(key_evt_stb_r && key_evt_char_r!=0)?key_evt_char_r:
                              (kbd_push_r && kbd_data_r>=32 && kbd_data_r<127)?kbd_data_r:8'd0;
    wire dialog_key_down=ui_key_stb?ui_key_down:key_evt_stb_r?key_evt_down_r:1'b1;
    logic [2:0] con_system_role,con_system_stage;
    logic [127:0] con_source_name;
    logic [4:0] con_source_name_len;
    logic con_unnamed;
    logic classic_error_seen;wire classic_error_pulse=classic_error && !classic_error_seen;
    always_ff @(posedge clk)if(!rst_n || app_clear)classic_error_seen<=0;else if(classic_error)classic_error_seen<=1;
    logic classic_consume,classic_key_stb,classic_action_stb,classic_error,classic_about_valid,classic_title_valid;
    logic [7:0] classic_key_code;
    logic [3:0] classic_action,classic_menu,classic_popup_count,classic_popup_row;
    logic [9:0] classic_popup_left,classic_title_width;
    logic [7:0] classic_popup_static;
    logic [6:0] classic_popup_dynamic,classic_label_raddr;
    logic classic_popup_enabled,window_bars,classic_custom_title;
    import jmr_classic_ui_pkg::SYS_CONFIG_DEFAULT;
    logic sys_we;logic [13:0] sys_addr;logic [15:0] sys_data;
    logic toolbox_code_we;logic [12:0] toolbox_code_addr;logic [31:0] toolbox_code_data;
    logic sys_ready,pixel_sys_we;logic [13:0] pixel_sys_addr;logic [15:0] pixel_sys_data;
    jmr_resource_bridge u_resource_bridge(.clk(clk),.pixel_clk(pixel_clk),.rst_n(rst_n),
        .write_valid(sys_we),.write_addr(sys_addr),.write_data(sys_data),.ready(sys_ready),
        .pixel_valid(pixel_sys_we),.pixel_addr(pixel_sys_addr),.pixel_data(pixel_sys_data));
    // Fixed boot resources do not belong in the continuously copied UI state.
    always_ff @(posedge pixel_clk)begin
        if(!rst_n)pixel_sys_config<=SYS_CONFIG_DEFAULT;
        else if(pixel_sys_we && pixel_sys_addr>=4672 && pixel_sys_addr<4729)
            pixel_sys_config[(pixel_sys_addr-4672)*16+:16]<=pixel_sys_data;
    end
    logic [1:0] sys_status /*verilator public_flat_rd*/;
    logic [911:0] pixel_sys_config;
    logic [28:0] boot_ticks;
    logic boot_finished,boot_intro,boot_stage,boot_glass,last_boot_glass,last_boot_stage,vm_first_frame;
    (* ASYNC_REG="TRUE" *) logic [1:0] vm_first_sync;
    always_ff @(posedge clk)begin
        if(!rst_n)begin boot_ticks<=0;boot_finished<=0;boot_intro<=1;boot_stage<=0;vm_first_sync<=0;end
        else begin
            if(!boot_intro && app_window[7:0]==9 && vm_first_sync[1])boot_finished<=1;
            if(app_clear)vm_first_sync<=0;else vm_first_sync<={vm_first_sync[0],vm_first_frame};
            if(boot_intro)begin
                if(boot_ticks>=29'(BOOT_CLOCK_HZ/10*34) || kbd_push_r || (input_mouse_stb && input_mouse_buttons!=0) || sim_vm_start || desktop_control_stb)begin boot_intro<=0;boot_stage<=1;end
                else begin boot_ticks<=boot_ticks+1'b1;if(boot_ticks>=29'(BOOT_CLOCK_HZ/10*14))boot_stage<=1;end
            end
        end
    end
    assign boot_glass=!boot_finished && (boot_intro || (app_window[7:0]==9 && !vm_first_sync[1]) || shell_loading);
    logic docs_caret_on,docs_flash,ship_about_hot;
    logic [9:0] docs_caret_px;
    logic [1:0] docs_hot;
    logic [111:0] classic_static_rows;logic [97:0] classic_dynamic_rows;logic [13:0] classic_enabled_rows,classic_checked_rows;
    logic [9:0] classic_active_left,classic_active_right;logic [3:0] classic_hover_row;

    logic [31:0] ship_generation,classic_generation,app_window;
    logic [31:0] last_ship_generation,last_classic_generation,last_system_window;logic last_window_bars;
    logic vm_sysw_toggle,sysw_seen,vm_text_toggle,text_seen,vm_text_menu,vm_text_title,vm_text_first,vm_text_last;
    logic [3:0] vm_sysw_field;
    logic [31:0] vm_sysw_value,vm_text_byte;
    logic classic_vm_start,classic_restart_halt;
    wire app_clear=vm_start || sim_vm_start || classic_vm_start;
    // Which y map a mouse sample uses (game viewport vs desktop) follows the
    // window role through one register: the role is decoded from console,
    // snapshot and VM state across the chip. Role changes are program/launch
    // events; a pointer sample in the same 10 ns sees the previous mapping.
    logic pointer_game_q;
    always_ff @(posedge clk)begin
        if(!rst_n)pointer_game_q<=0;
        else pointer_game_q<=system_viewport_o && system_window_o[7:0]==8;
    end
    wire [8:0] pointer_source_y=pointer_game_q?input_game_mouse_y:input_mouse_y;
    function automatic logic [8:0] map_game_y(input logic [9:0] py);
        map_game_y=jmr_classic_ui_pkg::classic_game_y(py);
    endfunction
    always_comb begin
        system_status_o=0;system_status_o[2:0]=docs_dialog;system_status_o[3]=docs_catalog_active;
        system_status_o[4]=1'b0;system_status_o[5]=classic_error;system_status_o[9:6]=classic_menu;
    end
    assign game_source_y_o=map_game_y(fb_y);
    assign ui_consume=ship_consume || classic_consume || docs_consume;
    assign ui_quit=ship_quit;
    always_ff @(posedge clk)begin
        if(!rst_n || app_clear)begin app_window<=0;window_bars<=1;system_viewport_o<=0;sysw_seen<=0;text_seen<=vm_text_toggle;end
        else begin
            if(!vm_busy)begin app_window<=0;system_viewport_o<=0;end
            if(sysw_seen!=vm_sysw_toggle)begin
                sysw_seen<=vm_sysw_toggle;
                if(vm_sysw_field<4)app_window[vm_sysw_field*8+:8]<=vm_sysw_value[7:0];
                else if(vm_sysw_field==4)system_viewport_o<=vm_sysw_value!=0;
                else if(vm_sysw_field==9)window_bars<=vm_sysw_value!=0;
            end
            if(text_seen!=vm_text_toggle)text_seen<=vm_text_toggle;
        end
    end
    logic [7:0] held_role;
    always_ff @(posedge clk)begin
        if(!rst_n)held_role<=8'd9;
        else if(vm_busy && !desk_visible && con_system_role!=3)
            held_role<=(app_window[7:0]==0 && con_interactive)?{5'd0,con_system_role}:app_window[7:0];
    end
    always_comb begin
        system_window_o=app_window;
        if(!boot_finished && shell_loading && !vm_busy)system_window_o[7:0]=10;
        else if(desk_visible)system_window_o[7:0]=0;
        else if(con_system_role==3)begin system_window_o[7:0]=3;system_window_o[31:24]={1'b0,con_system_stage,4'd0};end
        // Between programs nothing is running. Keep the outgoing program's
        // window role over its retained picture; the monitor role (7) is only
        // for the read-only recovery display.
        else if(!vm_busy)system_window_o[7:0]=!shell_monitor_visible?held_role:8'd7;
        else if(app_window[7:0]==0 && con_interactive)system_window_o[7:0]={5'd0,con_system_role};
    end
    always_ff @(posedge clk)begin
        if(!rst_n)begin last_window_bars<=1;last_boot_glass<=1;last_boot_stage<=0;system_generation_o<=0;last_ship_generation<=0;last_classic_generation<=0;last_system_window<=0;last_docs_generation<=0;end
        else if(last_window_bars!=window_bars || last_boot_glass!=boot_glass || last_boot_stage!=boot_stage || (input_mouse_stb && (classic_menu!=0 || system_menu_o)) || last_ship_generation!=ship_generation || last_classic_generation!=classic_generation || last_system_window!=system_window_o || last_docs_generation!=docs_generation)begin
            last_window_bars<=window_bars;system_generation_o<=system_generation_o+1'b1;last_ship_generation<=ship_generation;
            last_boot_glass<=boot_glass;last_boot_stage<=boot_stage;last_classic_generation<=classic_generation;last_system_window<=system_window_o;last_docs_generation<=docs_generation;
        end
    end
    // Former document-controller restart requests have no producer.
    assign classic_vm_start=1'b0;
    assign classic_restart_halt=1'b0;
    // App lifecycle uses the raw Finder supervisor; menu/document policy is software.
    // One accepted sample owns the report/input pipeline and pending slot.
    // Do not acknowledge another producer sample before this one is consumed.
    assign mouse_ready = rst_n && !mouse_inflight;
    always_ff @(posedge clk)begin
        if(!rst_n)mouse_inflight<=0;
        else begin
            if(mouse_stb && mouse_ready)mouse_inflight<=1;
            if((input_mouse_stb && (!vm_busy || ui_consume || mouse_queue_ready)) ||
               (mouse_pending && (!vm_busy || mouse_queue_ready)))
                mouse_inflight<=0;
        end
    end
    always_ff @(posedge clk)begin
        if(!rst_n || !vm_busy)begin mouse_pending<=0;pending_mouse_x<=320;pending_mouse_y<=240;pending_mouse_buttons<=0;end
        else begin
            if(mouse_pending && mouse_queue_ready)mouse_pending<=0;
            if(input_mouse_stb && !ui_consume && (mouse_pending || !mouse_queue_ready))begin
                mouse_pending<=1;pending_mouse_x<=input_mouse_x;pending_mouse_y<=pointer_source_y;pending_mouse_buttons<=input_mouse_buttons;
            end
        end
    end
    jmr_system_menu u_system_menu (
        .clk(clk),.rst_n(rst_n),.sample_valid(input_mouse_stb && !classic_consume && !docs_consume),.x(input_mouse_x),.y(input_mouse_y),.buttons(input_mouse_buttons),
        .key_hit(input_key_hit),
        .emit_enable(owned_keys ? 1'b1 : vm_busy ? (vm_key_evt_ready && !vm_kev_lat) : (!desk_busy && !disk_busy && !kbd_clear && ready_lit && !stor_busy)),
        .force_keyboard_stb(docs_keyboard_stb),.force_keyboard_on(docs_keyboard_on),
        .dismiss_about(system_about_o && dialog_key_stb && dialog_key_down && (dialog_key_code==13 || dialog_key_code==27)),
        .dismiss_menu(system_menu_o && dialog_key_stb && dialog_key_down && dialog_key_code==27),
        .inject_stb(classic_key_stb),.inject_code(classic_key_code),.leave_app(ui_quit || classic_restart_halt || classic_error_pulse),.guest_drag_o(ship_guest),
        .about_hot(ship_about_hot),.finder_mode(1'b0),.tool_stb(),.tool_action(),
        .consume_pointer(ship_consume),.menu_open(system_menu_o),.keyboard_open(system_keyboard_o),.about_open(system_about_o),
        .shift_on(system_shift_o),.caps_on(system_caps_o),.ctrl_on(system_ctrl_o),.alt_on(system_alt_o),
        .pressed_index(system_pressed_o),.hold_keys(system_hold_o),.held_keys(system_held_o),.generation(ship_generation),.quit_pulse(ship_quit),
        .key_stb(ui_key_stb),.key_down(ui_key_down),.key_code_o(ui_key_code),.key_char_o(ui_key_char),
        .ascii_stb(ui_ascii_stb),.ascii_data(ui_ascii_data)
    );
    logic ship_op,ship_op_q,classic_op,classic_modal;
    logic [23:0] ship_rgb,ship_rgb_q,classic_rgb;
    // Clean architecture: menus and document dialogs execute from TOOLBOX.ROM.
    // Their former control/label hardware is absent; raw file/document services remain.
    assign {docs_caret_on,docs_flash,docs_hot,docs_caret_px,docs_consume,docs_keys,
      docs_keyboard_stb,docs_keyboard_on,docs_command_stb,docs_command,
      docs_chosen_name,docs_chosen_len,docs_after_valid,docs_after_action,
      docs_after_name,docs_after_len,docs_dialog,docs_file_count,docs_selected,
      docs_file_top,docs_name_len,docs_name_selected,docs_message,docs_generation,
      docs_catalog_active,docs_catalog_all,
      docs_label_valid,docs_label_row,docs_label_data,docs_label_col,docs_label_commit,docs_relay}='0;
    assign {classic_consume,classic_key_stb,classic_key_code,classic_action_stb,
      classic_action,classic_generation,classic_error,classic_menu,classic_popup_left,
      classic_popup_count,classic_popup_row,classic_popup_static,classic_popup_dynamic,
      classic_popup_enabled,classic_active_left,classic_active_right,classic_hover_row,
      classic_checked_rows,classic_static_rows,classic_dynamic_rows,classic_enabled_rows,
      classic_label_glyph,classic_about_valid,classic_title_valid,classic_title_width,
      classic_custom_title,classic_relay}='0;
    assign docs_label_ready=1'b1;
    typedef struct packed {
        logic [31:0] window_state;
        logic [3:0] menu,count;
        logic [9:0] left_edge,title_width;
        logic [111:0] static_rows;logic [97:0] dynamic_rows;logic [13:0] enabled_rows,checked_rows;
        logic [9:0] active_left,active_right;logic [3:0] hover_row;
        logic about_open,about_valid,title_valid,custom_title,window_bars;
        logic [2:0] dialog;
        logic [8:0] files,selected;
        logic [7:0] file_top,message_id;
        logic [3:0] name_len;logic name_selected;
        logic caret_on,flash_default,about_hot;logic [9:0] caret_px;logic [1:0] hot_button;
        logic [2:0] ship_hover;
        logic ship_menu,keyboard,shift_on,caps_on,ctrl_on,alt_on,hold_keys;
        logic [6:0] pressed;logic [69:0] held;
    } ui_snapshot_t;
    ui_snapshot_t ui_source,ui_pixels;
    always_comb begin
        ui_source.window_state=system_window_o;
        if(boot_glass)begin ui_source.window_state=32'd10;ui_source.window_state[24]=boot_stage;end ui_source.menu=classic_menu;ui_source.count=classic_popup_count;
        ui_source.left_edge=classic_popup_left;ui_source.title_width=classic_title_width;
        ui_source.static_rows=classic_static_rows;ui_source.dynamic_rows=classic_dynamic_rows;ui_source.enabled_rows=classic_enabled_rows;
        ui_source.active_left=classic_active_left;ui_source.active_right=classic_active_right;ui_source.hover_row=classic_hover_row;ui_source.checked_rows=classic_checked_rows;
        ui_source.about_open=system_about_o;ui_source.about_valid=classic_about_valid && vm_busy && system_window_o[7:0]!=0 && system_window_o[7:0]!=3;
        ui_source.custom_title=classic_custom_title;ui_source.window_bars=window_bars;ui_source.title_valid=classic_title_valid;ui_source.dialog=docs_dialog;ui_source.files=docs_file_count;ui_source.selected=docs_selected;
        ui_source.caret_on=docs_caret_on;ui_source.caret_px=docs_caret_px;ui_source.flash_default=docs_flash;ui_source.hot_button=docs_hot;ui_source.about_hot=ship_about_hot;
        ui_source.file_top=docs_file_top;ui_source.message_id=docs_message;ui_source.name_len=docs_name_len;ui_source.name_selected=docs_name_selected;
        ui_source.ship_hover=(input_mouse_x<190 && input_mouse_y>=26 && input_mouse_y<68)?3'(1+(input_mouse_y-26)/21):3'd0;
        ui_source.ship_menu=system_menu_o;ui_source.keyboard=system_keyboard_o;ui_source.shift_on=system_shift_o;ui_source.caps_on=system_caps_o;
        ui_source.ctrl_on=system_ctrl_o;ui_source.alt_on=system_alt_o;ui_source.hold_keys=system_hold_o;ui_source.pressed=system_pressed_o;ui_source.held=system_held_o;
    end
    jmr_ui_snapshot #(.WIDTH($bits(ui_snapshot_t))) u_ui_snapshot(.clk(clk),.rst_n(rst_n),.pixel_clk(pixel_clk),.source(ui_source),.pixels(ui_pixels));
    jmr_classic_overlay u_classic_overlay (
        .clk(pixel_clk),.sys_we(pixel_sys_we),.sys_addr(pixel_sys_addr),.sys_data(pixel_sys_data),.sys_config(pixel_sys_config),
        .rst_n(rst_n),
        .pixel_clk(pixel_clk),.x(fb_x),.y(fb_y),.window_state(ui_pixels.window_state[7:0]==10?ui_pixels.window_state:ui_pixels.window_state[7:0]==7?32'd7:32'd0),
        .active_menu(ui_pixels.menu),.popup_count(ui_pixels.count),.popup_left(ui_pixels.left_edge),.popup_row(classic_popup_row),
        .active_left(ui_pixels.active_left),.active_right(ui_pixels.active_right),.hover_row(ui_pixels.hover_row),.popup_checked_rows(ui_pixels.checked_rows),
        .popup_static_rows(ui_pixels.static_rows),.popup_dynamic_rows(ui_pixels.dynamic_rows),.popup_enabled_rows(ui_pixels.enabled_rows),
        .about_open(ui_pixels.about_open),.about_valid(ui_pixels.about_valid),.title_valid(ui_pixels.title_valid),.title_width(ui_pixels.title_width),.custom_title(ui_pixels.custom_title),.window_bars(ui_pixels.window_bars),
        .dialog(ui_pixels.dialog),.file_count(ui_pixels.files),.selected(ui_pixels.selected),.file_top(ui_pixels.file_top),.message_id(ui_pixels.message_id),
        .caret_on(ui_pixels.caret_on),.caret_px(ui_pixels.caret_px),.flash_default(ui_pixels.flash_default),.hot_button(ui_pixels.hot_button),.about_hot(ui_pixels.about_hot),
        .name_len(ui_pixels.name_len),.name_selected(ui_pixels.name_selected),.label_raddr(classic_label_raddr),.label_pos(classic_label_pos),.label_glyph(classic_label_glyph),
        .opaque(classic_op),.modal_opaque(classic_modal),.rgb(classic_rgb)
    );
    jmr_system_overlay u_system_overlay (
        .clk(pixel_clk),.sys_we(pixel_sys_we),.sys_addr(pixel_sys_addr),.sys_data(pixel_sys_data),
        .pixel_clk(pixel_clk),.x(fb_x),.y(fb_y),
        .finder_mode(1'b0),.hover_row(ui_pixels.ship_hover),.menu_open(ui_pixels.ship_menu),.keyboard_open(ui_pixels.keyboard),.about_open(1'b0),.shift_on(ui_pixels.shift_on),.caps_on(ui_pixels.caps_on),
        .ctrl_on(ui_pixels.ctrl_on),.alt_on(ui_pixels.alt_on),.pressed_index(ui_pixels.pressed),.hold_keys(ui_pixels.hold_keys),.held_keys(ui_pixels.held),
        .opaque(ship_op),.rgb(ship_rgb)
    );
    always_ff @(posedge pixel_clk)begin ship_op_q<=ship_op;ship_rgb_q<=ship_rgb;end
    assign system_overlay_opaque_o=classic_modal || ship_op_q || classic_op;
    assign system_overlay_rgb_o=ui_pixels.window_state[7:0]==10?classic_rgb:classic_modal?classic_rgb:ship_op_q?ship_rgb_q:classic_rgb;
    jmr_mouse_events u_mouse_events (
        .clk(clk), .rst_n(rst_n && vm_busy),
        .sample_valid(vm_busy && (mouse_pending || (input_mouse_stb && !ui_consume))), .sample_ready(mouse_queue_ready),
        .sample_x(mouse_pending?pending_mouse_x:input_mouse_x),.sample_y(mouse_pending?pending_mouse_y:pointer_source_y),
        .sample_buttons(mouse_pending?pending_mouse_buttons:input_mouse_buttons),
        .event_valid(mouse_event_valid), .event_data(mouse_event_data),
        .event_pop(mouse_event_pop)
    );
    logic fb_we /*verilator public_flat_rd*/; logic fb_swap, demo_fb_we, demo_fb_swap, vm_fb_we, vm_fb_swap;
    logic [18:0] fb_waddr, demo_fb_waddr, vm_fb_waddr;
    logic [7:0]  fb_wdata, demo_fb_wdata, vm_fb_wdata;
    logic frame_tick;
    localparam int FRAME_COUNT_W = (FRAME_DIV < 1) ? 1 : $clog2(FRAME_DIV + 1);
    logic [FRAME_COUNT_W-1:0] frame_div /*verilator public_flat_rw*/;
    // Console loads .JSB into VM code BRAM
    logic [31:0] cons_image_code_bytes,vm_image_code_bytes;
    logic cons_image_code_valid,vm_image_code_valid;
    logic        code_we /*verilator public_flat_rd*/;
    logic [15:0]  code_waddr /*verilator public_flat_rd*/;
    logic [31:0] code_wdata /*verilator public_flat_rd*/;
    logic stor_get_byte;
    logic [7:0]  stor_get_data;
    // 8 MiB external asset SRAM (jmr_sram_port) — console writes the ASET
    // payload during RUN load; the VM blitter reads sprite pixels while running.
    // The two masters never overlap (load completes before vm_start).
    logic [6:0]  stor_dbg_state;
    logic [15:0] stor_dbg_op_clk;
    logic [17:0] vm_src_setlen;
    logic        vm_src_setlen_stb;
    logic        cons_sram_req, cons_sram_we, vm_sram_req, vm_sram_we;
    logic [24:0] cons_sram_addr, vm_sram_addr;
    logic [15:0] cons_sram_wdata, vm_sram_wdata, sram_rdata;
    logic        sram_ack, sram_req, sram_we;
    logic [24:0] sram_addr;
    logic [15:0] sram_wdata;
    // ASET palette load (console) → palette BRAM (read by scanout/dump)
    logic        pal_we;
    logic [7:0]  pal_waddr;
    logic [23:0] pal_wdata;
    // VM getImageData reads the back bank (PYTHON canvas.back twin)
    logic [18:0] vm_dump_addr;
    logic        vm_dump_sel; // unused since build 96: no tether address to arbitrate
    logic [7:0]  dump_back_rdata;
    logic [7:0]  dump_fb_rdata;  // u_fb Port-A byte (Toolbox / VM getImageData)

    // Held request/reply bundles: only flags cross synchronizers. Arguments
    // remain stable from VM request until acknowledgement is withdrawn.
    logic vm_fs_req,fs_reply,fs_busy,fs_launch;
    logic file_fs_busy,file_fs_reply,tb_busy,tb_reply;
    logic [31:0] file_fs_result,tb_result;
    logic tb_sram_req,tb_sram_we;logic [24:0] tb_sram_addr;logic [15:0] tb_sram_data;
    logic fb_raw_we;
    logic [9:0] vm_fb_x,vm_fb_y,rast_fb_x,rast_fb_y,tb_fb_x,tb_fb_y;
    logic clip_enabled,clip_reset;
    logic [9:0] clip_x0,clip_y0,clip_x1,clip_y1;
    logic tb_fb_we;logic [18:0] tb_fb_addr;logic [7:0] tb_fb_data;
    logic tb_fb_req,tb_fb_ack;logic [18:0] tb_fb_raddr;
    // Port A is synchronous and write-priority. Acknowledge only a granted
    // read; its data is valid on the following service clock. Port B remains
    // dedicated to presentation, so scanout/present are not borrowed.
    always_ff @(posedge clk)begin
        if(!rst_n)tb_fb_ack<=0;
        else tb_fb_ack<=tb_fb_req && !fb_raw_we;
    end
    assign fs_busy=file_fs_busy||tb_busy;
    assign fs_reply=file_fs_reply||tb_reply;
    assign fs_result=vm_fs_cmd==7?tb_result:file_fs_result;

    logic [2:0] vm_fs_cmd;
    logic [127:0] vm_fs_args;
    logic [31:0] fs_result;
    (* ASYNC_REG="TRUE" *) logic [1:0] fs_req_sync;
    always_ff @(posedge clk)begin if(!rst_n)fs_req_sync<=0;else fs_req_sync<={fs_req_sync[0],vm_fs_req};end
    logic [95:0] fs_launch_name;logic [3:0] fs_launch_len,fs_launch_how;
    logic fs_open,fs_close,fs_dir,fs_next,fs_get,fs_put,fs_delete,fs_rename;
    logic [7:0] fs_mode,fs_name_len,fs_put_data;logic [15:0] fs_name_addr;
    logic fs_mem_en,fs_mem_we;logic [15:0] fs_mem_addr;logic [7:0] fs_mem_data;
    logic fs_sram_req,fs_sram_we;logic [24:0] fs_sram_addr;logic [15:0] fs_sram_data;
    logic stor_missing;logic [15:0] stor_date;logic [7:0] stor_attr;
    logic shell_request,shell_accepted,shell_loading,shell_monitor_visible;
    logic shell_dismiss_failure;
    logic host_hold,host_started,host_started_finder,host_receive_request,host_receive_pending;
    // The launch pulse from the Finder file service is combined with the
    // loader's receive-pending decode. Used combinationally, that made a path
    // out of the loader, through this logic, and back into the loader's state
    // register (30 logic levels). Register the four products together: every
    // launch consequence happens one clock later, in the same relative order.
    // The launch name/length/kind are held by the file service, so they are
    // still valid on that clock.
    logic launch_shell_q,launch_park_q,launch_forget_q,launch_yield_q;
    always_ff @(posedge clk)begin
        if(!rst_n)begin launch_shell_q<=0;launch_park_q<=0;launch_forget_q<=0;launch_yield_q<=0;end
        else begin
            launch_shell_q<=fs_launch && !host_receive_pending;
            launch_park_q<=fs_launch && (fs_launch_how!=8 || host_receive_pending) && app_window[7:0]==9;
            // Only Finder restarting itself discards the parked Finder.
            launch_forget_q<=fs_launch && fs_launch_how==8 && !host_receive_pending && app_window[7:0]==9;
            launch_yield_q<=fs_launch && fs_launch_how==8 && host_receive_pending;
        end
    end
    wire host_receive_taken=host_receive_request && vm_busy && vm_key_evt_ready && !vm_kev_lat && !key_evt_stb_r && !ui_key_stb;
    logic [95:0] shell_name;
    logic [3:0] shell_len,shell_how;
    logic gui_sram_req,gui_sram_we;logic [24:0] gui_sram_addr;logic [15:0] gui_sram_data;
    assign gui_sram_req=tb_busy?tb_sram_req:file_fs_busy?fs_sram_req:desk_sram_req;
    assign gui_sram_we=tb_busy?tb_sram_we:file_fs_busy?fs_sram_we:desk_sram_we;
    assign gui_sram_addr=tb_busy?tb_sram_addr:file_fs_busy?fs_sram_addr:desk_sram_addr;
    assign gui_sram_data=tb_busy?tb_sram_data:file_fs_busy?fs_sram_data:desk_sram_data;

    // Console ↔ storage
    logic        stor_open, stor_close, stor_readline, stor_putc;
    logic        stor_dir, stor_dir_next, stor_dir_all, stor_delete;
    logic [7:0]  stor_mode, stor_chan, stor_name_len, stor_putc_data;
    logic [15:0] stor_name_addr;
    logic        stor_busy, stor_done, stor_err, stor_eof;
    logic [7:0]  stor_line_len;

    logic desk_visible, desk_busy, desk_key_push;
    logic [7:0] desk_key_data;
    logic disk_busy;
    logic disk_error /* verilator public_flat_rd */;
    logic [8:0] desk_count;
    logic desk_fb_we,desk_fb_swap;
    logic [18:0] desk_fb_addr;
    logic [7:0] desk_fb_data;
    logic desk_sram_req,desk_sram_we;
    logic [24:0] desk_sram_addr;
    logic [15:0] desk_sram_data;
    logic desk_stor_open,desk_stor_close,desk_stor_dir,desk_stor_next,desk_stor_get;
    logic [7:0] desk_stor_name_len;
    logic [31:0] stor_file_size,stor_dir_size;
    logic desk_mem_en,desk_mem_we;
    logic [15:0] desk_mem_addr;
    logic [7:0] desk_mem_wdata;
    logic con_mem_en,con_mem_we;
    logic [15:0] con_mem_addr;
    logic [7:0] con_mem_wdata;
    logic con_stor_open,con_stor_close,con_stor_readline,con_stor_get_byte;
    logic con_stor_putc,con_stor_dir,con_stor_dir_next,con_stor_dir_all,con_stor_delete;
    logic [7:0] con_stor_mode,con_stor_chan,con_stor_name_len,con_stor_putc_data;
    logic [15:0] con_stor_name_addr;
    logic con_command_failed;
    logic [4:0] con_fail_reason;
    logic [7:0] shell_exit_status;
    logic fs_status_read;
    logic con_interactive;
    logic desk_hidden;
    // Esc. A program that sets bit 7 of ctx.windowDirty (every Toolbox
    // session except a game) gets Esc as an ordinary key, so a dialog or menu
    // can cancel and Quit can ask about unsaved changes. Such an Esc does not
    // reach the keyboard feed, so it stops nothing. Each such Esc counts as
    // unanswered until the program's listeners finish a key event. With two
    // unanswered, the next Esc stops the program as before: a hung program,
    // or Esc typed on a link that sends no key event, can always be left.
    logic [1:0] esc_unanswered;
    logic vm_key_taken_q;
    wire esc_to_app=app_window[31] && !esc_unanswered[1];
    wire esc_typed=((kbd_push_r && kbd_esc_r) || (ui_ascii_stb && ui_ascii_data==8'h1B)) && !owned_keys;
    always_ff @(posedge clk)begin
        vm_key_taken_q<=vm_key_evt_taken;
        if(!rst_n || !vm_busy || app_clear)esc_unanswered<=0;
        else if(esc_typed && esc_to_app)esc_unanswered<=esc_unanswered+2'd1;
        else if(vm_key_taken_q)esc_unanswered<=0;
    end
    wire keyboard_feed_push=(kbd_push_r && !owned_keys && !(esc_to_app && kbd_esc_r))||desk_key_push||
        (ui_ascii_stb && !owned_keys && !(esc_to_app && ui_ascii_data==8'h1B))||ui_quit;
    wire [7:0] keyboard_feed_data=ui_quit?8'd27:desk_key_push?desk_key_data:ui_ascii_stb?ui_ascii_data:kbd_data_r;
    // keyboard_feed_data==27, selected per source (no compare after the mux).
    wire keyboard_feed_esc=ui_quit || (desk_key_push?desk_key_data==8'h1B:ui_ascii_stb?ui_ascii_data==8'h1B:kbd_esc_r);
    assign desktop_visible_o=desk_visible;
    assign desktop_busy_o=desk_busy;
    assign desktop_count_o=desk_count;
    assign stor_open=fs_busy?fs_open:disk_busy?desk_stor_open:con_stor_open;
    assign stor_close=fs_busy?fs_close:disk_busy?desk_stor_close:con_stor_close;
    assign stor_dir=fs_busy?fs_dir:disk_busy?desk_stor_dir:con_stor_dir;
    assign stor_dir_next=fs_busy?fs_next:disk_busy?desk_stor_next:con_stor_dir_next;
    assign stor_get_byte=fs_busy?fs_get:disk_busy?desk_stor_get:con_stor_get_byte;
    assign stor_readline=!fs_busy&&!disk_busy&&con_stor_readline;
    assign stor_putc=fs_busy?fs_put:!disk_busy&&con_stor_putc;
    assign stor_delete=fs_busy?fs_delete:!disk_busy&&con_stor_delete;
    assign stor_dir_all=fs_busy?1'b1:disk_busy?(docs_catalog_active?docs_catalog_all:desk_hidden):con_stor_dir_all;
    assign stor_mode=fs_busy?fs_mode:disk_busy?8'h49:con_stor_mode;
    assign stor_chan=fs_busy?8'd1:disk_busy?8'd1:con_stor_chan;
    assign stor_name_addr=fs_busy?fs_name_addr:disk_busy?16'hb850:con_stor_name_addr;
    assign stor_name_len=fs_busy?fs_name_len:disk_busy?desk_stor_name_len:con_stor_name_len;
    assign stor_putc_data=fs_busy?fs_put_data:con_stor_putc_data;
    assign c_mem_en=fs_busy?fs_mem_en:disk_busy?desk_mem_en:con_mem_en;
    assign c_mem_we=fs_busy?fs_mem_we:disk_busy?desk_mem_we:con_mem_we;
    assign c_mem_addr=fs_busy?fs_mem_addr:disk_busy?desk_mem_addr:con_mem_addr;
    assign c_mem_wdata=fs_busy?fs_mem_data:disk_busy?desk_mem_wdata:con_mem_wdata;
    // Mem masters
    logic        c_mem_en, c_mem_we, c_mem_gnt;
    logic [15:0] c_mem_addr;
    logic [7:0]  c_mem_wdata, c_mem_rdata;
    logic        s_mem_en, s_mem_we, s_mem_gnt;
    logic [15:0] s_mem_addr;
    logic [7:0]  s_mem_wdata, s_mem_rdata;

    assign joy_out = joy_in;
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
