jmrothberg/JMR-JS-CSS-FPGA-COMPUTER/(commit log)

2026-08-16 signicant progress on FPGA-SIM and donkey bug
    [sim_main.cpp]
2026-08-17 fixes invader not pacman
    [gui_jmr_js.py, jmr_js_vm_exec64.sv, js_vm.py, sim_backend.py]
2026-08-19 bug edits, document on vivado flatten
    [jmr_js_vm_exec64.sv, jmr_js_vm_pkg.sv, sim_backend.py, sim_main.cpp]
2026-08-19 cleanup tests, potential bug list
    [jmr_js_vm_exec64.sv, sim_main.cpp]
2026-08-20 fable claims bug free
    [jmr_js_vm_exec64.sv, jmr_js_vm_pkg.sv, sim_backend.py, sim_main.cpp]
2026-08-20 minor bugs still but working super slow games
    [jmr_js_vm_exec64.sv, sim_main.cpp]
2026-08-21 docs: add core zoom-in poster re-render prompt
    The core zoom-in poster (docs/jmr_js_core_zoom_in.png) was rendered
    2026-08-18 and has drifted: it still shows the exec32 | exec64 mux on
    flags[3], and its fine print predates the native id table growing to 41.
    Add docs/POSTER_PROMPT_CORE_ZOOM_IN.md — a copy-pasteable image-generation
    prompt that reproduces the poster block by block with every string spelled
    out, folding in the ARCHITECTURE.md errata plus the drift found since the
    render. Every figure in it was read out of the tree (jmr_js_vm_pkg.sv,
    jmr_value.sv, jmr_js_core.sv, top_nexys_video.sv, jmr_i2c_joy.sv,
    jsb_format.py), not copied from the old image.
    Newly corrected beyond the exi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
2026-08-21 docs: add Architecture V1 poster re-render prompt
    Sibling to the core zoom-in prompt. docs/jmr_js_architecture_v1.png has
    drifted further than its errata list records: it still tells the .JSH story
    in five separate places, and .JSH no longer exists anywhere. RUN compiles to
    an ephemeral in-memory ProgramImage and nothing generated is ever written
    back to the card.
    Add docs/POSTER_PROMPT_ARCHITECTURE_V1.md — a copy-pasteable
    image-generation prompt reproducing the poster panel by panel with every
    string spelled out, folding in all eight ARCHITECTURE.md errata bullets plus
    the drift found since the render. Sizes and the board clock were read out of
    the tree (jmr_console_engine.sv, jmr_js_vm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
2026-08-21 docs: add ASIC board Rev A poster re-render prompt
    Third and last of the poster prompts. Adds
    docs/POSTER_PROMPT_ASIC_BOARD_REV_A.md, folding in all seven errata bullets
    plus the drift since the render, with the pin budget spelled out row by row
    so a reader can check that it sums to 100.
    The existing errata for this poster had itself gone stale: it said to
    respell BOARD NOTES ".JSlf" as ".JSH". That predates the compile-cache
    removal — the line must be deleted, not respelled, because there is no
    .JSH/.JSB and nothing is ever written back to the card. Fixed in the errata
    and reflected in the prompt.
    Also newly recorded:
    - SYSTEM RULES should carry the dispatch rule (one decoder, exec64)
    -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
2026-08-21 docs: ASIC Rev A joystick is I2C, not a 6-pin GPIO header
    Per user decision 2026-08-21: the machine uses I2C for the stick and will
    keep doing so, on the ASIC as well as the FPGA prototype. The Rev A poster's
    6-pin GPIO header was the last place the two boards diverged.
    Prompt and errata now specify a Mini I2C gamepad @ 0x5A on JOY_SCL /
    JOY_SDA, driven by the same jmr_i2c_joy master the FPGA prototype runs:
    - J7 becomes a 4-pin PH2.0 header (G / V / SDA / SCL) matching the labels
    printed on the stick, with board-side 4.7 kOhm pull-ups (R6 / R7) since
    I2C is open-drain and the chip never drives either line high
    - PIN SUMMARY row "Joystick (GPIO)" / GP[5:0] / 6 becomes
    "Joystick (I2C)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
2026-08-21 docs: install the 2026-08-21 poster renders, rewrite the errata
    Replaces all three docs/*.png with the new renders and rewrites the errata
    sections against what actually came back, rather than carrying the old lists
    forward.
    Cleared:
    - core zoom-in: no known errata. exec64, the nine Value64 kinds under 0x7FF9,
    ids 0-41, parent-SRAM VARS/CONSTS, optional EDIT, the OP_CALL annotation,
    the I2C gamepad and the MIG ui_clk clock are all correct.
    - Architecture V1: .JSH, rge, IAF, the extra map zeros, "Never never",
    NAME.DAT, the jammed "microcode ROM FIFOs", the "SRA M" title, the GPIO
    joystick and the five-verb console are all fixed.
    - ASIC board: frozen-vs-proposed banner, "(Indicative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
2026-08-21 docs: install ASIC poster render 2026-08-21b, update errata
    Four of the five open items are fixed in this render: the 4M x 20 / 2M x 16
    contradiction in SYSTEM RULES §4, the duplicate U1 buck regulator, the
    pin-ring caption (now disclaims names as well as numbers), and the video
    note's colour qualifier.
    Still open, now recorded in the errata:
    - J8 is still drawn as a plain vertical rectangle instead of the HDMI
    Type-A trapezoid; the label itself is correct
    - regression: the pin-budget running-sum caption lost a "+" and prints
    "... + 2 + 2 3 + 3 = 76 signal". The totals and the PIN SUMMARY table are
    both correct; only the caption is mangled
    - regression: a spurious third bus label "DQ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
2026-08-21 Architecture Monitor: replay real execution, peek live memory
    The monitor sampled the VM only between frames, and between frames the VM
    is always parked at the same requestAnimationFrame return: 30 consecutive
    samples during play returned the identical IP. It was not slow, it was
    frozen on one instruction while millions of ops executed.
    Both runtimes now record the IPs they actually execute and the monitor
    replays them, so the sequencer, dispatch and source line follow real code
    at full speed — no stepping, no gating the machine. FPGA-SIM arms IPTRACE
    before each frame; PYTHON samples its value64 loop every 251st op. The
    period is prime on purpose: 256 aliased against loop bodies and pinn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
2026-08-22 refactor after synth too big
    [jmr_mini_fb.sv, sim_main.cpp]
2026-08-23 T200 fit campaign: 1.9M -> 207.7k LUTs, LUTRAM under cap, all games play
    Snapshot of the fully-verified netlist state (runs 4-14, 2026-08-22/23):
    - 207,725 LUTs total (164,401 logic + 43,324 LUTRAM), 32,118 FFs,
    BRAM 365/365, DRC gate: requires 165,989 LUT-as-Logic vs 134,600.
    - Places as-is on Kintex-7 325T or larger (see docs/BIGGER_PART.md).
    - Every array evacuation, capacity shrink, SRAM migration, and the
    exec64 class-table removal documented in OVERNIGHT_STATUS.md.
    - Suite: 150/150 RTL (5 consecutive clean full runs), 198/198 bytecode,
    PACMAN/INVADERS/DONKEY fault-free in FPGA-SIM.
2026-08-23 deep-window test scaffolding + place-experiment constraints
    4 RTL tests pin operand-stack depths 9-16 (the silent-clamp zone any
    vst_win shrink would threaten); all pass on the current tree. XDC gains
    the rgb2dvi CLOCK_DEDICATED_ROUTE override the IO clock placer asked
    for; build tcl demotes UTLZ-1 so placement attempts LUT packing.
2026-08-23 V1-surface cut + one-hot parent FSM (user directive)
    Verified zero wall-name hits across all nine compilable titles first.
    Findings: the V1 surface was mostly never in silicon — no Math trig/pow
    natives exist (IDs end at 41; the sin ROM is ctx.arc's, which PACMAN
    uses, KEPT), no string-method arms exist for the removal list, and of
    the whole list only id_findindex and the never-emitted OP_RETURN arm
    had RTL. Both removed: findIndex via the FFFF id tie-off (guards
    constant-fold), OP_RETURN falls to the fault-5 default.
    Compiler V1 wall fires at METHOD-CALL position only (identifier and
    data-property uses of the same words stay legal — 'values' as a var
    name broke two tests under the blun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
    [jmr_js_vm_exec64.sv]
2026-08-23 run-17 verdict: V1 cut + one-hot flat; 2-session fit plan
2026-08-23 relax experiment: zero delta (XDC never applied at synth); census corrects Session-2 ranking
    [nexys_video.xdc]
2026-08-23 Session 1: FB front bank -> DDR3, single persistent draw bank, BRAM reshuffle
    - jmr_mini_fb: ONE bank (75 tiles, was 150). Canvas persistence is now
    free — the draw bank never flips, so S_FB_SYNC's 307k-cycle copy-back
    is GONE (state reused as the present-wait).
    - jmr_fb_present (new): swap pulse -> stream bank to DDR3 front image
    (FB_SRAM_BASE=1480704, 2px/word), swap_pend queues explicit swaps.
    - jmr_fb_scanout (new): DDR3 line prefetch + 2-line ping-pong BRAM,
    gray-coded beam-line CDC; pixel side keeps the 1-beat read contract.
    - Arbiter: 5 channels, owner-latched; scanout prefetch TOP priority.
    - Freed tiles spent: vstack, name_mem, json_mem, vconsts, protos,
    vfn_env/bound_th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
    [jmr_fb_present.sv, jmr_fb_scanout.sv, jmr_js_core.sv, jmr_mini_fb.sv, jmr_text_hdmi_scanout.sv, sim_main.cpp, top_nexys_video.sv]
2026-08-23 per-arm sizing table + switchable V1 wall extension (JSON-only line recommended)
2026-08-23 JSON engine removal (gated, gates passed) + bug #81 found and documented
    Gates: PACMAN2/INVADERS2 compiled JSON-free and byte-identical to the
    originals over the compared frames; wall live by default (parse/
    stringify at call position; JMR_V1_ALLOW_JSON=1 archival escape);
    shipping titles swapped to the 2-variants under original filenames
    (originals in storage/*.V2ORIG). The INVADERS stub option died on
    line 113 (JSON.stringify on leaderboard SAVE) — INVADERS2 required.
    Removal: the four JSON states (S_JSON/S_JSON_PARSE/S_V64_JSON/
    S_V64_JSON_PARSE) are fault-5 arms; the ~18.3k-LUT parse/stringify
    datapath is writerless and sweeps. json_mem + json_rp/wp/putc STAY
    (REPL/IDXSTR/TXT dynstr p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
2026-08-23 run-20 verdict: 161,924 — JSON removal -19.4k; listeners are the closer
2026-08-23 Listener consolidation: single parent table, sequential add/remove (census ~26.9k)
    exec64's four table copies (ev/fn/nev/nfn), both 16-way one-beat scans,
    the repl double-buffer, and the parent's #77 compaction mirror are all
    GONE. Add/remove are lsv requests: exec holds (cm pattern, level held
    by default — the toggle lesson applied), the parent walks its SINGLE
    table sequentially via the existing registered rdata ports (2 beats per
    entry, in-place compact for remove), result is a held level.
    One real bug found and fixed in flight: the hs_vlistener_n mask-apply
    lives in exec's FROZEN branch, so a count poke during an enabled hold
    fired into the void (silent lsn=0, no fault — DONKEY regi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
    [jmr_js_vm_exec64.sv, sim_main.cpp]
2026-08-24 fence the 69-member hs64 handshake mux family with dont_touch
    ExploreArea stall hypothesis (user, from static reading + AMD-documented
    hang pattern): Retarget's cross-instance sharing search across a
    near-identical family this large can blow up combinatorially. The
    selectors are tiny 2:1 muxes — fencing costs ~nothing. Verilator ignores
    the attribute (sim bit-identical; suite + PACMAN verified). Run 23 with
    ExploreArea is the experiment; Default fastopt remains the fast path.
2026-08-24 LUTRAM->BRAM sweep: 10 arrays to the 26.5 spare tiles (~1.9k SLICEM slices)
    The unplayed cheap card before vst_win surgery: P22's binding constraint
    is SLICES (short 2,405), and remaining LUTRAM occupies ~2.9k SLICEM
    slices the placer counts as unavailable. name_off/blen/len/hash,
    vgc_queue, all four gens, varr_lidx, vobj_len re-styled to block —
    attribute-only, 1-beat contract unchanged. Also recorded: census yields
    are UPPER BOUNDS (name_has promised 7.7k, delivered ~1.3k — driven-net
    attribution counts shared cones; listeners/JSON delivered full value).
    Ladder now: run 23 (fence + ExploreArea experiment, in flight, pre-sweep
    sources) -> run 24 carries this sweep + whatever run 23 tea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
2026-08-24 ledger: fence confirmed (4m01s ExploreArea), shortfall series, run-24 arithmetic
2026-08-24 swap in INVADER2 (sort-free leaderboard); all six titles now clean of replace/test/match/exec/sort
    Gate: compiles clean, FB byte-identical over compared frames vs the
    prior shipping INVADERS. Prior variant kept as INVADERS.HTML.SORTVAR.
2026-08-24 linebuf -> BRAM: strobed writes (DIR_FMT 'L' collision split to its own beat), armed 2-beat reads across the INPUT#/trim/copy parser
    The final 189-slice lever: linebuf's comb-read muxing measured ~3k LUTs.
    Console/DIR/LOAD tests + PACMAN + bytecode green.
    [storage_engine.sv]
2026-08-24 fixing timing it fits now
    [jmr_js_vm_exec64.sv]
2026-08-25 log-depth normalize: v64_norm_shift + the add-task inline (52/55-step loop-carried shifts -> LZC priority scan + one barrel shift)
    Same serial-chain class as the multiply's 477-CARRY4 path, the leading
    suspect for run 29's next-worst timing family. Exponent-floor clamp
    (subnormal boundary er>=1) preserved exactly. Gates built FIRST:
    tests/test_fp_add_norm.py — catastrophic cancellation (2^-50 shift),
    signed-zero exact cancel, ties-to-even at 2^-53, running-sum exactness
    — green before and after, plus the 6 FP-mul gates and full bytecode.
    Staged; synthesis held until run 29 confirms the bottleneck ranking.
2026-08-25 v64_mul_pack: sticky-OR to masked tree-reduce, dead comb mul task deleted
    Diagnosis note for the ledger: pack's two 106-loops were NOT the serial
    class (priority scan + associative OR both reassociate log-depth; the
    killers were loops carrying a shifted VALUE between iterations). Made
    the sticky structurally tree-form anyway (mask + |reduce) so no
    synthesis pass can serialize it, and deleted v64_mul_task (zero
    callers). FP gates 10/10 + ASTEROID green.
2026-08-25 ledger: cleanup queue with the function-inlining caveat
2026-08-25 shr_sticky hardened to mask-form; run-29 diagnosis: the -287 path IS the staged add-path fix's target
    Path dissection (677 cells): 659 = the vst_wdata cone; the exotic
    crossings were entry fringe. The ~460 CARRY4s = the pre-fix normalize
    loops' per-iteration exponent decrements serialized by AreaOptimized —
    run 29 predates the norm commit. The funnel endpoint named the SINK,
    not the culprit; op-tiering verdict deferred until a run WITH the fix
    measures. FP gates 10/10.
    [jmr_value.sv]
2026-08-25 div8 VM clock: u_vm on ui_clk/8 BUFGCE (run-30 measurement: all 6,000 worst paths interior to the VM; +11.26ns at 80ns)
    - jmr_js_core: VM_CLK_DIV param (default 8), BUFGCE/Verilator-equivalent
    divided clock, pulse latches for start/stop/frame_tick/key events,
    match-held sram ack shim (VM FSM seams re-arm req on consume beats and
    some sites sample acks late - neither req-drop nor beat-clear holds are
    safe; the held ack pairs by request identity), vm_fb_swap edge detect.
    - jmr_js_vm: code BRAM write port on full-rate clk_code_w (console
    streams loads at 100 MHz).
    - xdc: create_generated_clock -divide_by 8 on the BUFGCE.
    - sim_main: key_strobe paced 9 clks (a burst inside one beat win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
2026-08-25 ledger: div8 campaign entry
2026-08-25 div8: glitch-free Verilator clock gate (negedge-registered CE = exact BUFGCE semantics)
    The raw clk & vm_ce gate glitched: vm_ce rises just after a posedge
    while clk is still high, adding a spurious vm_clk edge mid-window. The
    VM clocked twice per beat in sim - the event latch was consumed at the
    glitch edge AND the real edge, double-enqueuing every key event (caught
    by test_rtl_player_x_moves_on_key: one KEYEVT moved x twice). BUFGCE
    latches CE during clk-low precisely to prevent this; the negedge
    register reproduces it. Verilator-only - the synth netlist is untouched
    and run 32 stays valid.
    [jmr_js_core.sv]
2026-08-25 ledger: clock-gate glitch entry
2026-08-25 ledger: first light on glass
2026-08-25 run-33 timing: kill the four 100MHz residual families run 32 exposed
    Run 32 was the first route where the VM stopped dominating (-1.249 vs
    -58.7): 477 failing endpoints, all outside the 80ns domain. Fixes, by
    family:
    - console C_EXEC dispatch (-1.249 head, 14 LUT levels): the 11 command
    arms' len+char compares now land in registered predicates (line
    changes at most one char per keystroke and C_EXEC runs >= 2 cycles
    after the last edit via C_WAIT_VIDEO, so the 1-cycle lag is
    unobservable); the priority chain selects among registered bits.
    - console C_NWR suffix classify (-1.06): last-5-chars shift register
    captured during the existing name walk replaces five 127:1 dynamic
    muxes; R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
    [jmr_console_engine.sv, jmr_fb_scanout.sv, jmr_js_core.sv, nexys_video.xdc]
2026-08-25 first-light SD fixes: honor CCS (SDSC byte addressing) + bound the dir-scan chain
    Board evidence (2026-08-25): HELP/MEM/?SN all work on glass; DIR and
    LOAD wedge forever with busy high and no ?IO. Two defects compose:
    1. sd_spi_master discarded the CMD58 OCR, so CCS was never captured
    and CMD17/24 always sent block addresses. An SDSC card (CCS=0) takes
    BYTE addresses: every read 'succeeded' but served the wrong sector,
    so the FAT parse chewed valid-looking garbage. The sim card model is
    SDHC (OCR 0x40..) - sim behavior unchanged by honoring CCS.
    2. storage_engine's S_DS_CHAIN dir-scan walk had no cycle guard (S_FC0
    already had fc_guard): a garbage FAT entry pointing back into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
    [sd_spi_master.sv, storage_engine.sv]
2026-08-25 u_stor: LBA-cone splits (run-33 head) + op watchdog (no storage stall may freeze the machine)
    - S_DS_BASE settle state: ds_base = data_start + ((ds_clus-2)<<spc_shift)
    computed once per cluster (ds_clus changes only at S_DS_START and the
    guarded S_DS_CHAIN); the sector walk adds ds_sect to a register. Kills
    the 16-level ds_clus->buf_lba cone.
    - S_FS1/S_FS1B split: the fs_i*spf DSP product + (fs_clus>>7) settles in
    fs_pre; fat_start adds the next beat. Kills run-33's post-place head
    (l1 DSP -> sd_lba_r, -0.727).
    - op_wd watchdog: storage returns to S_IDLE between DIR pages (console
    strobes next step only when !busy), so every busy episode is pure
    SD/FAT work - any single episode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
    [storage_engine.sv]
2026-08-25 console: number-parse char pipeline (run-33 residual, 13 levels -> ~6)
    name_i -> 127:1 line mux -> digit classify -> state CE was -0.496 after
    the dispatch-predicate fix. The LIST/EDIT parse states now read a
    registered ch_ni_q and stall one beat via (ni_q != name_i) whenever the
    index moved - loop structure untouched, iterations self-pace to two
    beats, line[] is frozen post-Enter so the pipe is always coherent.
    [jmr_console_engine.sv]
2026-08-25 DDR3 bridge: UG586 handshake hold, natural burst mapping, BL8 read cache (board black-screen root cause)
    Board evidence: rectdemo correct in mini_fb (GUI dump) but HDMI black on
    run 32 AND run 33 (where u_fbpres/u_fbscan CLOSE timing) - functional,
    in the one module no simulation ever exercises (sim runs SRAM_INTERNAL).
    Three composed defects:
    1. Handshake race: app_en/app_wdf_wren pulsed one cycle AFTER sampling
    rdy high; UG586 requires enable to overlap rdy in the same cycle. Any
    rdy dip between (every refresh window, ~7.8us) silently dropped the
    command while the FSM marked it sent; a dropped read parked S_WAIT_RD
    forever, the arbiter wedged at the scan owner, linebuf stayed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
    [jmr_ddr3_sram_bridge.sv]
2026-08-25 ledger: DDR3 bridge black-screen entry
2026-08-25 tests/sim: scale the last div8 budgets (fclk ceilings, FRAME cap, finder TICK loop)
    Battery now fully green at true div8: 180 passed + these 3 were the
    budget class (frames cost 8x clocks; the 64M FRAME cap is a host
    responsiveness bound and scales with the VM).
2026-08-25 publish gate: check hold (WHS) as well as setup — a negative-WHS bit must never publish
2026-08-25 blit: per-pixel combinational divides -> per-blit setup divides + exact DDA
    The two 32-bit comb divides at the old jmr_js_vm:1626 (source-coord
    scaling) were run-30's routed worst path root and now sit inside run
    35's 104% East congestion window (u_exec64/u_vm, ~2k CARRY4). Replaced:
    16-beat restoring setup divides at S_BLIT entry (qx=sw/rw, rx=sw%rw,
    qy, ry) + per-pixel DDA (sx += qx; ax += rx; carry at rw) - exactly
    floor((x*sw)/rw) since x*sw = x*qx*rw + x*rx. Both v64 and legacy entry
    paths arm; blits provably enter at x=y=0 (exec64 x_n only written 0).
    The per-row sy*ww multiply stays (DSP, cheap).
    Gates: tests/test_blit_scale_exact.py (awkward ratios + 9-arg source
    rect, per-pixel flo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
2026-08-25 ledger: run-35 congestion fight
2026-08-25 ledger: run-35/contingency attribution clarification
2026-08-25 link: hold JSH eof until consumed (RUN-after-LOAD freeze root cause) + console escape hatches
    The link raised jsb_tether_eof for ONE cycle - the same cycle the last
    data byte strobes. The console is then in C_JSB_FEED processing that
    byte and returns to C_JSB_TETHER cycles later: the eof pulse was
    structurally unseeable, so every HTML RUN parked forever after a
    PERFECT stream (rectdemo worked - no stream; sim worked - the RPC path
    drives the console ports directly and never exercises the link's JSH
    framing: the sim boundary again). eof is now held until the console
    samples it in C_JSB_TETHER.
    Console (board directive: no wait may hard-wedge):
    - C_JSB_TETHER: ESC aborts; ~10.7s of host strea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
2026-08-25 board GUI: frame_tick never propagates - log fault, drop rx buffer, resync
    A crashed GUI stops forwarding keystrokes and masquerades as a dead
    board console (board evidence: GUI died on DIR/RUN while the FPGA,
    PS/2, and HDMI kept working).
    [board_backend.py]
2026-08-25 hdmi: swap G/B at the rgb2dvi boundary (IP wants R,B,G; blue rendered green on glass)
    Console text is white - channel-order-invariant - which is why text
    always looked right while game colors swapped. GUI mirror was correct
    (it renders palette indices host-side, never touching this path).
    [top_nexys_video.sv]
2026-08-25 xdc: permanent pblock pinning the DDR3 bridge to CLOCKREGION_X1Y3 (kills the MIG-anchor floorplan warp)
    [nexys_video.xdc]
2026-08-25 ledger: board-session finds (eof, escape hatches, GUI, rgb2dvi channel order)
2026-08-25 fix undeclared kbd_push in the tether ESC check (Verilator implicit-net let it through; Vivado errored)
    Use the console's real kbd FIFO idiom: !kbd_empty + kbd_data head +
    kbd_pop consume - matching C_IDLE. The sim battery passed because the
    implicit net read as constant 0 and nothing tests ESC-in-tether yet.
    [jmr_console_engine.sv]
2026-08-25 console: immediate ESC escape in C_DIR0W/C_DIRNW (board directive: three root causes, three distinguishable outcomes)
    A late stor_done pulse with nobody waiting is ignored; storage
    completes or watchdogs out on its own. With the tether ESC/timeout and
    the two storage watchdogs, every blocking wait now has both a user
    escape and a bounded automatic one.
2026-08-25 code BRAM write port: one pipeline stage (pblock36's routed head, -0.261)
    The raw console code_we strobe fanned out to code BRAM WEA pins spread
    across the die. Registered strobe/addr/data in the full-rate domain let
    the placer replicate next to the BRAMs; code_we is fire-and-forget so
    the cycle is invisible. LOAD/RUN suites green.
2026-08-25 ledger: constitutional gap - standalone HTML RUN needs a self-hosted compiler
2026-08-25 standalone HTML RUN: FAT NAME.JSH first, host tether fallback (CONSTITUTION rule 10)
    RUN on an HTML title now tries the card's .JSH (the builder's
    compile_sidecars mints one beside every .HTML) through the existing
    C_JSB_PREP machinery; a FAT miss falls back to the host tether with its
    ESC + timeout. End-to-end sim test drives the console raw (LINE RUN -
    the sim backend intercepts type_line RUN) and proves the title boots
    from card with no host stream. Known follow-ups (ledgered): SAVE should
    delete the sidecar (on-device-edit staleness guard); the get_byte walk
    re-reads a sector per byte (~8k clks/byte) - works, slow.
2026-08-25 console: reply-ROM pipe (run-38 head, 13 lvl) + universal progress watchdog (DIR cannot freeze)
    - reply_char's sel*idx message-ROM case fed state/reply CEs comb (all of
    run 38's -0.36..-0.29 heads). Registered lookup + one-beat settle,
    same recipe as the parse pipe.
    - Progress watchdog: any console state that is not an interactive wait
    (C_IDLE/C_PROMPT/C_ECHO/C_LIST_WAIT) must make progress; ~21.5s parked
    anywhere else forces ?IO + prompt. Board directive: DIR must not be
    able to freeze regardless of which state wedges - this bounds the
    still-unreproduced board DIR hang along with every future wedge class.
2026-08-25 PS/2 -> browser-keyCode game events (PACMAN on glass would not steer)
    The games' keydown listeners match browser keyCodes (37-40 arrows,
    32 space, 13 enter, 65-90 letters, 48-57 digits) - which only the GUI
    tether ever produced. The PS/2 path fed typing ASCII alone and the
    core's key_evt ports sat at their 1'b0 defaults in top. ps2_decode now
    emits kev_code/down/stb on every make AND break of a mapped key (held
    keys work); both keyboards feed the core (main wins a tie). Board-only
    path (CORE_SRCS excludes it) - lint-clean, proven on glass next bit.
2026-08-26 DIR wedge candidates (user analysis): 10-byte SPI lead-in + conditional remount
    - ST_INIT_LEAD 2 -> 10 bytes (80 clocks CS-low before CMD0): a cold
    card tolerated 16 clocks, but DIR re-initialized a LIVE card whose
    input may need flushing to byte-align. Spec hygiene either way.
    - DIR no longer forces a remount - it was the ONLY command that re-init
    a live card (exactly its board wedge slice). Hot-swap preserved: any
    sd_cd change poisons (new card_present pass-through, board
    ~sd_cd, sim default 1). Sim note: SDRELOAD swaps card content under a
    live mount; all test cards share the builder's fixed geometry, so the
    cached BPB stays valid - 44 storage/console tests green, DIR lists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
    [jmr_js_core.sv, sd_spi_master.sv, storage_engine.sv, top_nexys_video.sv]
2026-08-26 sim compile-on-RUN: never compile a squashed card copy (DONKEY lost its sprites)
    The editor mirror populated from the card's display-only HTML contains
    <LINE n: ... OMITTED> placeholders where the sprite data lines were
    (squash_long_html_lines exists so LIST survives 100KB base64 lines).
    Compiling that mirror produces a title with no characters. Detect the
    marker and compile storage/STEM.HTML - the source of truth - instead.
    The .JSH sidecar path was already correct (minted from RAW html before
    the squash). Board tether path already compiles storage/ directly.
    [sim_backend.py]
2026-08-26 progress watchdog: stor_done pulses count as progress (2.36MB DONKEY.JSH standalone load is minutes of live get_byte traffic)
    A wedged op stops pulsing done and the 21.5s clock runs as before.
    Measured: the byte loader's sector cache is healthy (1383 hits / 4
    misses) - the ~1.1k clks/byte pace is handshake overhead, DONKEY ~26s
    board load. Pace optimization ledgered, not blocking.
2026-08-26 ledger: DONKEY divergence investigation state + open board items
2026-08-26 tether: K messages carry the PS/2 scancode hex (arrows-only-right board mystery needs the bytes)
    The decoder is proven correct by unit test (tb: all four arrows E0-make
    and E0-F0-break produce distinct keyCodes 37-40, space 32, clean
    interleave with typing) - so if the board delivers only RIGHT, the
    PIC24 USB->PS/2 translation stream is the suspect and we need to SEE
    it. K -> Kxx with the raw scancode; the GUI flight log now shows every
    byte the keyboard actually sends.
    [board_backend.py, jmr_uart_link.sv, top_nexys_video.sv]
2026-08-26 DONKEY root cause: >1023px sprite sheets wrap their row stride (strict-xfail gate + ledger)
2026-08-26 board_flow: archive_bit.sh - label each run's bitstream (user directive: never smash runs)
2026-08-26 debug instrumentation: IDS? gains drawimage/ctxsx/e64dihit; di counters exposed
    The parent dbg_di_hit was never absorbed from exec64 (VMSTAT dihit=0
    forever - a dead instrument that misdirected the DONKEY hunt). The
    parent-side sync added at the ctx handoff block is NOT on the blit
    path (e64dihit=3475 raw vs parent 0 during DONKEY) - proper sync is
    part of the DONKEY fix; meanwhile IDS? reads the raw e64 counter.
    [sim_main.cpp]
2026-08-26 ledger: DONKEY elimination tree + next move
2026-08-26 DIR: conditional remount, completing 86011a9 (user patch)
    86011a9 removed the mounted poison but left push_call(S_MNT0, S_DIR0)
    unconditional - DIR still ran full SPI re-init (CMD0/CMD8/ACMD41/CMD58)
    on a live card every time, the one thing DIR does that LOAD and LIST
    (both fine on the board) do not. Now the S_OP0/S_DEL0 idiom:
    if (!mounted) mount, else straight to S_DIR0 (safe: it initializes
    purely from persistent mount registers). Hot-swap intact via
    card_present clearing mounted. Sim cannot validate the fix (its card
    model accepts re-init - the sim-boundary class again); board proves it.
    [storage_engine.sv]
2026-08-26 flow: checkpoint recovery - a killed step resumes from the newest impl checkpoint
    Run-41 lesson (user analysis): the route was SIGKILLed by something
    outside Vivado (74GB free, no OOM; killer unidentified, ledgered) at
    Phase 5.3 with checkpoints on disk minutes old, and the flow discarded
    everything. Now: impl failure with any top_nexys_video_{routed,physopt,
    placed,opt}.dcp present resumes non-project from the newest one,
    re-runs only the missing steps, and proceeds through the same timing
    gate and publish tail (recovered flows write their own bitstream).
    Only a run with no checkpoints at all is a true failure.
2026-08-26 ledger: run-41 postmortem, checkpoint recovery, DIR A/B plan
2026-08-26 DONKEY hunt: dispatch-chain probes + endgame state (two class-machinery defects isolated)
    Instrumentation ([CMR]/[CMD]/[CTU] stderr probes, IDS? counters) plus
    the ledgered chain of evidence. Also aboard from the morning list:
    LOAD halts the VM like NEW, kbd FIFO drained on game->console, FB
    zero-fill on game entry, banner R44, storage-state tether telemetry
    (Dxx lines), PS/2 keypad aliases.
2026-08-26 remove stderr dispatch probes - they filled the un-drained GUI stderr pipe and froze FPGA-SIM at any method-call-heavy screen (DONKEY select). Probe scripts re-insert them under a drain-thread harnes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
2026-08-26 DONKEY FIXED: class-method scan issued the pre-increment index - the LAST method of any >=3-method class never resolved
    The pipelined method-table walk's prime beat issued entry 1; the first
    else beat then re-issued entry 1 (pre-increment cls_m), lagging every
    later comparison by one entry, so the final entry's data landed one
    beat AFTER termination and was never compared. Mario/DK/Barrel declare
    .update LAST -> updateMario/updateDK dispatched into silent undefined:
    ramps and ladders, no player, no kong, no barrels (board + FPGA-SIM;
    PYTHON FM resolves by dict and never missed). Table upload was verified
    correct ([CTH]/[CTM] probes); the fix issues one ahead.
    DONKEY game screen: 7 distinct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
2026-08-26 fpga-sim fixed for donkey!
    [board_backend.py]
2026-08-26 board round 5 (user diagnoses): telemetry that fires, cache A/B define, FB view gate, stick Y at the boundary, real kbd drain
    1. DIR telemetry rewritten: the equality-on-saturating-counter could
    never fire (board log: zero D lines). Now: after ~0.67s CONTINUOUS
    busy, emit stor_state every ~0.17s - catches parked AND looping
    stalls; normal ops idle between strobes and never trigger.
    2. JMR_NOCACHE define disables the bridge's BL8 read cache - the
    PACMAN-freeze A/B build (heaviest SRAM user; the cache is the last
    unsimulatable suspect).
    3. game_view: scan holds the console view until the FB zero-fill
    completes - run 44 cleared the FB but switched the view first, so
    the old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
    [jmr_console_engine.sv, jmr_ddr3_sram_bridge.sv, jmr_js_core.sv, jmr_uart_link.sv, top_nexys_video.sv]
2026-08-26 run-46 set: ctorless-class fix, compiler loud sprite limits, di-counter sync, banner R46, nocache plumbing
    - Defect B FIXED compiler-side: constructorless classes get a
    synthesized empty ctor (same machinery the class-fields path already
    used), so new T() always stamps the instance class - the ctorless
    gate flips from strict-xfail to a hard pass. Zero xfails remain.
    - CONSTITUTION loud-overflow: encode refuses SPR-pack sprites over
    16-bit dims or 262144 px at build time (big art belongs in ASET).
    - dbg_di_hit/miss synced on the S_BLIT handoff (the path that actually
    runs) - board VMSTAT drawImage counters live at last.
    - banner R46; JMR_VIVADO_DEFINES env -> verilog_define (one-com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
    [jmr_console_engine.sv]
2026-08-26 BOARD tether VM heartbeat (spec): V<st2><fault2><ip4> line per dump + on fault rise
    RTL only, per the provided spec: flopped scalars (casestate_q,
    fault_code, ip, machine_fault) packed into one register ON THE VM
    CLOCK in jmr_js_vm; core/top pass the register through; the link
    samples it and emits via the K/D TX machinery when !dump_active - the
    VM cone never extends onto the 100 MHz UART. One V line per completed
    S/P dump plus one on machine_fault rise. Host parser already in tree;
    FPGA-SIM VMSTAT untouched. Tens of LUTs, 0 BRAM.
    A frozen PACMAN on the board now names its stuck VM state in
    traces/*_BOARD.log (NOTE VM st=...).
    Fast gates: 39 passed, 0 xfail.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
    [jmr_js_core.sv, jmr_uart_link.sv, top_nexys_video.sv]
2026-08-26 flow: catch wait_on_runs so checkpoint recovery is reachable (run 45 died before the recovery branch ran)
2026-08-26 flow: JMR_VIVADO_STRATEGY env selects the impl strategy (congestion campaign knob)
2026-08-27 ledger: run-45 congestion campaign — AltSpreadLogic_high routes what default/Explore cannot
2026-08-27 flow: archive_run.sh — archive DCPs/reports/logs before any relaunch (runs never smash each other)
2026-08-27 flow: re-apply BIN_FILE after strategy set (strategy reset wiped it; run 46 shipped no .bin)
2026-08-27 ledger: run 46 clean timing + nocache A/B results
2026-08-27 ledger: FPGA_FIT scoreboard now run 46 (WNS +0.017, first gate-published bit)
2026-08-27 flow: flash the .bit — .bin blue-screens via openFPGALoader -f (hardware-confirmed format mismatch)
2026-08-27 storage: DIR sector-advance read the wrong sector (stale ds_base) — cold DIR silently truncated at 16 entries
    S_DIR0 never set ds_base, so S_DIR_ADV's next-sector read used whatever
    the last LOAD/mount scan left there (0 after reset): cold DIR read LBA 1
    instead of root sector 1, hit zeros/garbage, and ended with a silent
    premature eof. Sim-traced (dirtrace: lba=1 -> lba=2141 after fix);
    validated end-to-end: 17-file card lists all 17 across the boundary,
    real card lists all 14 visible files, both terminate at READY.
    Also: banner R47; sim-only Verilator probes (STOR? RPC, DIR/vram file
    traces) — all under ifdef VERILATOR / metacomments, no synthesis effect.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
    [jmr_console_engine.sv, jmr_video_vram.sv, sim_main.cpp, storage_engine.sv]
2026-08-27 ledger: run 47 clean timing, DIR fix aboard
2026-08-27 telemetry: continuous D-lines + E-beat + periodic V heartbeat; DIR: phantom -- MORE -- fixed
    tb_uart_link proved the D-line RTL good (4 lines at exact dwell marks),
    so the board silence is downstream — but the hardening lands anyway:
    - d_dwell re-arms at saturation instead of parking: a long stall now
    reports every ~0.17s for its whole duration (was 4 lines then silence)
    - E-line beat: free-running storage-state report (~1.34s + change-
    triggered, 10ms rate cap) regardless of dwell — Exx, host logs
    STOR-BEAT change-only
    - V heartbeat gains a free-running ~0.67s arm: alive at the console,
    not just per glass dump / fault edge
    - tb_uart_link test 4 asserts all three (D09 cadence, E0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
    [board_backend.py, jmr_console_engine.sv, jmr_uart_link.sv, tb_uart_link.cpp]
2026-08-27 ledger: run 48 — telemetry + MORE fix, WNS +0.130
2026-08-27 DIR handshake self-heal + loud failure paths + console-state telemetry (run 49)
    Board capture (R48): DIR -> storage ran and returned to idle within the
    Enter keypress, console never saw done, cons watchdog ?IO at 32s. The
    console<->storage done/strobe handshake dropped a pulse on silicon in a
    way sim does not reproduce. Fixes:
    - console C_DIR0W/C_DIRNW: if storage sits idle AND silent 2^22 clks
    (42ms - impossible mid-op, busy is high then) the console re-issues
    the request; bounded (3), watchdogs still backstop. Zero cost on the
    healthy path (counter only runs while waiting).
    - C_DIR0W stor_err now retries (remount, up to 3) before ?IO - also
    heals the long-standing intermittent ?IO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
    [board_backend.py, jmr_console_engine.sv, jmr_js_core.sv, jmr_uart_link.sv, storage_engine.sv, tb_uart_link.cpp, top_nexys_video.sv]
2026-08-27 flow: never-smash guard — auto-archive previous impl bit before any launch; preserve gate-refused bits labeled WNSFAIL
2026-08-27 gates: run-50 engine/prefetch/raf-timestamp exactness gates (green pre-surgery)
    8 gates pinning current behavior at the seams the run-50 set touches:
    ASET blit word packing (odd source x, 1-px column, downscale word
    skips), fillRect exact shapes + fill/blit/fill ordering, ImageData
    odd-geometry roundtrip, rAF timestamp exact IEEE delta (floor 33),
    branch/call/RET prefetch exactness. Two scenarios proved undrivable
    in-session (second RUN after hard_break: console keys dead; .JS RUN
    answers ?NB) - documented in-file, protection moved to by-construction
    invalidation + the C2 sim-only checker.
2026-08-27 core: work-RAM port ack-loss reissue watchdog (DIR C_DIR_CH starvation)
    Board E-telemetry (R49): console stuck at C_DIR_CH with storage idle —
    the work-RAM request latch waits on the sram fabric (DDR3 bridge on
    board, 1-cycle model in sim) with no reissue protection; a lost or
    misattributed ack starves it forever (21.5s ?IO). The VM port already
    carries this class of guard (vm_ack_hold); the work port now reissues
    its held, idempotent request after 4096 unacked cycles (41us), and
    keeps reissuing every 41us until served. Zero cost on the healthy path;
    sim-validated (gates 23/23, DIR cards list and terminate).
    NOT BUILT — build launches require explicit user authorization.
    Co-Authored-By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
    [jmr_js_core.sv]
2026-08-27 C3+C4: sequential rAF timestamp (comb 53x53 deleted) + redundant frame-end GC skip
    C3: run-49 checkpoint showed every worst intra-VM path was vframe_no ->
    vst_wdata (75.3/80 ns, 86 levels) — the once-per-frame rAF timestamp
    recomputed combinationally every beat. Now a free-running 32-beat
    shift-add (exact 85-bit vframe_no x mant(50/3)) plus one registered
    pack beat, bit-identical to the IEEE product (both inputs exact). The
    rAF push stalls on raf_ts_rdy: stale values unobservable by
    construction. v64_mul_task deleted — 3 DSPs + 34 CARRY4 of depth leave
    the vst_wdata cone.
    C4: scheduled frame-end GC is skipped when a forced (alloc-retry) GC
    already collected this frame (old PACMAN profil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
2026-08-27 console: C_DIR_CH re-issues its dropped mem pulse (second starvation mechanism)
    The mem request is a 1-cycle pulse into the shared work latch; a busy
    latch that cycle drops it silently and C_DIR_CH waits forever. Re-pulse
    the identical read on the 42ms qualifier, repeating until granted.
    Together with 86a6af2 (latch-side ack-loss reissue) both known paths to
    the board-observed C_DIR_CH starvation now self-heal. Sim-proven.
    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
    [jmr_console_engine.sv]
2026-08-27 C1-fill: full-rate raster engine — fillRect/clear at 1 px/core-clk (was 1 px/VM-beat)
    New jmr_raster_engine.sv on the 100 MHz clock, modelled on
    jmr_fb_present's proven go/busy contract: the VM latches op scalars,
    pulses rast_go one beat, blocks on a done LATCH (busy can rise and
    fall entirely between two VM beats — a 1x1 fill is ~2 clk — so the
    core stretches completion into a level, cleared at the next go edge).
    S_V64_RECT / S_V64_CLEAR / S_RECT / S_CLEAR issue-and-wait; walks
    deleted from the VM. Engine owns no arrays; BLIT/IMGD modes are wired
    but not yet driven (next pieces). FB mux selects the engine on
    busy||fb_we — keying on busy alone dropped the last pixel of every op
    (caug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
    [jmr_js_core.sv]
2026-08-27 flow: jmr_raster_engine.sv into the synth source list (file-list change: next launch needs bit-fresh per the documented trigger)
2026-08-27 C1-blit/imgd: drawImage and putImageData walks move to the raster engine
    S_BLIT hands the engine the latched blit scalars + DDA setup (the
    16-beat divides stay in the VM); the engine walks the exact floor DDA
    incrementally — the per-pixel 16x22 spr_so multiply leaves the netlist
    (run-30's -58.7ns cone, deleted rather than pipelined) and the
    one-word cache serves adjacent same-word pixels without an SRAM trip.
    S_IMGD_PUT becomes a linear DMA issue (was one arbiter round trip per
    pixel at VM-beat pace — MRDOFAST's measured 63.5% sink). Was >=16 core
    clk/px on both paths; now ~1 (blit cached) / ~2-3 (fetch-paced).
    Gates: 13/13 — 8 engine + 4 blit-scale-exact + wide-sheet.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
2026-08-27 C5: VM_CLK_DIV 8 -> 7 (12.5 -> 14.3 MHz), all three files together
    Justified by C3 (the 75.3 ns vframe_no cone deleted; next walls ~71 ns
    at 20-26% logic on a pressure-free placement — a route-recovery bet
    under a real 70 ns constraint) and C1 (the blit spr_so multiply cone
    also gone). Core parameter + XDC -divide_by + test _VMDIV move as one:
    changing fewer than all three constrains the design at one period and
    clocks it at another. Fallback: div 7 -> 8 in the same three files
    keeps ~90% of run 51's win.
    C2 (fetch-wait skip) DROPPED from run 51: the wait beat is
    load-bearing — vconsts/vvars operand addressing decodes combinationally
    from code_rdata during it (exec64:2878), so skipping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
    [jmr_js_core.sv, nexys_video.xdc]
2026-08-27 engine: incremental dest address (peer congestion review, pre-run-51)
    fb_waddr was pxy*640+pxx per pixel in four case arms — three adder
    levels on the 100 MHz clock for no reason, the same inconsistency the
    source address already had fixed. Now fb_row/fb_addr: one constant
    multiply per op at go, +1 per pixel, re-anchored to fb_row+MW at row
    wrap (OOB drift from clipped rects never carries across rows; advanced
    unconditionally in adv() since OOB pixels skip the write but still
    step). Gates 13/13.
    [jmr_raster_engine.sv]
2026-08-27 flow: record congestion + timing distributions every run
    Every failed-run postmortem starved on -max_paths 1 headlines and
    unrecorded congestion (runs 31/35/45 diagnosed only by re-opening
    checkpoints days later; run 49 under Congestion_SpreadLogic_high shows
    NO window above level 5 — a fact no run artifact captured). Three
    catch-wrapped reports after impl, seconds each, archived per run.
2026-08-27 C1 fix: engine draws must mark fb_dirty (legacy implicit present starved) + hold div8 for run 51
    Battery caught it: test_rtl_present_once_per_frame — swaps stuck at 2
    across 43 frames. The implicit frame-end present keys on fb_dirty,
    which was set only by the VM's own fb_we — never firing now that the
    engine draws. Any rast_go marks the frame dirty (one benign extra
    present for an all-transparent blit). Explicit-swapBuffers titles were
    unaffected, which is why every game probe looked healthy.
    div7 -> div8 (user decision): div7 was run 51's only timing/congestion
    gamble (post-C3 wall ~71 ns vs 70 budget as-placed; div7 also spends
    the slack that makes Congestion_SpreadLogic_high free). D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
    [jmr_js_core.sv, nexys_video.xdc]
2026-08-28 ledger: run 50 — DIR works on the board (first working directory); run 51 launched
2026-08-28 flow: strategy set also wipes the TCL.POST checkpoint hooks — re-apply (run 51 trap)
    Same class as the run-46 BIN_FILE trap: set_property strategy resets
    step options, so run 51 wrote NO flow-level checkpoints and the
    post_*.dcp on disk were silently run 50's. Native impl_1/*.dcp saved
    the contingency. Hooks now re-applied after the strategy, next to the
    BIN_FILE re-apply.
2026-08-28 ledger: run 51 timing clean (+0.002) via AltSpreadLogic_low contingency — the 2x engine bit
2026-08-28 run 52: present pipeline deleted (scanout reads draw bank) + vstack 1W merge + stor name_hit registered + div7
    P3 (user decision: fastest + congestion-negative, tearing accepted):
    jmr_fb_scanout line-fills from mini_fb Port B (freed by deleting
    jmr_fb_present) — S_FB_SYNC's 768,008 clk/frame wait, the present
    engine, the DDR3 front image, and TWO SRAM arbiter clients (scan
    owner 1, present owner 4) are all deleted. Scanout can never starve
    on the bridge again (run-32/33 black-screen class gone). The run-44
    previous-game-flash guard re-keys on the first raster op after game
    entry (always the boot clear). Measured: MRDOFAST 891k clk/frame at
    div8 = 4.52x vs baseline; S_FB_SYNC absent from th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
2026-08-28 ledger: run 52 first-attempt clean (+0.007, div7) — 16-minute route; present deleted, vstack BRAM
2026-08-28 run 53: present restored (display fix) + BL8 write-combine + joystick 20->77Hz + banner R53
    R1: run-52's live scanout showed the clear+redraw cycle every frame
    (board: unplayable blank-flash) — jmr_fb_present + DDR3 scanout
    restored from 6e9941d, div7 re-applied. Keeps: raster engine,
    vstack-BRAM, name_hit, div7.
    R2: single-entry BL8 WRITE-COMBINE in the bridge (twin of the read
    cache): sequential writes into one block merge and ack SAME-CYCLE;
    flush as one masked burst on block change or a read touching the
    block. Demand-flush is complete (every reader uses this port). The
    present's 153,600-word stream drops from ~1 UI transaction/word to
    1/8. JMR_NOBURST define = one-flash board A/B (br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
    [jmr_console_engine.sv, jmr_ddr3_sram_bridge.sv, jmr_fb_scanout.sv, jmr_i2c_joy.sv, jmr_js_core.sv]
2026-08-28 docs: run-53 cost model for HTML titles — JS ops are the currency, paint is ~free
2026-08-28 engine: register the row-wrap DDA (run 53's -0.53 worst family killed structurally)
    The wrap's ay+ryr>=h compare selecting row_so+row_step(+stride) was
    run 53's entire failing set (9 levels, 44% logic). Next-row so/ay now
    precompute into registers every clk; the wrap consumes registers only
    (register-to-register). nxt_ok guards the one stale beat after a
    wrap/go: a too-early wrap holds one idempotent beat — only w==1 rows
    ever hit it (the 1-px-wide exact gate covers it), and imgd_i is
    hold-guarded so the IMGD source cannot desync. 14/14 exact-pixel
    gates.
    [jmr_raster_engine.sv]
2026-08-28 ledger: MKPVP blur SOLVED — art oversubscribes SRAM by 861KB, present writes through sheet 2 (content/mint fix, not RTL)
2026-08-28 joy: 10ms polls killed the stick (board) — 25ms + hold-last-state on transient NACK
    Run 53's 10 ms poll starved the peripheral's firmware (50 ms was
    empirical device tolerance) and the failure branch forced all
    directions OFF on any bad batch — a starved device played dead. Now:
    25 ms polls (worst staleness ~28 ms, still ~2x better than the
    original 55 ms ASTEROID lag) and transient bad batches HOLD the last
    state; only 8 consecutive failures (~0.2 s, genuine unplug) release
    the outputs. Board-only file; flash-and-try is the test.
    [jmr_i2c_joy.sv]
2026-08-28 content: repack+dedup MK fighter sprite sheets — closes the SRAM/front-buffer collision (red-player blur)
    Root cause (found by the raster/-96 session): MKPVP/MKCPU/MKBIG/MKBIGCPU
    pack Kano's sprite sheet into asset SRAM at an offset that overlaps the
    framebuffer's fixed region (byte 2,961,408+, shared by FB/WORK/SPR/SRC/
    IMGD). Every present-engine frame copy wrote screen pixels straight
    through live sprite art. Direction flip = different sheet = instantly
    clean, matching the reported symptom exactly.
    Fix is lossless, no frames cut, no resolution change (verified per-frame
    pixel-exact against the originals, 0/295 mismatches on MKPVP alone):
    1. Dedup exact-duplicate frames within each ch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
2026-08-28 core: per-client SRAM ack gates use the REGISTERED owner (run 54's -0.270 family)
    The comb sram_owner resolves the next grant from live requests, so
    ack gates carried the whole request cone (vm_sram_req on vm_clk ->
    fbscan linebuf CE, 8 levels, the entire run-54 failing set). Logically
    a false path — ack implies the owner was latched — invisible to the
    tools. Every ack source is registered >=1 cycle after grant, so
    sram_owner_q is always valid at ack. 15/15 gates.
    [jmr_js_core.sv]
2026-08-28 joy: 250us inter-register gaps + 40ms polls (board: 25ms works-then-jams)
    The jam holds the last pushed direction = the stick's own MCU wedges
    under sustained polling and repeats its last sample; hysteresis then
    correctly holds it. The 7 back-to-back register reads were the real
    stressor (inter-batch time only masked it). Now 250us between register
    reads + 40ms between batches (~43ms worst staleness, still better than
    the original 55ms, and the hold-on-transient keeps blips invisible).
    Board-only file; flash is the test. Keys-rescue behavior explained:
    KEYEVT supersede re-baselines the VM state above the stuck PHY bit.
    [jmr_i2c_joy.sv]
2026-08-28 joy: boot-calibrated relative hysteresis (JOYDEMO forensics: live L1 while R1 stuck 20s)
    Live left tracking while right stayed latched kills the stale-firmware
    theory: the pot RESTS right of nominal center (~145-155) and the
    absolute release threshold (144) never releases at rest — jammed until
    thermal drift or a leftward nudge. First good batch now captures the
    stick's true rest (untouched at power-on); all thresholds are relative
    (rest+-32 engage, rest+-16 release, 9-bit signed) — tolerant of any
    worn or mis-centered stick. Keeps the 40ms+250us-gap pacing and
    hold-on-transient.
    [jmr_i2c_joy.sv]
2026-08-28 tests: _vmstat_int matched fault= inside efault= — every fault assertion read the wrong field
    Found by cross-agent reconciliation of an INVFAST VMSTAT discrepancy:
    my probe and the suite helper both split on 'fault=' whose first
    occurrence is inside 'efault='. All fault==0 gates were soft (real
    faults were caught only when they also broke pixel asserts). Token now
    requires a field boundary.
2026-08-28 content: split animate()'s per-invader collision block into its own function (INVFAST fault 3)
    animate() had grown to 24+ declared locals during the FAST rewrite
    (ix/iy/iw/ih/ibot/prx/pry/prr/j among them) -- over the platform's
    per-function env-slot budget (RTL ENV_SLOTS=16; the 17th LET_VAR
    faults with a fully healthy heap, matching what showed on the board:
    fault=3 on frame 0 attract, obj/arr/env all comfortable). Diagnosed by
    the raster/-96 session from the compiled encoding (LET_VAR slot hints
    running 11..15 then going hintless).
    updateInvaderCollision() takes the bunker-hit / invasionOver / player-
    bullet-collision work per invader out of animate() into its own
    function -- the wall is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
2026-08-28 compiler: loud refuse past 16 locals/params per function (was silent); fix INVFAST + MISSILE; mint-time asset SRAM boundary check
    Two related loud-refuse guardrails, plus the fixes each one exposed.
    1. jsb_format.py: build_aset_payload refuses ASET art reaching into
    runtime-reserved SRAM (framebuffer/work/spr/src/imgd, contiguous from
    byte 2,961,408 to the top of the 4MB bank) -- traced by the raster/-96
    session to the MKPVP/MKCPU/MKBIG/MKBIGCPU red-player blur (art
    overlapping the framebuffer region, trampled every present-engine
    frame copy). Content fix already landed separately (0f02890).
    2. compiler.py: the 16-per-function env budget (RTL ENV_SLOTS=16) was
    tracked by _local_stack but t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
2026-08-29 LUTRAM eviction: 1W merges unlock ram_style=block on vframe sextet, vobj_cls, venv_gen, varr_lidx (~806 RAM macros -> ~9 BRAM); banner R56; ledger runs 53/54
2026-08-29 cons: p_empty_q registers the ladder-root line_len==0 (run 55's -0.466 leader); ledger run 55
2026-08-29 joy PHY v3 (board 2026-08-29): 8-batch settle window mutes outputs + settles calibration; idle drift re-centering (1 LSB/batch) so the release band tracks pot drift; phantom-release filter kills doub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
    [jmr_i2c_joy.sv]
2026-08-29 joy PHY v3b: stuck-release watchdog (engaged 1s below engage threshold = shifted rest -> snap center + release; kills the post-flick jam) + idle recenter window widened to 28
    [jmr_i2c_joy.sv]
2026-08-29 fbscan: 1W byte-stagger merge — linebuf finally infers as the 1 BRAM tile its comment always claimed (was 16,496 FFs + 10.6k LUT read muxes, the largest non-VM LUT sink on the chip); sim assertion gu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
2026-08-29 ledger: run 57 CLEAN +0.063, 80-min flow — the congestion campaign paid; Synth 8-6849 audit rule
2026-08-29 ledger: run 56 control arm — fbscan was the decisive lever
2026-08-29 VM joystick edge layer: accumulate edges + per-bit dispatch + queue provenance (R57 board: stick jam + burst fire = lost keyups from clear-all dispatch and the tether-supersede wipe eating synthetic 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
    [jmr_console_engine.sv]
2026-08-29 run-59 piece 0: opw_q — EXEC reads the op word from a fetch-wait-captured register, freeing the code BRAM port for prefetch; proven digit-identical (PACMAN profile exact match incl. fclk 11,575,102)
2026-08-29 run-59 piece 1 machinery, PARKED INERT (guard never fires; DONKEY digit-identical): prefetch handover + decode split (vconsts/vvars from incoming word, all else from opw) + central skip override + pf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
    [jmr_js_vm_exec64.sv, sim_main.cpp]
2026-08-30 content: mark-and-sweep invader/projectile kill (INVFAST fault 3, board-confirmed fixed)
    Root cause of the "freezes only on a hit, never a miss" board fault:
    updateInvaderCollision (from the animate()-split fix) spliced both
    invaders and projectiles synchronously, from inside a loop nested two
    levels deep (grids -> invaders -> this function's own projectiles
    scan). The original INVADERS.HTML never hit this because it deferred
    the entire kill (splice included) into a setTimeout callback, which by
    construction only ever runs after that frame's iteration has fully
    finished -- never nested inside it. The FAST rewrite correctly removed
    setTimeout (a real per-shot allocation) but made the splice
    s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
2026-08-30 content+docs: mark-and-sweep every kill site in INVFAST; new authoring rule
    User found a second freeze after the first fix: shooting the saucer
    (and, by the same shape, collecting a power-up) hit the identical
    fault -- the saucer-hit branch was the only one of three removal
    reasons in that loop that does score+effect calls before splicing
    (offscreen and bunker-blocked are bare splices and never froze),
    matching the invader-kill pattern exactly and confirming it isn't
    about loop nesting specifically -- it's "several calls, then splice,"
    synchronous, in one burst.
    Applied the same mark-and-sweep fix everywhere that shape exists in
    this file: player-bullets-vs-saucer, invader bullets vs player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
2026-08-30 docs: correct rule 6 — mark-and-sweep is a mitigation, not a proven fix
    Board test: the saucer-kill site, converted to the identical
    mark-and-sweep shape that fixed the invader-kill site, still faults.
    Same fault, same "only on the hit, never a miss" signature. This means
    "several calls then splice, synchronous" is not the full mechanism --
    it fixed one real site and left an identically-shaped site broken.
    Leading theory now: a slow, cross-frame resource leak (something not
    fully reclaimed run over run) that an early kill can survive and a
    kill late in a long session (the saucer only appears after ~720
    frames) cannot -- the saucer isn't special, it's just usually the
    first kill after enou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
2026-08-30 run 59: dual-path keydown dedup (dual-interface pad, board-confirmed mechanism) + cons line_tail_q hoist (run-58's -0.261 mux) + joy PHY v3c + PF skip machinery behind JMR_PF_SKIP (default OFF, verif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
    [jmr_console_engine.sv, jmr_i2c_joy.sv, jmr_js_vm_exec64.sv, sim_main.cpp]
2026-08-30 docs: pin the saucer/bumpScore fault to CALL_METHOD-vs-ARRAY_GET, not inline-depth
    Disassembled both bumpScore call sites via functional_model/compiler.py.
    bumpScore is fully inlined at every call site (never emits CALL_USER,
    its nominal entry is dead code) — so "inlined vs not" was never the
    difference. The real discriminator is the single instruction right
    before the inline: a CALL_METHOD return (invader.points(), works) vs a
    bare ARRAY_GET (UFO_SCORES[...], faults). Hands RTL two precise,
    testable hypotheses instead of a vague pool-pressure guess.
2026-08-30 invfast: route saucer score through a method call, matching the working invader-kill shape
    Adds Saucer.points(shotCount) (mirrors Invader.points()) and calls
    bumpScore(saucer.points(shotCount)) instead of
    bumpScore(UFO_SCORES[shotCount & 15]) directly. Disassembly confirms
    the saucer-kill site now compiles to the identical CALL_METHOD-then-
    inlined-bumpScore shape as the invader-kill site that's board-confirmed
    working. Untested on hardware. Noted in docs/GAME_DESIGN.md that
    INVADERS.HTML's saucer path uses a bare array index too and doesn't
    freeze, so the competing "no idle time to GC at ~60fps" theory stays
    live regardless of this result.
2026-08-30 docs: CALL_METHOD fix didn't clear the fault, it relocated it — pin to RET_VAL
    Board result: fault moved from bumpScore's inline entry to ip 1531,
    the RET_VAL inside the new Saucer.points() returning UFO_SCORES[...].
    Rules out the CALL_METHOD-vs-ARRAY_GET theory: wrapping the lookup in
    a method call just moved the same array-lookup-then-return sequence
    one level in, and the fault moved with it. Invader.points() returns
    constants via the same RET_VAL op with no issue, so the discriminator
    is the array-derived value itself, not the act of returning.
2026-08-30 docs: every saucer kill faults (not just 300s) + it's keyboard, not joystick
    Rules out value-magnitude theory outright (100% fault rate vs the ~1/16
    a magnitude theory predicts). Also corrects RTL's double-hit theory:
    it was pinned on run 58's un-deduped joystick fire button, but the user
    plays INVFAST on keyboard — that mechanism can't apply as framed.
2026-08-30 ledger: runs 58/59 — console parse family fully retired, 59 clean +0.034
2026-08-30 monitor: parse run-60+ H/F/T tether lines (heap gauge + fault forensics)
    Adds BoardBackend parsing for the three new observation-only lines
    spec'd in docs/ARCH_MONITOR.md: H (live env/arr/obj pool counts, feeds
    the same keys PYTHON/FPGA-SIM already use so HEAP STATS just works),
    F (at-fault kind/retried/state/vcsp/vsp + pools, new board_fault_*
    keys since BOARD's coarse vocabulary shouldn't overload fsite/heapovf
    which mean something more precise on the other runtimes), and T (last
    8 committed ips, rendered in the fault block as the approach path).
    Verified the bit-packing against synthetic hex lines (env/arr/obj
    round-trip, fault kind/state/vcsp/vsp round-trip, ip trail order).
    Untested aga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
2026-08-30 gui: display and capture real-time key events, with X11 autorepeat tagged
    Adds a live status readout (currently-held keys, last event, running
    repeat count) and per-event capture into the active backend's flight
    log — the same log the V/F/T-line fault forensics land in, so a
    held-key storm can be lined up against a board fault by timestamp.
    Repeat detection uses "keysym already in _keys_down" rather than the
    classic same-timestamp KeyRelease/KeyPress trick, because this desktop
    runs detectable X11 autorepeat (on_key_release already documented that
    autorepeat only resends KeyPress, never an interleaved KeyRelease) —
    so a held key never looks like a release+press pair to begin with.
    Obse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
2026-08-30 arch monitor: Keyboard block blinks on real keystrokes; status doc updates
    Wires gui_jmr_js.py's key capture (1d08748) into the Architecture
    Monitor: every keystroke that reaches backend.key_event() stamps
    self._kbd_last_t (absolute monotonic), forwarded through
    arch_snapshot()'s consumer as snap["kbd_last_t"], and consumed in
    ArchitectureView.update() via the same heat_stamp/decay mechanism
    every other engine block already uses. The Keyboard/PHY_PS2 block
    previously only lit via the RTL's one-cycle S_KEYEV dispatch state
    matching a rare board VMSTAT/V-line sample — in practice never
    visible. Now it blinks on every real press, on every runtime.
    Docs: recorded the fix in docs/ARCH_MONITOR.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
    [gui_arch_monitor.py, gui_jmr_js.py]
2026-08-30 symmetric dual-path dedup (board run 59: race won synthetic-first when a press lands just before an I2C poll batch — mirror guard swallows the REAL twin; both counters reset at RUN boundary); gate: r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
2026-08-30 run-60 observability: H/F/T telemetry (background pool scanner on dedicated LUTRAM ports, fault snapshot latches, committed-ip ring) + REALTICK board-faithful async frame_tick in sim + forensic publi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
2026-08-30 dedup: swallowed twin must not supersede (reverse-order keyup vanished — gate caught it); scoped to delivered real events only
2026-08-30 keyboard heat: cover BOARD's real input path; harden + test everything headless
    Testing before shipping caught the fix shipping dark on the exact
    runtime it was written for: (1) the GUI stamp was gated on
    backend.key_event existing, and BoardBackend has no key_event; (2) on
    BOARD the keyboard plugs into the board itself, so keystrokes never
    pass through the GUI at all — the tether K-line is the only evidence.
    Now two stamps, merged newest-wins in _update_arch_monitor:
    - GUI: every key press/release except F9/F10 chrome (matches the
    K-line's connector-level semantic — even a bare Shift counts, Escape
    counts because break_program pushes it into the machine).
    - BOARD: K-line arrival st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
    [board_backend.py, gui_arch_monitor.py, gui_jmr_js.py]
2026-08-30 saucer fault SOLVED (mechanism) by run-60 F/T capture; log T-line arrivals
    First saucer kill on the run-60 bit delivered the forensics: fault 3
    kind=env with only 4/384 env slots live (pool ~99% empty), retried
    False. Env allocator free-list state bug, not exhaustion/leak/value.
    T-line decodes the whole Saucer.points() body completing and the
    return landing at the call site — death on the CALL_METHOD frame's
    env teardown seam, which is why every content reshape only moved the
    fault. Content side is done; full decode handed to RTL.
    Also: T-lines were stored but never logged, so the flight log could
    not prove their arrival — now logged as "TRAIL <8 hex ips>".
    [board_backend.py]
2026-08-30 monitor: fault line names the allocator on the main window; usage docs
    The headline fact from an F-line (which allocator, at-fault pools) now
    renders in the bottom status line with zero clicks:
    FAULT 3 at IP 1531 (L-) [env alloc - pools env 4 arr 21 obj 689] - click REGISTERS
    Old bits without forensics render the line byte-identically to before
    (xvfb-tested: with forensics, without, and no-fault cases).
    ARCH_MONITOR.md: new "Where the run-60 telemetry appears in the GUI"
    section (main window vs inspectors vs flight log); refreshed the two
    sections the run-60 reality made stale ("the board sends three
    numbers" and "What BOARD still cannot do"); recorded the first
    hardware capture and its t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
2026-08-30 run 61: FIND caches awakened — concat-handoff entries never armed the cache phase (the 4-way FF cache was blind to the dominant find class since birth) + 1024-entry generation-tagged bucket cache (pu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
2026-08-30 fix run-60 poll-fire double-shot: frame-cooldown gate in ASTEROID/MISSILE
    Board testing found a physical fire tap firing 2-3 bullets in ASTEROID
    and MISSILE COMMAND (1 under heavy frame load). Both titles poll the
    held-fire state every frame for hold-to-repeat, and a ~40-80ms tap
    quantizes to 2-3 polls at 60fps; RTL-side fix was rejected as too risky
    for hold-repeat semantics, so this is content-side.
    Add the INVFAST.HTML playerShoot() canShootAt pattern (frame-counter
    rate-limit, never edge-gate) as a hard backstop in each fire handler:
    - ASTEROID.HTML firePlayer(): new canShootAt global gated on the
    existing tick counter. Leaves the prior fireWait/edge logic in
    stepShip() in place as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
2026-08-30 compiler: inliner respects the 16-slot env wall — THE saucer-freeze fix
    Root cause (RTL-traced, blocking run 61): _try_inline_user_call spliced
    the callee's LET_VAR param binds into the CALLER's frame as extra keyed
    slots. animate() sat at exactly 16 declared locals (ENV_SLOTS), so the
    first executed inline of bumpScore's `n` was a 17th slot -> fault 3 at
    the S_HEAP_CMP env-slot wall — invisible to the loud 16-locals checker,
    which counted only source declarations. (Run-60's F-line kind=env was a
    stale latch from the previous alloc; the RTL side is adding fault-site
    tags so it names this wall directly next time.)
    Fix: refuse to inline when caller locals + callee params would exceed
    16,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
2026-08-30 forensics kept: envscan ring v3 (kind-3 alloc beat trace -> /tmp/envscan.log at fault) + VM debug visibility tags — the instrumentation that cornered the env-slot-wall saucer fault
2026-08-30 invfast: cut env-slot pressure in the shoot/collision path (1700-frame clean)
    Follow-up to 509baef. Verified against the RTL session's deterministic
    repro (continuous-fire spray, sim_build_dbg): the old card faults 3 at
    frame 25 (fsite=12945 = S_HEAP_CMP venv_len >= ENV_SLOTS); this card
    runs the full 1700-frame script with zero faults.
    - pickShooter rewritten onto names already keyed in the subtree
    (was 11 distinct: lowest/shooters/px/best/bestD/cx/d/col/i/inv/g);
    the module arrays are addressed directly instead of via aliases.
    - Invader.shoot: projectileSpeed inlined (one fewer keyed name).
    - renderLeaderboard: list/ol/li folded onto subtree names.
    - The idle/game-over frame moved out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
2026-08-30 telemetry: fault-edge ENVSNAP (fenv/flen/fkey/fvff/fvq/fmv — caught the stale-venv mux leak), SYNCPROF present-overlap bound probe (JMR_SYNCPROF=1), code_we/lenlife watchers, genuine-EXEC-beat gating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
    [jmr_js_core.sv, sim_main.cpp]
2026-08-30 run 62: delete the S_FB_SYNC present spin — the VM no longer waits out the 768k-clock DDR3 copy
    The copy now runs behind GC + S_WAIT_FRAME + the next frame's JS. One line
    of logic (else if (!fb_present_busy) -> else); everything else is comment
    and debug tags.
    MEASURED (SYNCPROF probe, 10 titles): the stall was 30.1% of ALL state
    cycles with zero S_WAIT_FRAME idle to absorb it. Per-present stall
    768,005 -> 14 clocks on every title; ~1.43x frame rate. Coverable
    fraction is 100% on all ten titles — the next frame's first draw lands
    170k clocks AFTER the copy ends (PACMAN tightest at +1.4% margin).
    A write fence at all 9 fb-write sites was built and dropped: 288 presents
    across 6 titles p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
    [sim_main.cpp]
2026-08-30 audio: phase-0 standalone beep test (ADAU1761 line-out proof)
    Smallest bitstream that can make a sound on J5 — no VM, no HDMI, no
    DDR3, no SD — per the line-out PSG plan's beep-test todo. Own build dir
    (build/audio_beep_test/), own XDC, Vivado guard that refuses to run
    while a board_flow build is up. NOT in sim CORE_SRCS, NOT in
    tools/board_flow. I2C master is a deliberate snapshot so an audio
    experiment can never perturb rtl/phys/jmr_i2c_master.sv.
    Design: private MMCM 100MHz x12/100 = 12 MHz MCLK; FPGA is I2S master
    (BCLK = MCLK/4, LRCLK = MCLK/256 -> fs 46.875 kHz, 32-bit slots); codec
    is slave on MCLK direct, no codec PLL. 440 Hz square gated ~2 Hz, so it
    cannot be confused with hum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
2026-08-31 audio: line-out PSG integrated (plan fpga_line-out_psg phase 1) — sound() nid 42 now reaches hardware
    - rtl/phys/jmr_psg.sv: 4-voice PSG (3 square + LFSR noise) + I2S master,
    12 MHz mclk leaf, 0 BRAM / 0 DSP / no extra MMCM. ~60 Hz frame envelope
    (frames countdown + signed Hz/frame slide), vol<<13 amplitudes, 4-voice
    sum stays inside 24-bit signed (no clamp needed). keep_hierarchy.
    - rtl/phys/jmr_adau1761_cfg.sv: live copy of the bench-verified phase-0
    codec init (tools/audio_beep_test stays a frozen snapshot by design).
    - exec64: nid-42 arm now latches (ch,freq,vol,frames,slide) via
    v64_to_int32 (the draw-native arg shape) and flips snd_tgl; still
    always-succeeds. Fields satur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
    [jmr_adau1761_cfg.sv, jmr_js_core.sv, jmr_js_vm_exec64.sv, jmr_psg.sv, nexys_video.xdc, top_nexys_video.sv]
2026-08-31 run 63: restore the present write-fence — BOARD FIX for run-62's flashing
    Run 62 on glass: INVFAST/MISSILE/ASTEROID/FLDFAST flashed, DNKFAST's
    player vanished, INVFAST lost its gun and half the aliens. MRDOFAST and
    PACFAST (putImageData restore, no clear-then-redraw) were clean — the
    tell that named the mechanism: clear-first titles wiped the draw bank
    while the DDR3 present was still streaming it out.
    I dropped this fence before run 62 on sim evidence (288 presents, zero
    engagements, 170k clk of measured margin). That was the mistake: the
    present's true duration is SIM-INVISIBLE — it shares the DDR3 bridge
    with scanout on real silicon (the documented run-32/33 lesson). Sim
    margin doe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
2026-08-31 audio: mute was wired to ready_lit — silent in every game (run-63 board fix) + banner R64
    Board: run 63 was silent in SNDDEMO and ASTEROID. Not the codec, not the
    content, not the PSG — the mute polarity at the top level, mine.
    ready_lit means 'console FSM is in C_IDLE/C_PROMPT', NOT 'at the prompt'.
    The console engine is DISABLED while a program runs
    (jmr_js_core: .enable(standalone_mode && !game_mode)), so its FSM parks
    in C_IDLE and ready_lit reads TRUE for the entire duration of every game.
    Mute therefore asserted exactly when sound was wanted. The plan's phrase
    'mute on ready_lit (BREAK -> READY)' invited that misreading.
    Fix: mute = ~game_mode. game_mode clears on ESC and on halt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
    [jmr_console_engine.sv, top_nexys_video.sv]
2026-08-31 mk: edge-trigger punch/kick (held button re-fired the sound every frame)
    Board report: joystick fire "fires twice". Root cause in MKBIG/MKBIGCPU
    is content-side, not the joystick PHY: control() polled the HELD button
    every frame, so one physical tap (~40-80ms = 2-5 frames, and MORE as the
    machine gets faster) re-ran playSfx and re-asserted f.atk on every frame
    of the press. setAnim() self-guards on name equality, so the ANIMATION
    looked correct while the sound stuttered 2-3x — which is why this hid.
    Fix: fire on the rising edge only (k.punch && !f.pPunch), tracked in
    object PROPERTIES so it costs no env slots against the 16-per-function
    wall. Trackers update OUTSIDE the block/onGround gat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
2026-08-31 Revert "mk: edge-trigger punch/kick (held button re-fired the sound every frame)"
    This reverts commit 270b20a3bd9577781dc5f08217aea02e44b5b443.
2026-08-31 fit: jn_bucket 1W merge — recover ~13.8k LUTs + ~24.7k FFs from the FIND bucket
    Run 64's synth log: 'Applying attribute ram_style = block is ignored,
    object jn_bucket[N] is not inferred as ram due to incorrect usage'. The
    1024x24 bucket therefore landed entirely in fabric on a design already
    fighting the router (96.6% BRAM, and runs 62/63/64 each ground through
    repeated global routing iterations).
    Cause, the documented multi-write signature: jn_cache_remember() is a
    task with TWO call sites, so the array carried two write statements.
    Fix is the vstack/vframe/venv_gen recipe — one registered write port
    (jnb_we/wa/wd), single write statement beside the registered read.
    The insert now lan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
2026-09-01 run 65: ARTX hooks, editor hooks, compiler diagnostics, dead-state reclaim
    ON-MACHINE ART COMPILE (.ART sidecar):
    - HOOK 1 pre-load at COMPILE: builds NAME.ART (FAT 8.3 truncates .ARTX on
    the card, so the 3-char form is what exists), opens it, streams the
    header into the arena at CSTG_ART_OFF and the PAYLOAD into CART, sets
    CSTG_HDR_ART, then chain-loads ARTSCAN. A missing sidecar is not an
    error: the flag reads 0 and a no-art title compiles exactly as before.
    - HOOK 2 cdone status 0x85: mint the image, then append the payload.
    Hooks into the existing mint pump where it would otherwise close.
    TWO DEPARTURES FROM THE SPEC, BOTH FORCED BY THE HARDWARE:
    1. The payload is staged in CA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
    [jmr_console_engine.sv, jmr_js_core.sv, sim_main.cpp]
2026-09-01 run 65 fix: synchronise src_len into the VM — it was a CDC into the worst cone
    Run 65 routed at WNS -0.661 / TNS -1.843 and EVERY violating path was the
    same one: u_cons/src_len_reg[N] -> u_exec64/vst_wdata_reg[M].
    srcLen (nid 43) reads the console's src_len register. That register lives
    in the CORE clock domain; the VM runs on clk/VM_CLK_DIV. Wiring it straight
    into exec64 put a cross-domain COMBINATIONAL path directly into the
    vst_wdata funnel — the documented worst cone in this design (103 logic
    levels, the run-57 census leader). Not placement luck: a real fault, and
    an unsynchronised crossing besides.
    Fix: two flops in the VM clock domain. Breaks the path AND makes the
    crossing a p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
2026-09-01 edit working, fixing compile!
    [backend.py, board_backend.py, gui_jmr_js.py, js_vm.py]
2026-09-01 run 65: the editor is a GAME, the compiler is a batch tool — the real board fixes
    The board session on 65a plus sim forensics unwound to FOUR bugs; the last
    two overturn the earlier keyboard diagnosis:
    1. THE EDITOR RAN INVISIBLY. cmp_arm held game_mode low for every chain
    program, and game_mode is what switches the display to the framebuffer.
    Under EDIT the editor launched, drew, and took key events — behind the
    text screen. Under RUN it became visible, which is why "RUN opened the
    editor". The 172 s compile watchdog then killed the invisible session
    as ?IO. Key events were never gated at all (the kev path has no
    game_mode term) — the earlier kbd_clear theory was wr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
    [jmr_console_engine.sv]
2026-09-01 editor/compile round-trip: sticky cdone cleared at p_clr, SAVED. reply, full PS/2 keymap, sim SD flush on pump, GUI F-key forwarding
2026-09-01 console: cdone edge gate — accept cmp_done only after seen LOW since launch (stale-status race made COMPILE answer OK/SAVED. instantly; compile-twice workaround explained)
    [jmr_console_engine.sv]
2026-09-01 banner V1.5 R68 — on-machine EDIT + COMPILE are the V1.5 milestone
2026-09-01 G-line fault telemetry: fault_site+faulting value over UART; parent adopts exec64 fault_site (was stale for every exec64 fault)
2026-09-01 board compile fixed: art-flag sanitation (garbage flag read sent BOXES down the art-append path, runaway copy = the fault 5), MSG_OFF 0->128 (?CE messages were writing where the console never reads),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
2026-09-01 docs: V1.5 is live — G-line/STOR-BEAT forensics in ARCH_MONITOR, runs 65-68 ledger, self-hosted loop in JS_COMMANDS, F3-quit fix, cross-lane handoff (MSG_OFF=128, arena=380928, art-flag root cause op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
2026-09-01 compiler w64: extract mantissa by repeated doubling — the (v-1)*2^52 multiply lost every mantissa bit on the VM (constants collapsed to leading powers of two: 0.64->0.5, 640->512 = PACFAST half-scale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
2026-09-01 compiler: typeof emits native 40 — TYPEOF_NI was forever -1, the garbage nid poisoned the first typeof (PACFAST's per-cell map check = compiles-but-never-runs)
2026-09-01 compiler: typeof via interned name (rewriteOps maps names->nids — raw 40 was wrong, would misresolve); window.* unknown-API calls lower to stub 33 like the host (no more hand-edits to compile browser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
2026-09-01 run 69 bug list — collected, not started
2026-09-01 compiler: CALL_VAL argc in arg0 (RTL reads opw[23:8] — it was in arg1, every value-call got argc 0); IIFE MAKE_FN gets a1 bit6 (flat caller-chained env) like the host — PACFAST's whole-program wrappe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
2026-09-01 artscan: jmr:spr title with no staged .ART says NO ART (save-as drops the sidecar; ART V1.5 was misleading)
2026-09-05 gui/board: no more frozen console on BOARD waits
    - board_backend._wait_glass pumps the GUI (run_wait_idle) and bails early
    on an error reply; SAVE-after-put waits 30 s max and reports the board's
    actual ?-reply instead of a 90 s dead window.
    - board_backend.more_waiting: -- MORE -- on the mirror lets the GUI page
    DIR/LIST with Space and keeps the prompt overlay off the listing.
    - gui: BOARD gets the same Tk pump FPGA-SIM had.
    [board_backend.py, gui_jmr_js.py]
2026-09-05 board gui: refuse artless RUN loudly; no prompt overlay while listing
    - compile-on-RUN of a jmr:spr title with no .ARTX/.ART sidecar used to
    stream an art-less image that faulted on the board and left the GUI
    in "running" with a dead console; now refused with ?NO ART on glass.
    - _prompt_row returns -1 when no prompt row exists (-- MORE --), so the
    "> " overlay no longer hides the last DIR entry.
    [board_backend.py]
2026-09-05 board gui: wait for a NEW SAVED + prompt per put (DIR * was typed mid-write); list SD-wait watchdog
2026-09-05 console: retire the inline numbered-line editor (23 FSM states)
    EDITOR.JSH is the one editor (user ruling, run 65). `EDIT n` and typed
    numbered lines now answer ?SN. Frees 23 of the console's 128 state
    encodings (128/128 -> 105/128) for run 71's CRC / STATUS / burst work and
    removes the edit_* parse cone. C_LIST_PEEL (the LOADED digit printer) is
    untouched.
2026-09-05 run 71 A: CRC-32 trailer on 0xFC/0xFD transfers, ?CK, reply_sel 5-bit
    uart_link computes CRC-32 over the payload and reads a 4-byte trailer
    (JSH_C0..C3); a mismatch raises jsb_tether_crc_err with eof. The console
    discards a bad SOURCE put (src_len 0) or refuses to start a bad program
    stream, answering ?CK (new reply row 16; reply_sel/rsel_q/reply_char
    widened to 5 bits). Host appends zlib.crc32 and resends on ?CK (x3).
    Sim: TETHER_CRCERR rpc injects the flag for the gate.
2026-09-05 run 71 B: S_SD_WAIT watchdog — a silent SD card fails loud instead of wedging
    storage_engine: 27-bit sd_wd in S_SD_WAIT (~1.3 s); on expiry S_SD_ABORT
    pulses a new abort input on sd_spi_master (CS high, idle), poisons the
    mount and takes S_ERR (?IO). Next op remounts at INIT_DIV. Sim: SD_HANG
    rpc makes the card model mute; gate shows ?IO then a working DIR.
    [sd_spi_master.sv, storage_engine.sv]
2026-09-05 run 71 G: STATUS command — what the machine holds
    NAME <title> LEN <bytes> [TRUNC] HTML|JS|-- FAULT <site> <arg>. Two
    console states (C_STATUS/C_STATUS_CH) reusing the LOADED name printer and
    the LIST digit printer through st_mode; fault site/arg come from the
    G-line registers (vm_gdbg -> console). p_status_q is a registered
    predicate like its siblings.
2026-09-05 run 71 C (instrument) + H: storage op-duration on the E line; USB reopen on errno 5
    storage_engine counts clocks per op (x256, saturating 16 bits) ->
    core -> top -> uart_link appends 4 hex digits to the E beat (Exxyyzzzz);
    board_backend logs STOR-BEAT ... op_ms= so LOAD/COMPILE time can be
    split into SD-sector vs handshake before any burst path is built.
    Host: [Errno 5] on a tether write reopens the port once and retries.
2026-09-05 run 71: big put (0xFB -> CART, SAVE pumps via art-append) + fix CART low-byte drop
    - uart_link: tag 0xFB = same length+CRC-32 framing as 0xFC, raises jsb_tether_big
    - console: C_BIG_TETHER/C_BIG_WR stage bytes 2/word into CART (111/128 states);
    SAVE with a staged put runs the mint art-append loop (img_len 0), replies SAVED;
    bad CRC -> ?CK and nothing staged; > 2,961,408 B -> SAVE says ?TR
    - BUG FIX: the bank-1 SRAM client wrote {8'd0, byte} for every word, so the
    on-machine art stager (C_ART_GBW) dropped every CART low byte; src_w16/src_wlo
    now carry the held low byte (big-put roundtrip gate pins the 16-bit path)
    - board_backend: files > SOURCE_MAX ride 0xFB with CRC + 3 retries (no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
    [board_backend.py, jmr_console_engine.sv, jmr_js_core.sv, jmr_uart_link.sv, sim_main.cpp, top_nexys_video.sv]
2026-09-05 run 71b: retire two cross-domain cones (run 71 WNS -0.448)
    - fb_scanout: split the line-address cone (compare+inc+x320 DSP+base add,
    10-11 levels, -0.448 leader, thinned runs 50/52/70b) into two register
    stages; want_qq rides beside line_base_q so both come from one beam sample
    - jmr_js_vm: start_q/stop_q registered on vm_clk — the 100 MHz stop latch sat
    atop the priority chain and made every register CE a 10 ns cross-domain cone
    (-0.256, ~40 endpoints); both delayed one beat so their order is unchanged
    - left alone: u_sram_br/rdata -> vst_wdata[49:48] (-0.242), ack/hold semantics
    - SESSION_HANDOFF: run 71 build ledger
    - gates: engine gates + console_log + snippet subset 51/51 on t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
2026-09-05 run 71c: retire the CSR-read crossing + LIST parser end compares (71b leaders)
    - jmr_js_vm S_CSRAM: capture sram_rdata[7:0] into csr_rd_q (vm_clk) at the ack,
    finish the op one beat later — the clk100 bridge register fed the vst_wdata
    funnel with a 10 ns budget and led every 71b placement (+0.009/-0.077/-0.163)
    - console LIST-range parser: name_i >= line_len / name_i+1 >= line_len registered
    (ni_end_q/ni_end1_q) beside the existing ni_q stall (71b flow leader -0.134)
    - new RTL gate test_rtl_run71c_csram_read_write_two_beat (srcByte/srcLen/
    stgRead/stgWrite; the compile ABI's memory state had no RTL gate before)
    - SESSION_HANDOFF: 71b + horse ledger; horse AltSpreadLogic_high bit pu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
    [jmr_console_engine.sv]
2026-11-03 Keep keyboard mode when the mouse moves, and record the J15 switch.
    A movement of 9 counts is the F10 byte, so the probe drops back-to-back mouse packets and shows the last 32 keys. The desktop handoff is docs/keyboard_mouse_switch.md.
2026-11-03 Mouse probe: J15 mouse and Pmod PS/2 keyboard at once, no mode switch. Fix inverted parity gate. Record JB/JA wiring and handoff.
2026-11-03 README: next-build input wiring (JA kbd, J15 mouse, JB stick) at top; fix stale keyboard line
2026-11-03 Land the shared Mac menus in RTL and add the Gauntlet titles.
    FPGA-SIM now follows the Python desktop, file dialogs, and document save. The tested board bit remains run73o until the new build is qualified.
2026-11-04 Publish the current machine and keep the local archive off GitHub.
    Docs now match Finder, the 8 MiB map, the J15 keyboard with JA and JC mice, and run75 as the rollback while run76 is still being built. Retired notes stay in to_delete, which is gitignored.
2026-11-06 Publish current Toolbox and UI development snapshot
    Include the active 44-program working disk, resident services, RTL updates, and architecture documentation. Record open test and factory ROM consistency checks; FPGA timing and physical acceptance remain unqualified.
2026-11-06 Update run81 RTL, shared UI services and matched source disk
    Publish current-set manifest, GUI runtime verification, updated programs and documentation. Current-set verification passes; focused tests report 38 passed and one simulator ROM-bounds startup failure. FPGA qualification remains pending.
2026-11-06 Keep card.img as the only current disk image
2026-11-06 Update VM and graphics fixes and verify simulator freshness
    Publish matched run81 source updates and timing status. Current-set verification passes; focused graphics, bytecode, provenance and GUI tests: 297 passed, 4 skipped.
2026-11-10 Finder-only Mac-like system with a timing-met bitstream; repository cleanup
    - releases/current/jmr_js_mac.bit: setup +0.002 ns, hold +0.021 ns, 0 routing
    and DRC errors, 98,244 LUTs / 340.5 BRAM / 28,649 slices. Built from this
    source (run92 synthesis, ExtraNetDelay_high placement, refine.tcl).
    - RTL: retired 32-bit executor, built-in Finder branches, unreachable console
    states and seven uninstantiated files removed; no undriven nets.
    - Staged Vivado flow in tools/board_flow (module check, synth gate,
    implement, refine, qualify) and the simulator user-loop gate sim/user_loop.py.
    - Documentation rewritten to describe the current system; one README per
    directory; retired files moved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
2026-11-11 Update the current card image.
2026-11-11 Build 96: faster games, TRS-80 BASIC, timing-met release bit
    - Release bit: build 96 (run96b, Explore + refine), setup +0.005 ns,
    hold +0.022 ns, 0 DRC/routing errors; passes user loop, alert, Esc gates.
    - Speed: CopyBits streaming, blit cache, compiler optimizations, local
    spill; long arrays 16, globals 1024; Donkey Kong and CB games faster.
    - Fixes: FSTY name check (fault 9 on Centipede and others), VM stack
    overflow fault, Toolbox chooser, Finder no-extension docs, MacPaint
    toolbars and title, Mr. Do! actors, progress windows.
    - Finder: Enterprise About box, free icon dragging and Clean Up,
    horizontal scroll bar, Set Startup removed, .BAS opens TRS-80 BASIC.
    - New programs: TRS-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
2026-11-11 Keep git-ignored generated files out of CURRENT_SET.json
    update_current_set.py and verify_current_set.py now skip files git ignores
    (rtl/*.hex copies the build regenerates from vectors/), so a fresh clone
    verifies.
2026-11-12 Drive Prince from Mechner's sequence table, put that copy on the card as PrinceB, and widen the name table to 32 KB for the next bitstream.
    Finder window heads, Donkey Kong at two steps a frame, and the current Toolbox and disk image come with it.
2026-11-13 Build 97, a string library on the card, Compile that opens a file, and classic document icons.
    - Build 97 bitstream: 32 KB name table, Array(n) fill fix, optimized Toolbox.
    - Both compilers add STROPS.JS for string methods, parseInt/parseFloat/Number,
    Math.trunc/sign, Number.isInteger; hex/binary/octal literals and do...while
    compile; the on-machine tokenizer no longer mistakes f1 for do.
    - tbText and tbTextWidth take a string (DrawString), so drawn text makes no
    array. This fixes Compile's fault 3 (long-array pool) on the board.
    - Compile: File > Open... lists programs only. COMPTEST ships as source only
    (<!-- jmr-card: source-only -->) and reports 12 of 12 ok on the board.
    - Menu b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
2026-11-13 Publish build 99: most instructions in 3 clocks, local variables without a scope walk, exact Math.sqrt.
    Speed-ups on FPGA-SIM: Space Invaders 1.20x, MacPaint 1.19x, Donkey Kong 1.15x, Finder 1.11x, pure computation 1.38x. Timing met at 33.333 MHz, setup +0.089 ns, hold +0.041 ns, no waivers. The long-array promote keeps exec's stack head, so b[50]=9 is no longer lost.
    On-machine Compile works again: COMPILE.LNK matched build 97's compiler, so COMPILER stopped at STAGE2. The stage files are regenerated, the model now runs the bytes a card carries, and a test fails whenever COMPILE.LNK is stale.
    Finder's About shows the build number from CURRENT_SET.json on every card; a set_id without runNN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
2026-11-13 Bring the guides, Architecture Monitor and diagrams up to build 99; retire archive/.
    README is a getting-started page with a command table and the build-99 limits: 29,696 code words (up from 21,504), 32 KB names, 512 global slots including the Toolbox's. NEXT_BUILD now lists what the next .bit needs. FPGA_FIT, CONSTITUTION, COMPATIBILITY and GAME_DESIGN are corrected (25-bit / 64 MiB port, no run78 rollback), and repeated tables are merged.
    The Architecture Monitor reads its capacities from the model: the 64 MiB port, the Toolbox from TOOLBOX.ROM, 3-clock instructions, and the short and long array pools. The architecture and memory-map diagrams are regenerated from the same constants. lastr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
